Yndal/Dispenser-project/Designs/SparkFun/Hitec HS-35HD/hs-35hd pic.jpg

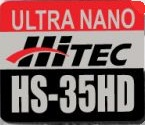
Designs/SparkFun/Hitec HS-35HD/hs-35hd pic.jpg
