Yndal/Dispenser-project/report/New structure/images/endstopLowered.png

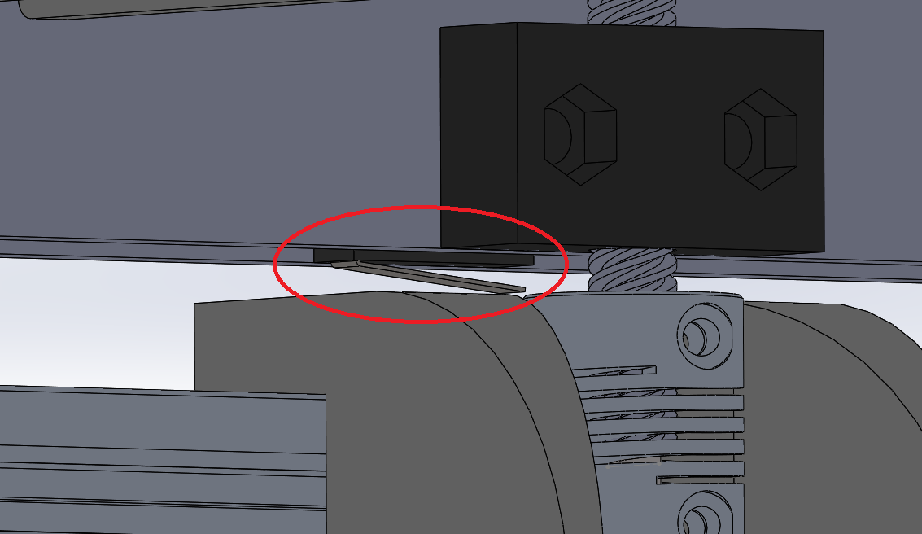
report/New structure/images/endstopLowered.png
