Yndal/Dispenser-project/Designs/Gripper/Xtreme V Wheel.SLDASM

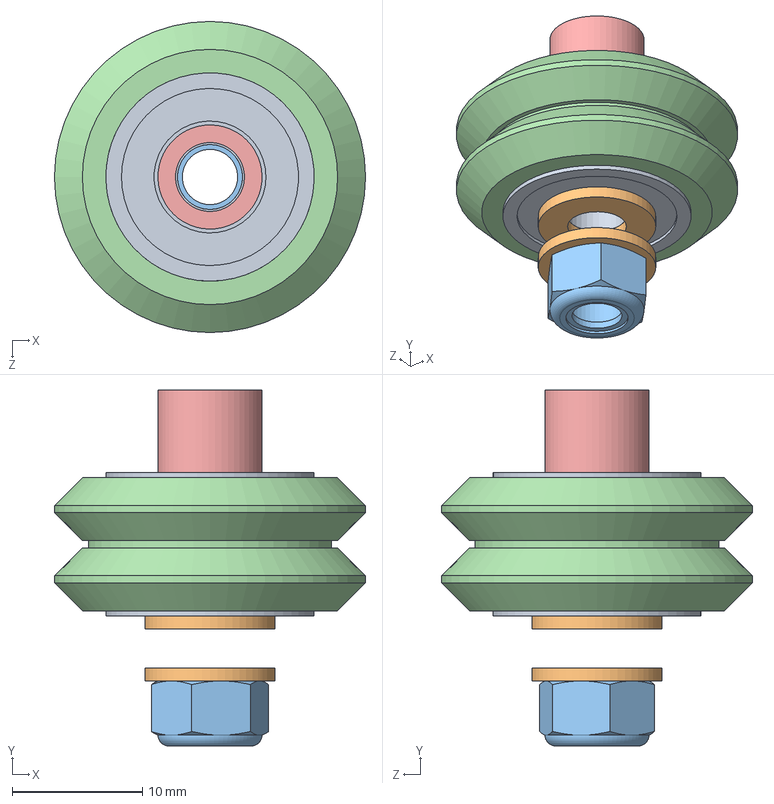
[picture p32: CAD file, 2016-06-13]
Designs/Gripper/Xtreme V Wheel.SLDASM
23.9 x 27.4 x 23.9 mm
Ball Bearing 5 x 16 x 5 x 2
Precision Shim 10 x 5 x 1 x 3
Nylon Insert Lock Nut M5
Delrin V Wheel
.25 Inch Aluminum Spacer
