Yndal/Dispenser-project/Designs/Horizontal axis/Horizontal_axis1.SLDASM

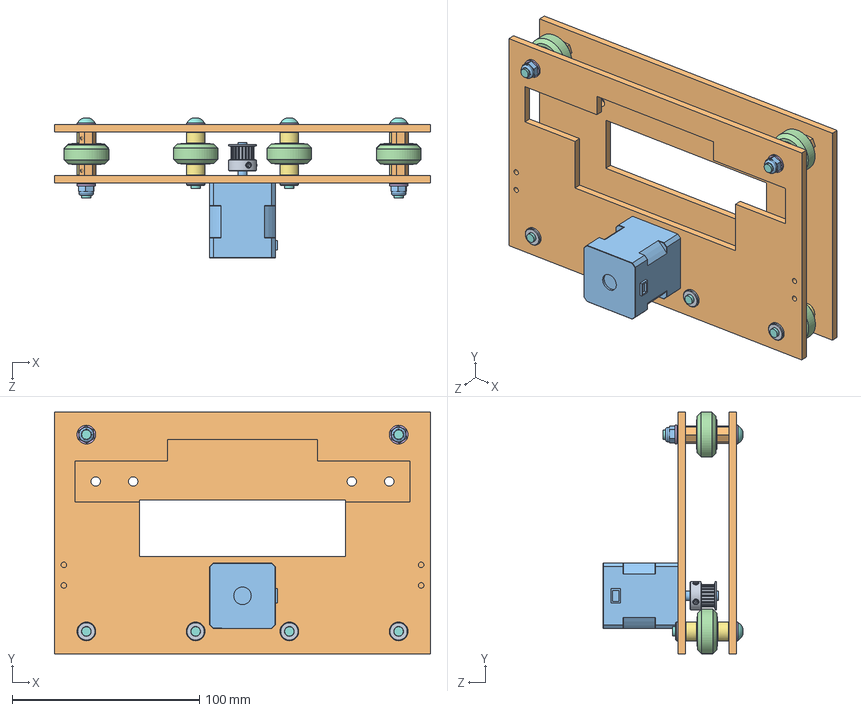
[picture p33: CAD file, 2016-06-13]
Designs/Horizontal axis/Horizontal_axis1.SLDASM
200.6 x 129.0 x 74.7 mm
GT2 2mm Aluminum Timing Pulley - 20 tooth
Horizontal_plate_front x 2
NEMA 14 Stepper Motor
Solid V Wheel x 6
Ball Bearing 5 x 16 x 5 x 12
Precision Shim 10 x 5 x 1 x 14
Aluminum Spacer 6mm x 8
screw x 6
insert_microbarb_0006M5-my x 4
Steel Eccentric Spacer x 4
nyloc x 2
