Yndal/Dispenser-project/Designs/StackPlatform/Stack_platform.SLDASM

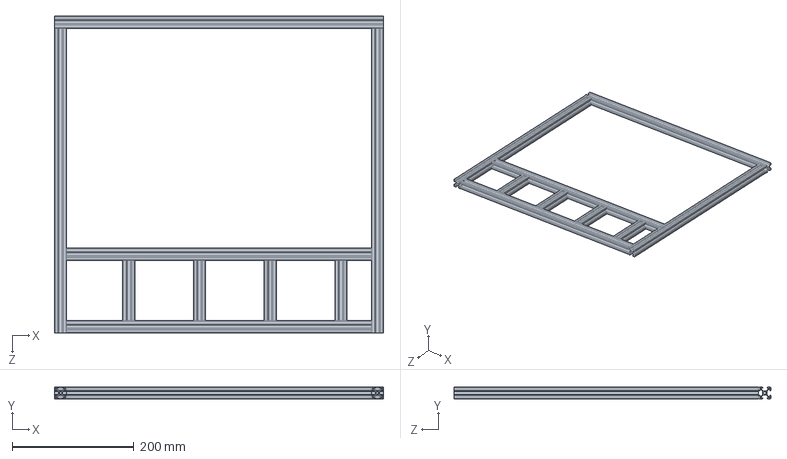
[picture p34: CAD file, 2016-06-13]
Designs/StackPlatform/Stack_platform.SLDASM
540.0 x 20.0 x 520.0 mm
V-Slot 20mm x 20mm x 1000mm x 9
