Yndal/Dispenser-project/Designs/SW2014 Parts Library 1.1 - orig/Assemblies/V Slot Belt and Pinion Actuator/Solid V Wheel assy.SLDASM

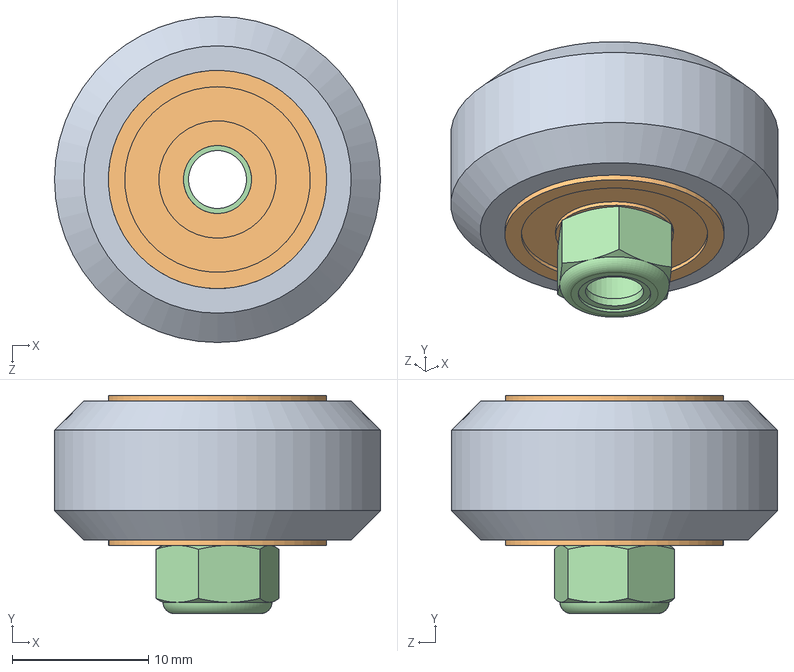
[picture p37: CAD file, 2016-04-22]
Designs/SW2014 Parts Library 1.1 - orig/Assemblies/V Slot Belt and Pinion Actuator/Solid V Wheel assy.SLDASM
23.9 x 16.0 x 23.9 mm
Solid V Wheel
Ball Bearing 5 x 16 x 5 x 2
Precision Shim 10 x 5 x 1
Nylon Insert Lock Nut M5
