Yndal/Dispenser-project/Designs/SW2014 Parts Library 1.1 - orig/Assemblies/Wheels/Xtreme Mini V Wheel.SLDASM

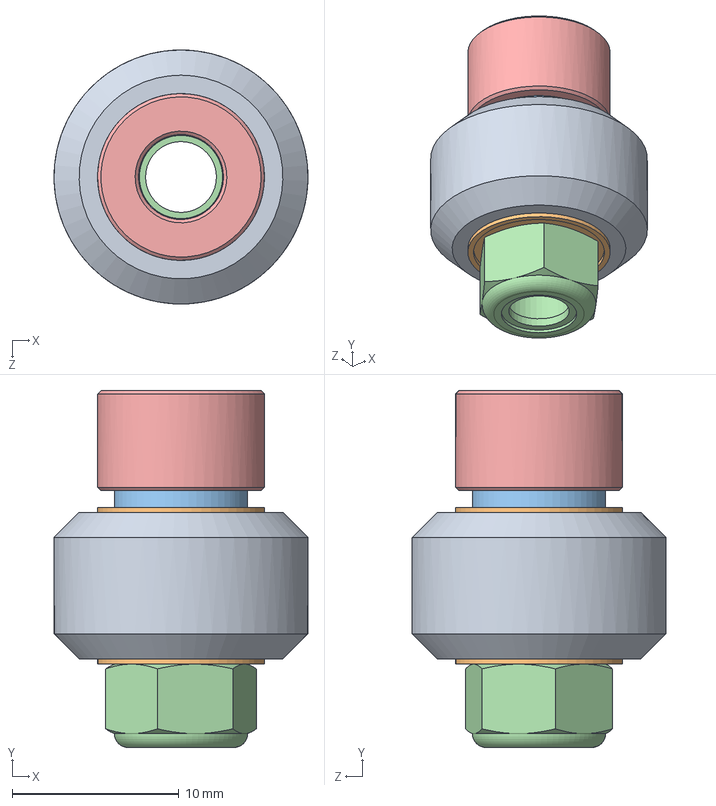
[picture p38: CAD file, 2016-04-22]
Designs/SW2014 Parts Library 1.1 - orig/Assemblies/Wheels/Xtreme Mini V Wheel.SLDASM
15.2 x 21.4 x 15.2 mm
Xtreme Mini V Wheel
Ball Bearing 5 x 10 x 4.2 x 2
Precision Shim 8 x 5 x 1 x 2
Nylon Insert Lock Nut M5
Aluminum Spacer 6mm
