Yndal/Dispenser-project/Designs/Gripper/Gripper.SLDASM

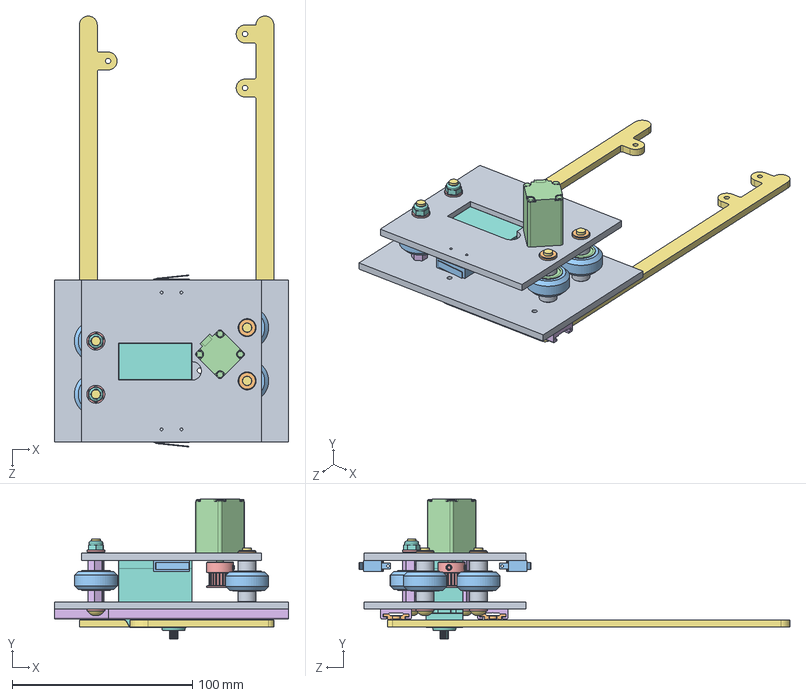
[picture p39: CAD file, 2016-06-13]
Designs/Gripper/Gripper.SLDASM
130.0 x 77.5 x 239.4 mm
MainPlate x 2
Sledge_NK_02_17_01_200_1 x 4
Solid V Wheel x 4
Ball Bearing 5 x 16 x 5 x 8
Precision Shim 10 x 5 x 1 x 10
Steel Eccentric Spacer x 4
screw x 4
nyloc x 2
Aluminum Spacer 6mm x 4
insert_microbarb_0006M5-my x 2
Micro Limit Switch x 2
NEMA 8 Stepper Motor (Pololu 1204)
GT2 2mm Aluminum Timing Pulley - 20 tooth
NS-01-17-100 x 2
Arm x 2
HX5010 SERVO
