Yndal/Dispenser-project/Designs/Horizontal axis/Horizontal_axis2.SLDASM

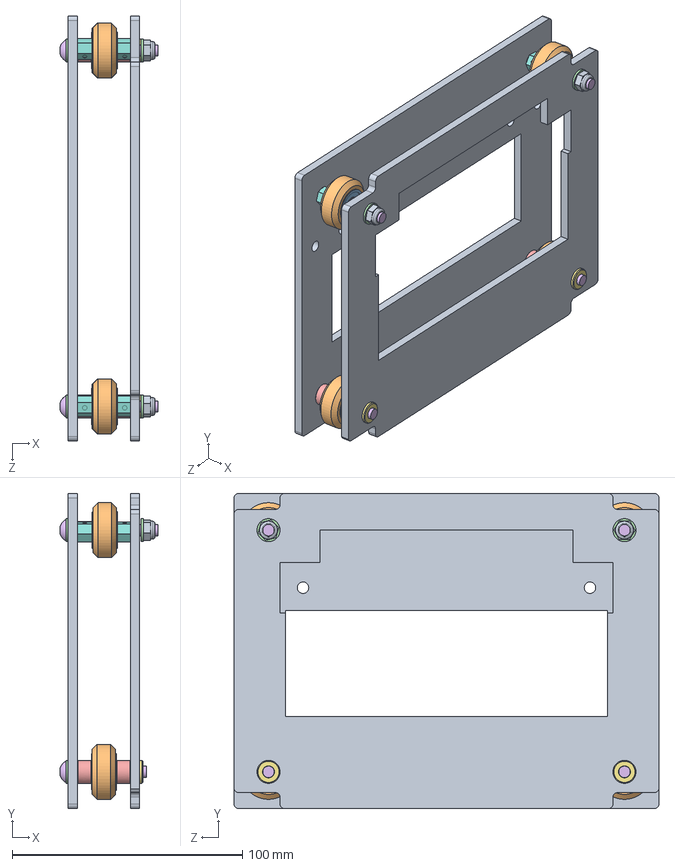
[picture p40: CAD file, 2016-06-13]
Designs/Horizontal axis/Horizontal_axis2.SLDASM
42.6 x 137.0 x 184.6 mm
Horizontal_plate_front x 2
Solid V Wheel x 4
Ball Bearing 5 x 16 x 5 x 8
Precision Shim 10 x 5 x 1 x 10
Aluminum Spacer 6mm x 4
screw x 4
insert_microbarb_0006M5-my x 2
Steel Eccentric Spacer x 4
nyloc x 2
