Yndal/Dispenser-project/Designs/SparkFun/Hitec HS-35HD/Hitec Ultra Nano HS-35HD.SLDASM

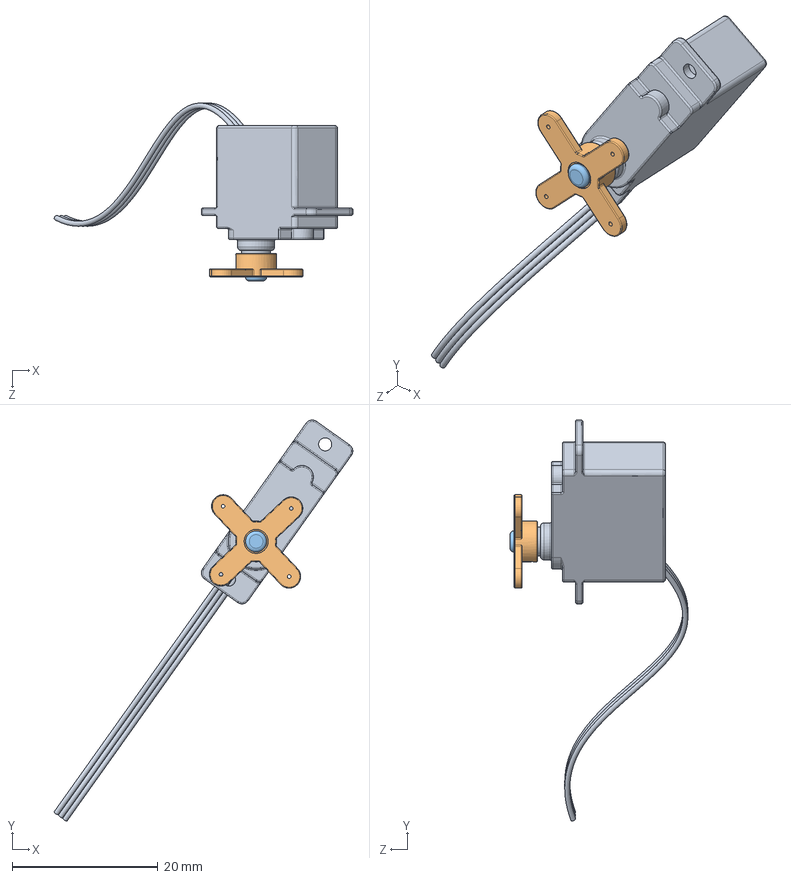
[picture p41: CAD file, 2016-04-22]
Designs/SparkFun/Hitec HS-35HD/Hitec Ultra Nano HS-35HD.SLDASM
40.9 x 54.9 x 24.4 mm
Hitec HS-35HD Ultra Nano Servo
servo horn
screw
