Yndal/Dispenser-project/Designs/SW2014 Parts Library 1.1 - orig/Assemblies/Wheels/Smooth Idler.SLDASM

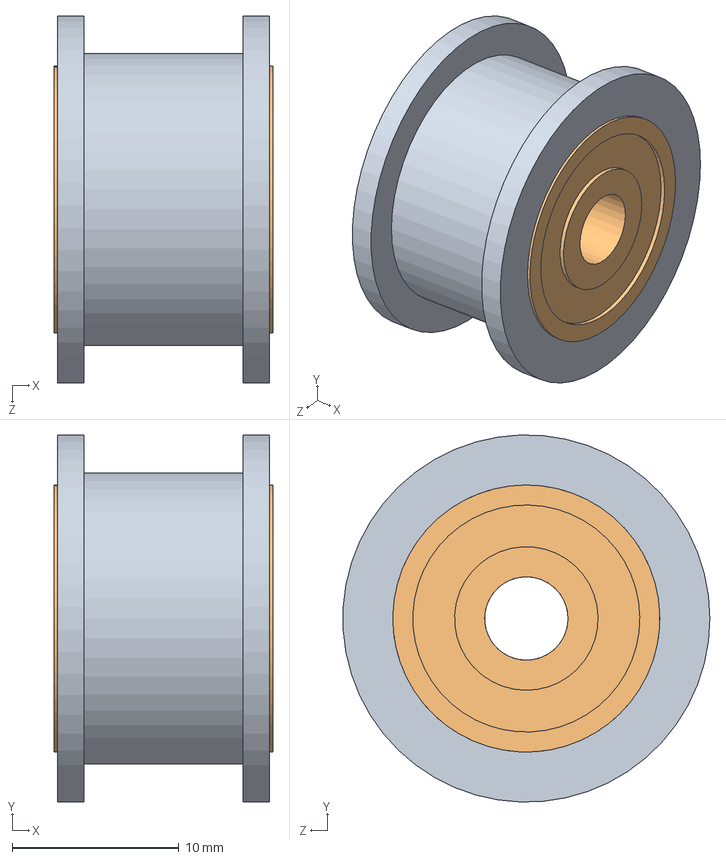
[picture p42: CAD file, 2016-04-22]
Designs/SW2014 Parts Library 1.1 - orig/Assemblies/Wheels/Smooth Idler.SLDASM
13.1 x 22.0 x 22.0 mm
Smooth Idler Pulley Wheel
Ball Bearing 5 x 16 x 5 x 2
Nylon Spacer 0.125in
