Yndal/Dispenser-project/Designs/Tests/WheelDist_20x40.SLDASM

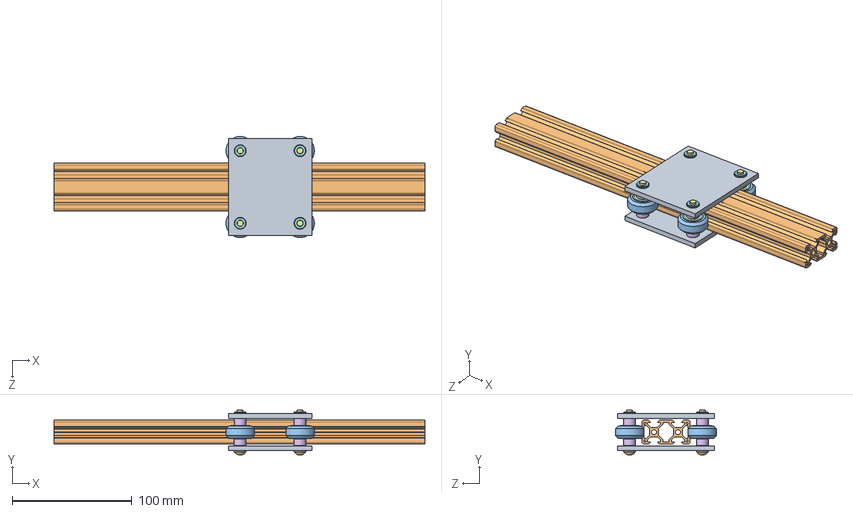
[picture p43: CAD file, 2016-04-22]
Designs/Tests/WheelDist_20x40.SLDASM
310.0 x 37.6 x 84.5 mm
Plate_20X40 x 2
V-Slot 20mm x 40mm x 465mm
Solid V Wheel x 4
Ball Bearing 5 x 16 x 5 x 8
Precision Shim 10 x 5 x 1 x 8
Aluminum Spacer 6mm x 8
screw x 4
insert_microbarb_0006M5-my x 4
