Yndal/Dispenser-project/Designs/Vertical axis/VertAxis.SLDASM

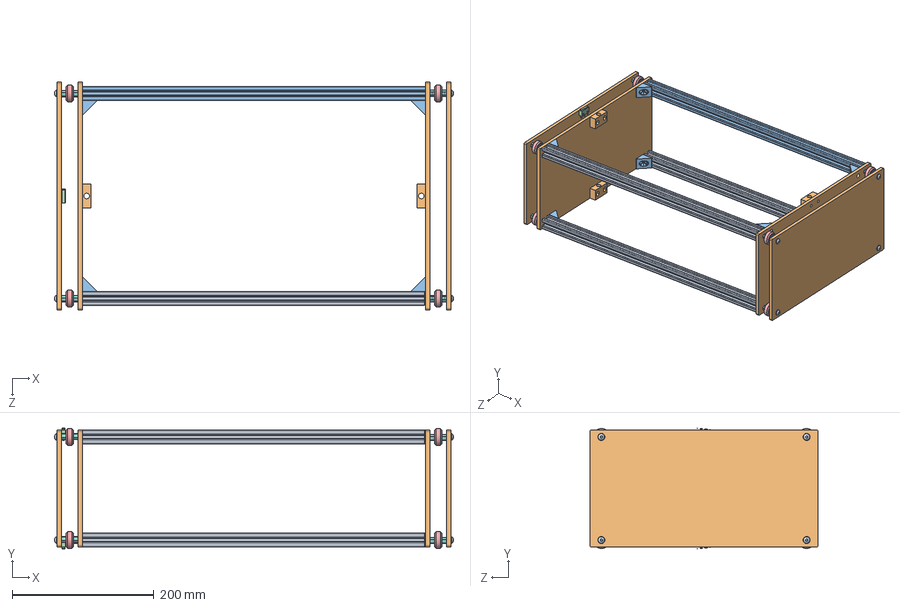
[picture p44: CAD file, 2016-06-13]
Designs/Vertical axis/VertAxis.SLDASM
563.6 x 170.4 x 321.8 mm
VertAxisAcrylic x 4
corner_connector_90deg x 8
Micro Limit Switch x 2
Solid V Wheel x 8
Ball Bearing 5 x 16 x 5 x 16
Precision Shim 10 x 5 x 1 x 16
Steel Eccentric Spacer x 16
screw x 8
8mm Acme Nut Block x 4
V-Slot 20mm x 20mm x 1000mm x 4
