Yndal/Dispenser-project/Designs/Gripper/MainPlate.SLDPRT

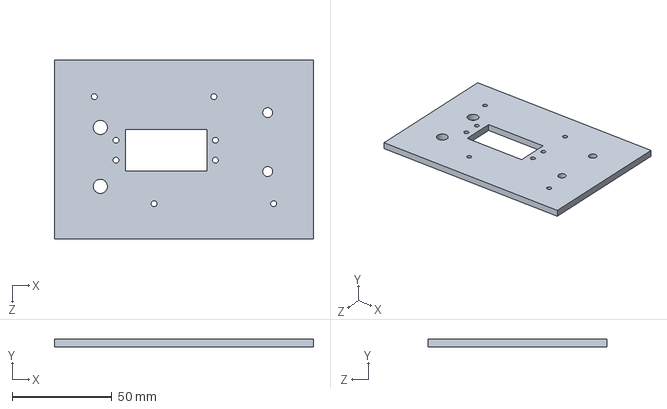
[picture p45: CAD file, 2016-06-13]
Designs/Gripper/MainPlate.SLDPRT
130.0 x 4.00 x 90.0 mm
