Yndal/Dispenser-project/Designs/OpenBuilds_r3/8 - Hardware/Lock Collar .25 inch.SLDASM

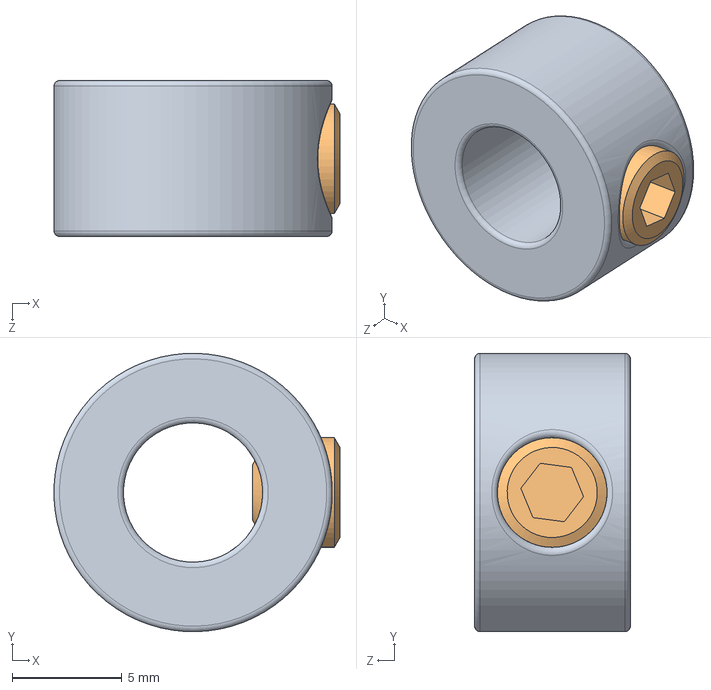
[picture p46: CAD file, 2016-04-22]
Designs/OpenBuilds_r3/8 - Hardware/Lock Collar .25 inch.SLDASM
13.0 x 12.7 x 7.11 mm
Lock Collar .25 inch
Socket Set Screw Cup Point_AM
