Yndal/Dispenser-project/Designs/Stack/Stack_wells.SLDASM

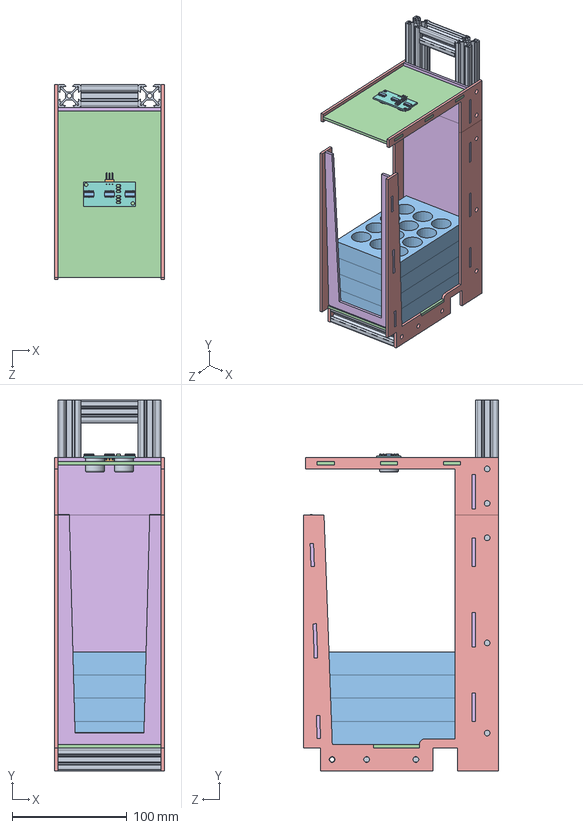
[picture p47: CAD file, 2016-06-13]
Designs/Stack/Stack_wells.SLDASM
96.0 x 323.0 x 170.0 mm
V-Slot 20mm x 20mm x 1000mm x 7
ElectronicsPlatform
Wells x 4
Top_wells x 2
Sides_wells x 2
FrontBack_wells x 2
EndPieceForElectronics
Parallax Ping PCB
Parallax Ping Transducer x 2
3 Pin Header 90 Degree
14 Pin SMT x 3
Cap1 SMT x 6
