Yndal/Dispenser-project/Designs/SW2014 Parts Library 1.1 - orig/Assemblies/V Slot Belt Driven Actuator/Nema 23 V Slot Belt Driven Actuator 500mm.SLDASM

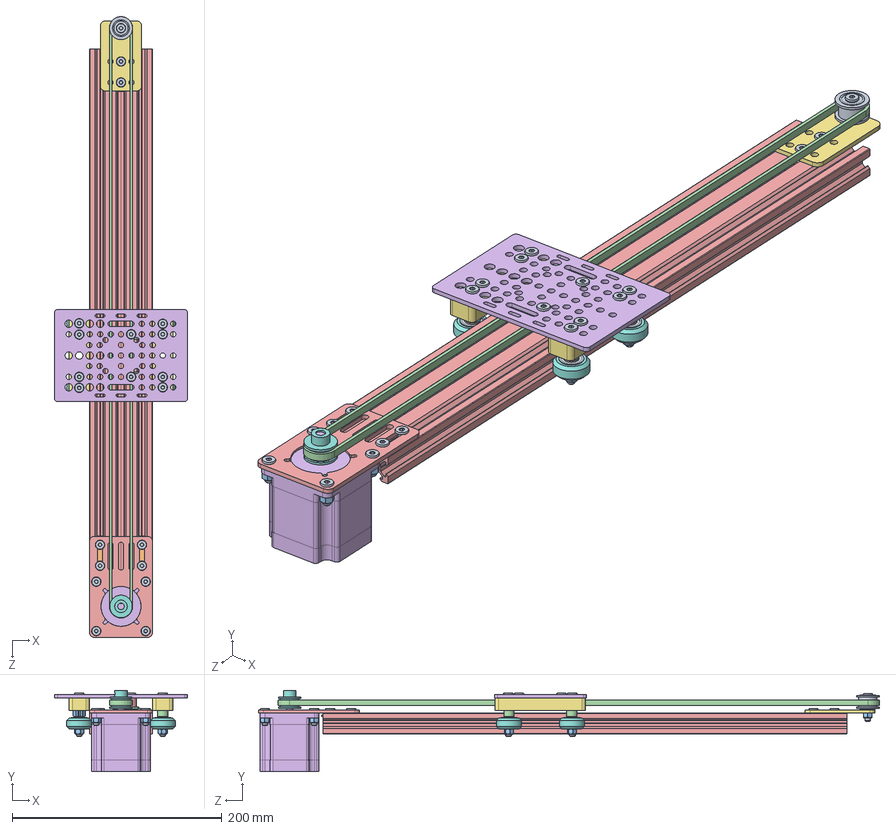
[picture p50: CAD file, 2016-04-22]
Designs/SW2014 Parts Library 1.1 - orig/Assemblies/V Slot Belt Driven Actuator/Nema 23 V Slot Belt Driven Actuator 500mm.SLDASM
127.0 x 77.6 x 592.7 mm
Low Profile Screw M5 x 21
Double Tee Nut x 3
Nylon Insert Lock Nut M5 x 9
Tee Nut x 2
V-Slot 20x60x500 Linear Rail
V-Slot Gantry Plate 20-80mm
Spacer Block x 2
Solid V Wheel x 4
Ball Bearing 5 x 16 x 5 x 10
Precision Shim 10 x 5 x 1 x 8
Eccentric Spacer 6mm x 2
Aluminum Spacer 6mm x 2
Motor Mount Plate Nema 23
Nema 23 Stepper Motor
Idler Pulley Plate
GT3 Timing Pulley 20 Tooth
Smooth Idler Pulley Wheel
Nylon Spacer 0.125in
Precision Shim 8 x 5 x 1
GT3 Belt 1160mm
Aluminum Spacer 9mm x 2
