Yndal/Dispenser-project/Designs/Horizontal axis/Horizontal_axis.SLDASM

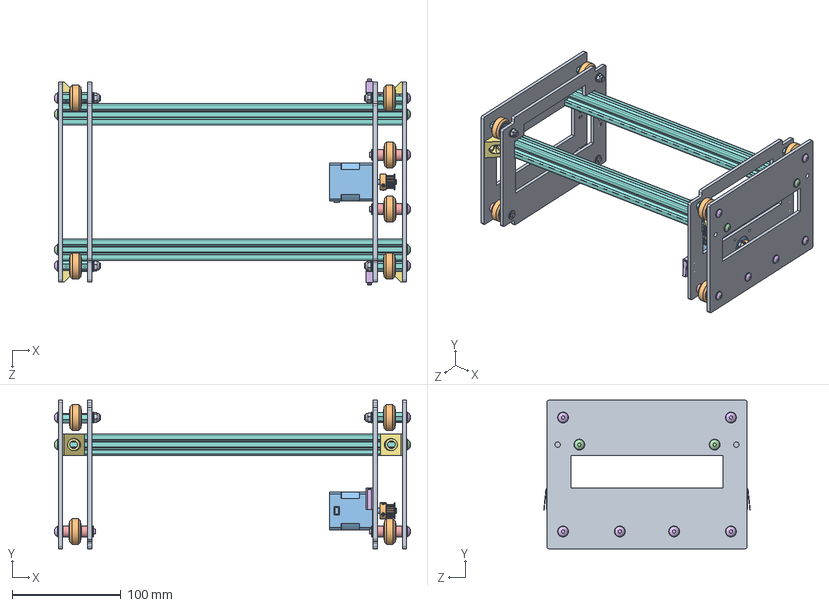
[picture p51: CAD file, 2016-06-13]
Designs/Horizontal axis/Horizontal_axis.SLDASM
328.0 x 137.0 x 190.2 mm
Horizontal_plate_front x 4
Solid V Wheel x 10
Ball Bearing 5 x 16 x 5 x 20
Precision Shim 10 x 5 x 1 x 24
Aluminum Spacer 6mm x 12
screw x 10
insert_microbarb_0006M5-my x 6
Steel Eccentric Spacer x 8
nyloc x 4
GT2 2mm Aluminum Timing Pulley - 20 tooth
NEMA 14 Stepper Motor
button_screw x 4
washer x 4
Micro Limit Switch x 2
corner_connector_90deg x 4
V-Slot 20mm x 20mm x 1000mm x 2
