Yndal/Dispenser-project/Designs/SW2014 Parts Library 1.1 - orig/Assemblies/Wheels/Xtreme V Wheel.SLDASM

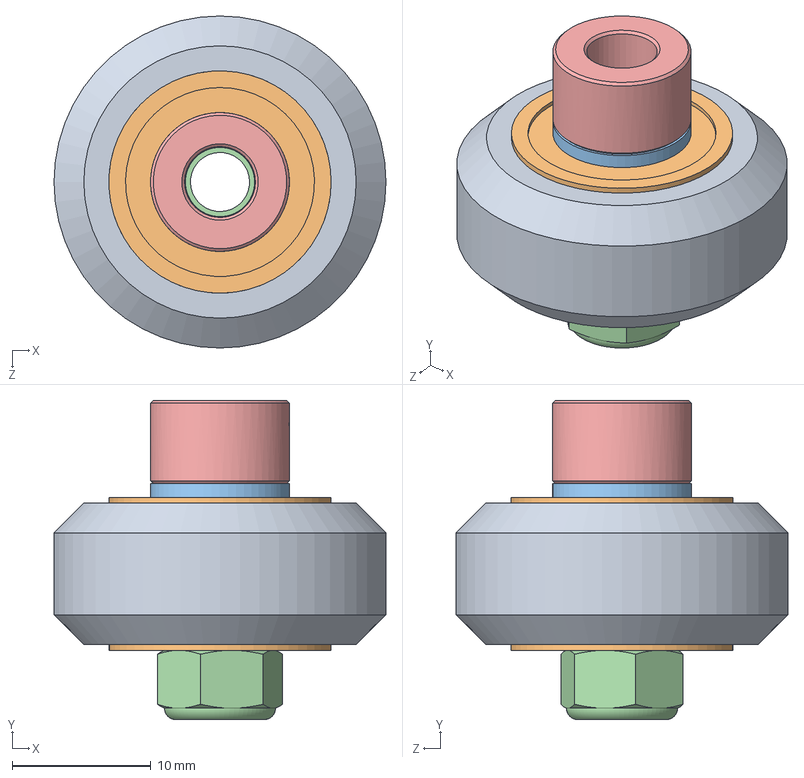
[picture p55: CAD file, 2016-04-22]
Designs/SW2014 Parts Library 1.1 - orig/Assemblies/Wheels/Xtreme V Wheel.SLDASM
23.9 x 23.0 x 23.9 mm
Xtreme Solid V Wheel
Ball Bearing 5 x 16 x 5 x 2
Precision Shim 10 x 5 x 1 x 2
Nylon Insert Lock Nut M5
Aluminum Spacer 6mm
