Yndal/Dispenser-project/Designs/OpenBuilds_r3/8 - Hardware/.25 inch x 5mm Flexible Coupling.SLDASM

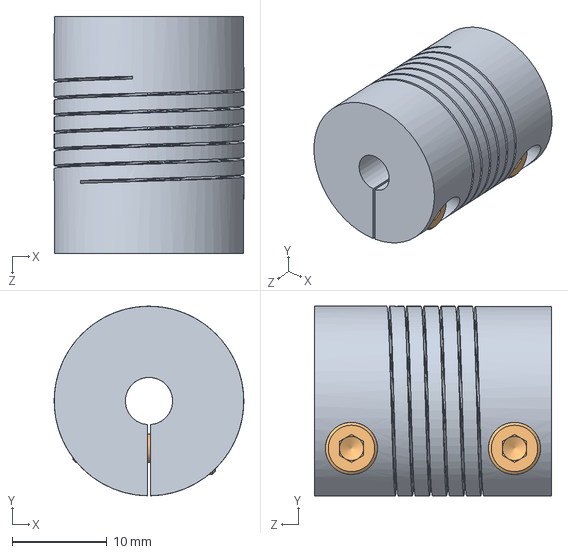
[picture p56: CAD file, 2016-04-22]
Designs/OpenBuilds_r3/8 - Hardware/.25 inch x 5mm Flexible Coupling.SLDASM
20.0 x 20.0 x 25.0 mm
.25 inch x 5mm Flexible Coupling
Socket Head Cap Screw_AM x 2
