Yndal/Dispenser-project/Designs/OpenBuilds_r3/9 - Plates/Universal Build Plate with Delrin V-Wheels for 40mm V-Slot.SLDASM

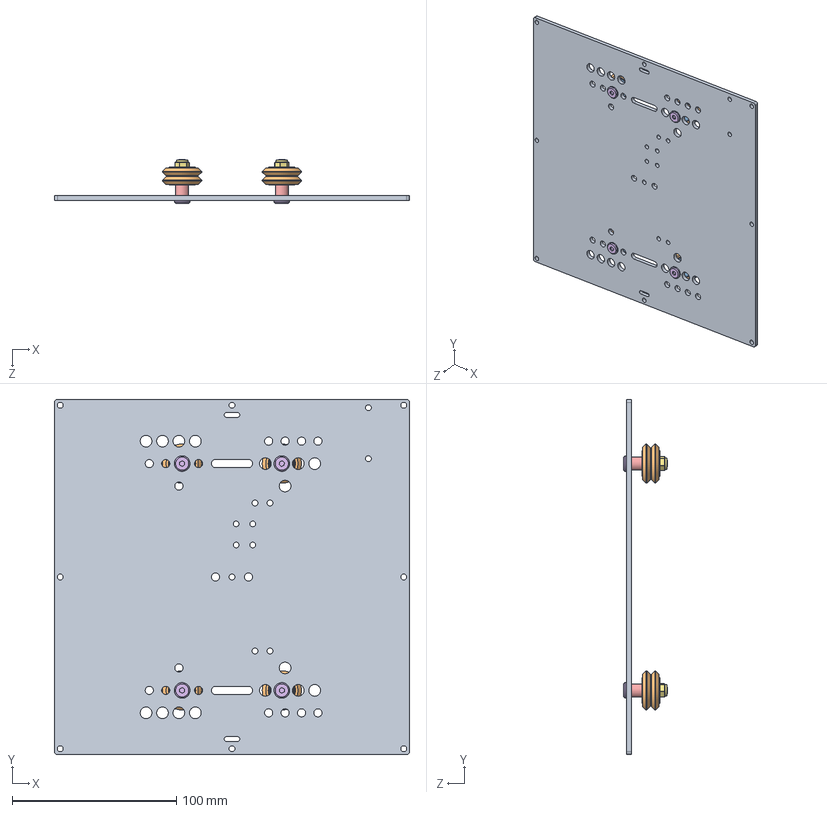
[picture p57: CAD file, 2016-04-22]
Designs/OpenBuilds_r3/9 - Plates/Universal Build Plate with Delrin V-Wheels for 40mm V-Slot.SLDASM
216.0 x 216.0 x 26.8 mm
V-Slot Universal Build Plate
Delrin Dual V-Wheel x 4
Precision Ball Bearing x 8
5mm Precision Washer x 4
.25 Inch Aluminum Spacer x 4
5mm Low Profile Socket Head Screw - Multiple Lengths x 4
Nylon Insert Hex Locknut 5mm x 4
