Yndal/Dispenser-project/Designs/OpenBuilds_r3/Assemblies/V-Slot Delrin Dual Wheel Bracket Assembly1.SLDASM

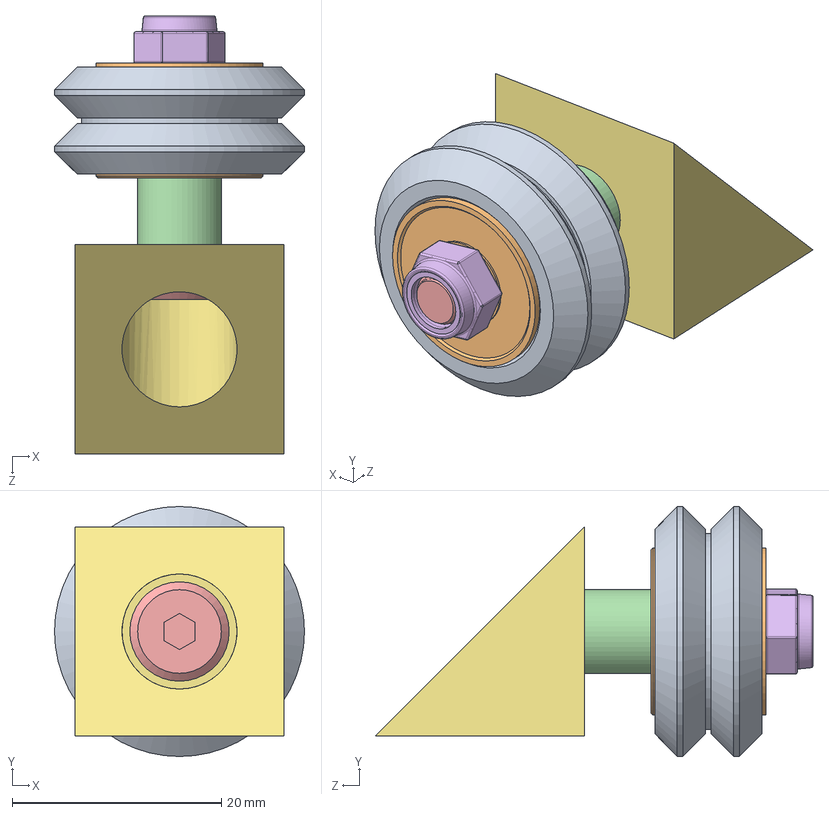
[picture p58: CAD file, 2016-04-22]
Designs/OpenBuilds_r3/Assemblies/V-Slot Delrin Dual Wheel Bracket Assembly1.SLDASM
23.9 x 23.9 x 41.8 mm
Delrin Dual V-Wheel
Precision Ball Bearing x 2
5mm Precision Washer
.25 Inch Aluminum Spacer
5mm Low Profile Socket Head Screw - Multiple Lengths
Nylon Insert Hex Locknut 5mm
90 Degree Angle Corner Connectr - V-Slot
