Yndal/Dispenser-project/Designs/OpenBuilds_r3/7 - Electronics/NEMA 17 Stepper Motor Assembly.STEP

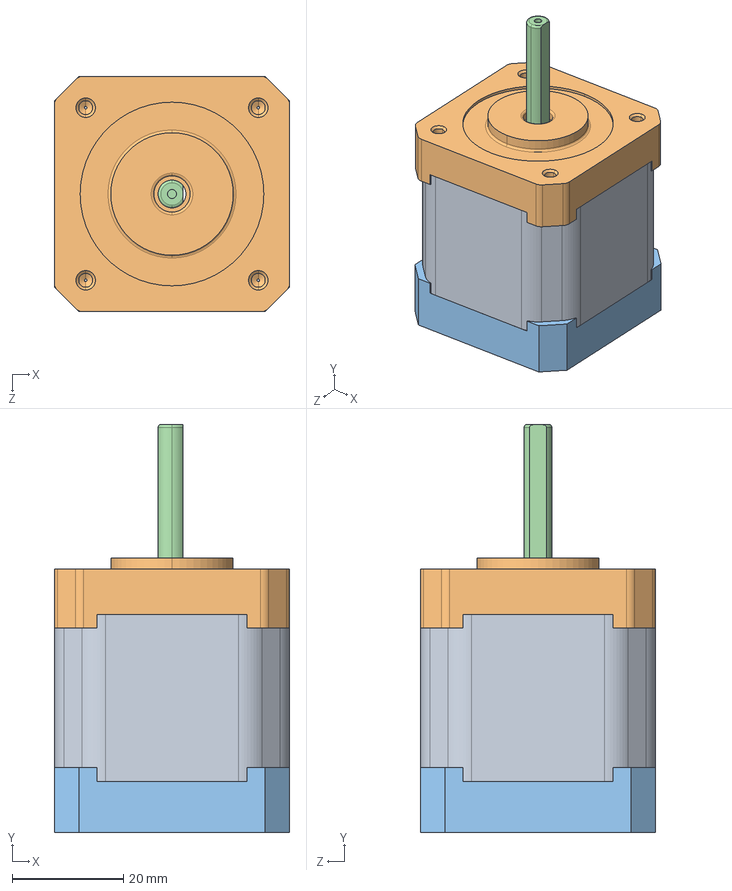
[picture p59: CAD file, 2016-04-22]
Designs/OpenBuilds_r3/7 - Electronics/NEMA 17 Stepper Motor Assembly.STEP
42.3 x 73.3 x 42.3 mm
NEMA 17 Stepper Motor Middle
NEMA 17 Stepper Motor Top
NEMA 17 Stepper Motor Bottom
NEMA 17 Stepper Motor Shaft
pan cross head_am_B18.6.7M - M2.5 x 0.45 x 13 Type I Cross Recessed PHMS --13N x 4
