Yndal/Dispenser-project/Designs/OpenBuilds_r3/8 - Hardware/Mounting Hub 5mm.SLDASM

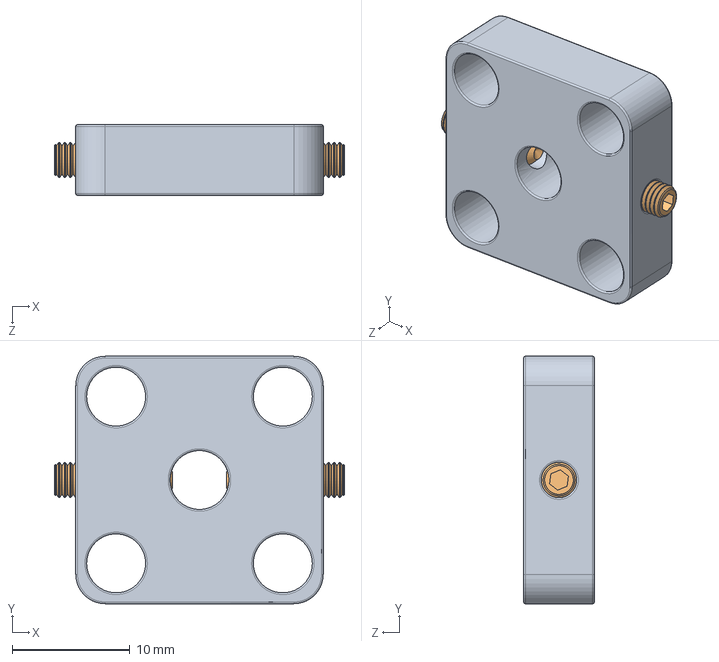
[picture p60: CAD file, 2016-04-22]
Designs/OpenBuilds_r3/8 - Hardware/Mounting Hub 5mm.SLDASM
24.6 x 21.0 x 6.00 mm
Mounting Hub 5mm
Socket Set Screw Cup Point_AM x 2
