Yndal/Dispenser-project/Designs/OpenBuilds_r3/Assemblies/V-Slot Delrin Dual Wheel Assembly.SLDASM

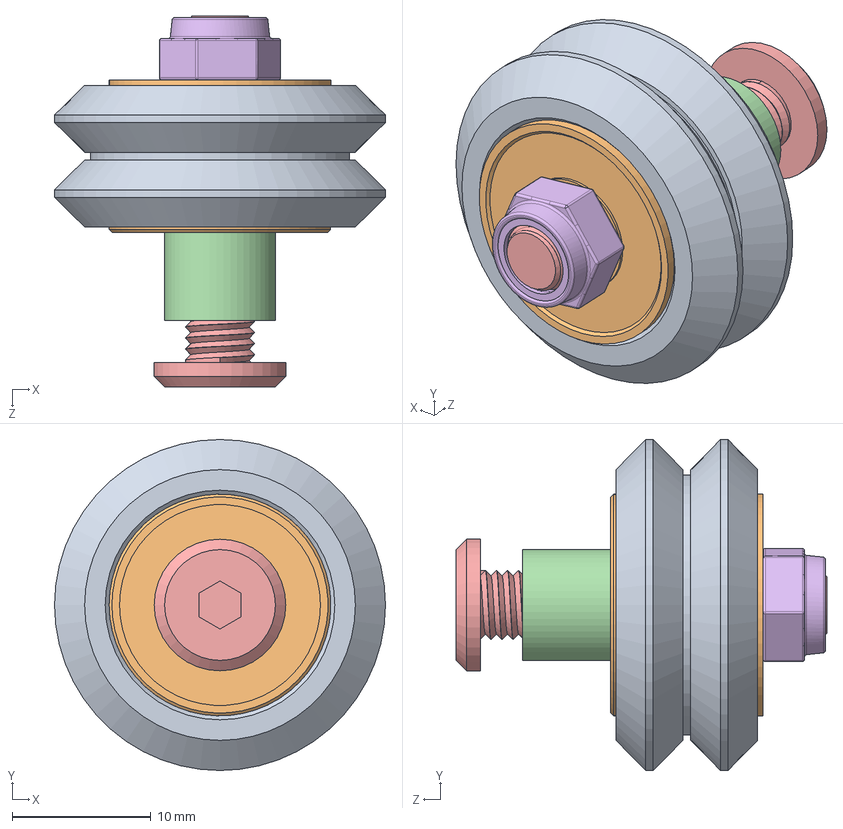
[picture p61: CAD file, 2016-04-22]
Designs/OpenBuilds_r3/Assemblies/V-Slot Delrin Dual Wheel Assembly.SLDASM
23.9 x 23.9 x 26.8 mm
Delrin Dual V-Wheel
Precision Ball Bearing x 2
5mm Precision Washer
.25 Inch Aluminum Spacer
5mm Low Profile Socket Head Screw - Multiple Lengths
Nylon Insert Hex Locknut 5mm
