Yndal/Dispenser-project/Designs/Stack/Stack.SLDASM

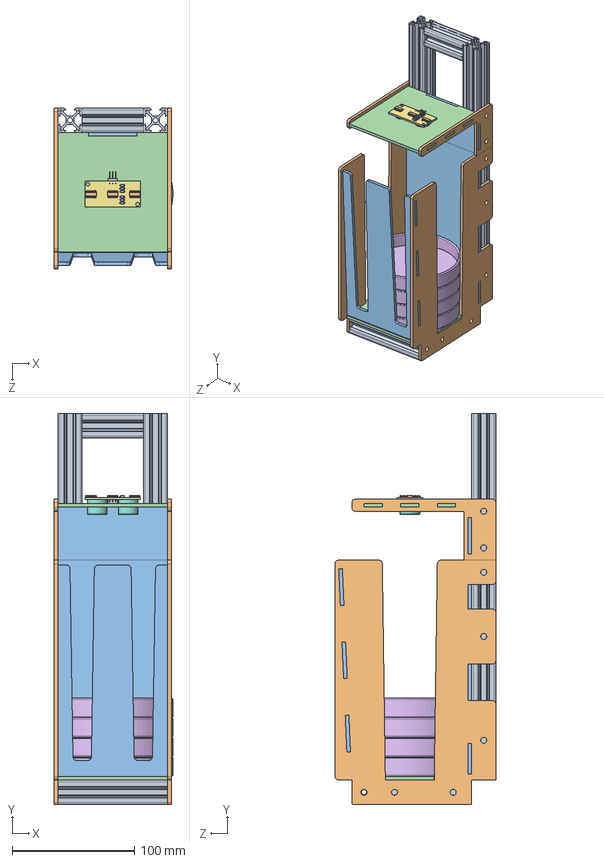
[picture p62: CAD file, 2016-06-13]
Designs/Stack/Stack.SLDASM
97.2 x 320.0 x 131.7 mm
V-Slot 20mm x 20mm x 1000mm x 7
Sides x 2
FrontBack x 2
Top x 2
ElectronicsPlatform
GlassDish x 4
Parallax Ping PCB
Parallax Ping Transducer x 2
3 Pin Header 90 Degree
14 Pin SMT x 3
Cap1 SMT x 6
