Yndal/Dispenser-project/Designs/User Library-Parallax Ping Sensor/Parallax Ping Sensor.sldasm

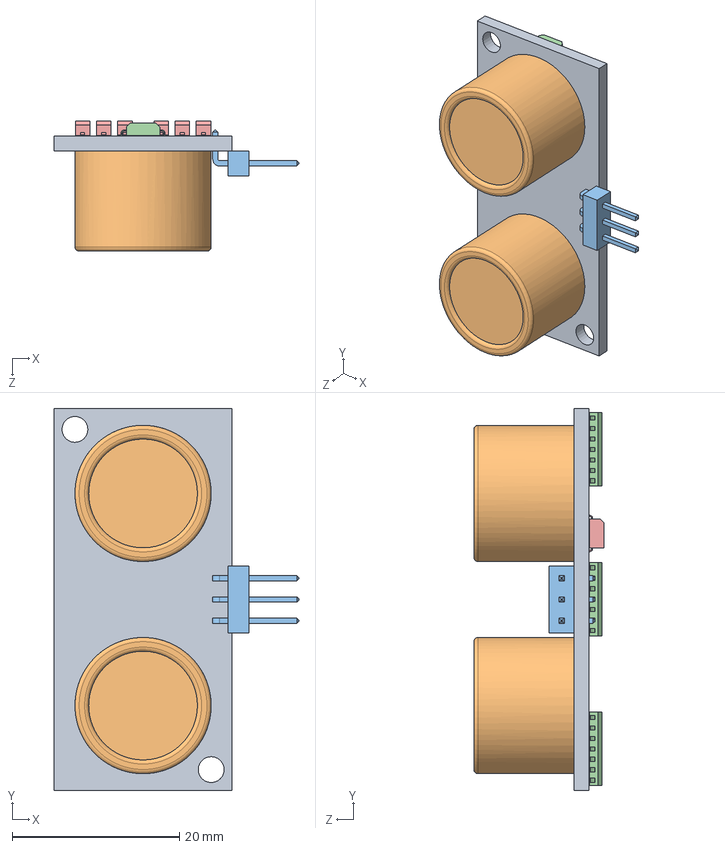
[picture p63: CAD file, 2016-06-13]
Designs/User Library-Parallax Ping Sensor/Parallax Ping Sensor.sldasm
29.3 x 45.7 x 15.6 mm
Parallax Ping PCB
Parallax Ping Transducer x 2
3 Pin Header 90 Degree
14 Pin SMT x 3
Cap1 SMT x 6
