Yndal/Dispenser-project/Designs/OpenBuilds_r3/8 - Hardware/5mm x 8mm Flexible Coupling.SLDASM

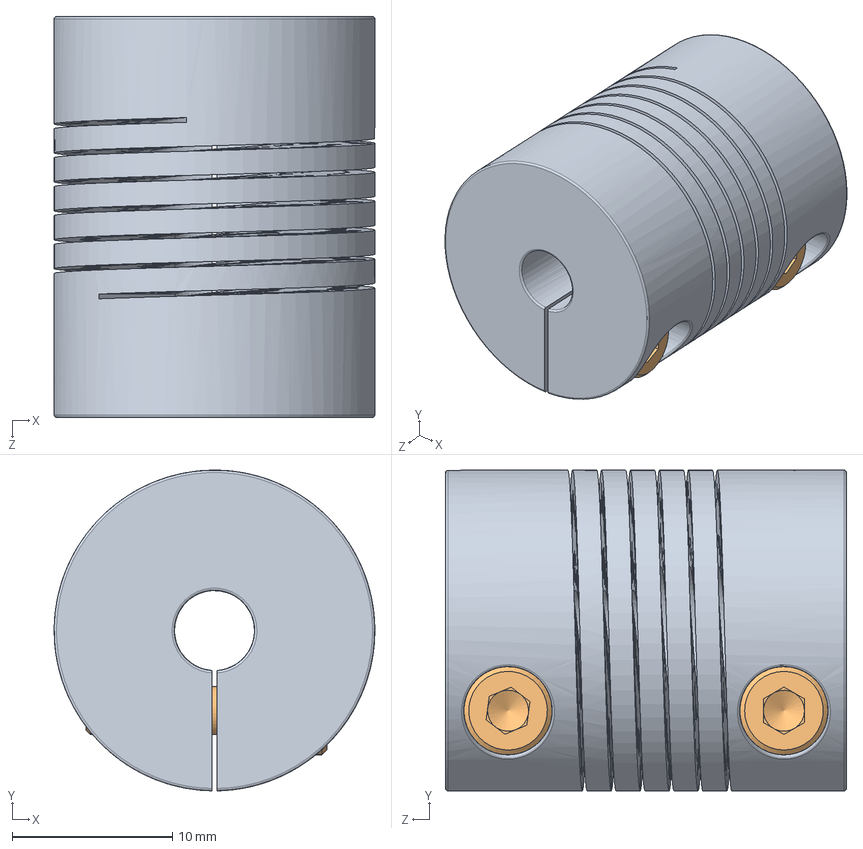
[picture p64: CAD file, 2016-04-22]
Designs/OpenBuilds_r3/8 - Hardware/5mm x 8mm Flexible Coupling.SLDASM
20.0 x 20.0 x 25.0 mm
5mm x 8mm Flexible Coupling
Socket Head Cap Screw_AM x 2
