Yndal/Dispenser-project/Designs/OpenBuilds_r3/Assemblies/Idler Wheel Assembly.SLDASM

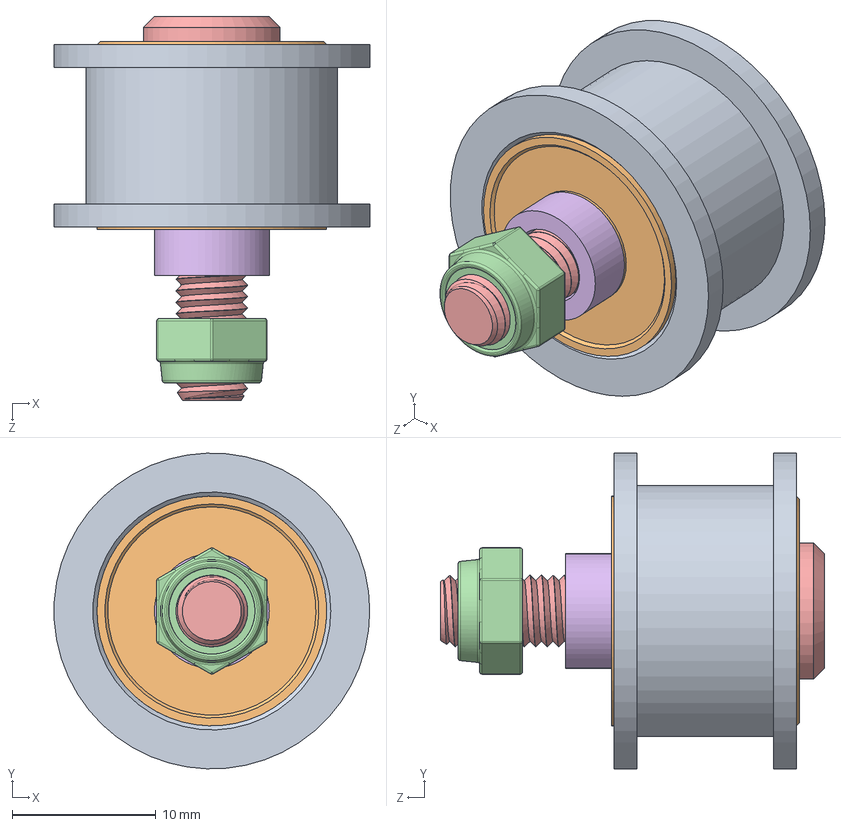
[picture p65: CAD file, 2016-04-22]
Designs/OpenBuilds_r3/Assemblies/Idler Wheel Assembly.SLDASM
22.0 x 22.0 x 26.8 mm
V-Slot Idler Pulley
Precision Ball Bearing x 2
5mm Precision Washer
Nylon Insert Hex Locknut 5mm
5mm x 25mm Low Profile Socket Head Screw
.125 Inch Aluminum Spacer
