Yndal/Dispenser-project/Designs/OpenBuilds_r3/9 - Plates/V-Slot Machine 1.SLDASM

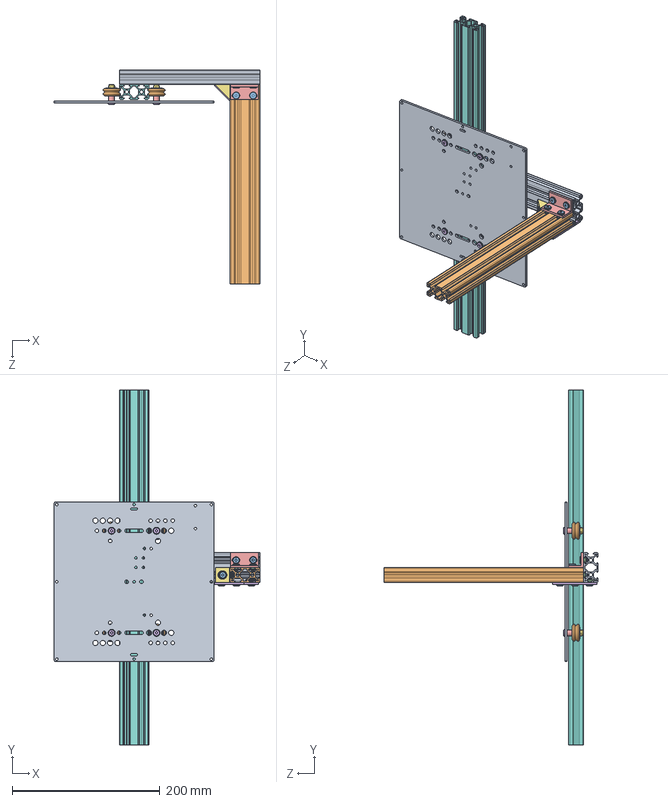
[picture p66: CAD file, 2016-04-22]
Designs/OpenBuilds_r3/9 - Plates/V-Slot Machine 1.SLDASM
278.0 x 480.0 x 290.0 mm
V-Slot Universal Build Plate
Delrin Dual V-Wheel x 4
Precision Ball Bearing x 8
5mm Precision Washer x 4
.25 Inch Aluminum Spacer x 4
5mm Low Profile Socket Head Screw - Multiple Lengths x 4
Nylon Insert Hex Locknut 5mm x 4
20mm x 40mm x 560mm Extrusion
20mm x 40mm x170mm Extrusion
20mm x 40mm x270mm Extrusion
5mm x 8mm Low Profile Socket Head Screw x 11
Tee nut x 11
Universal L Bracket - Double
5 Hole 90 Degree Joining Plate
corner_connector_90deg
