Yndal/Dispenser-project/Designs/OpenBuilds_r3/9 - Plates/20mm x 20m Extruder Arm.SLDASM

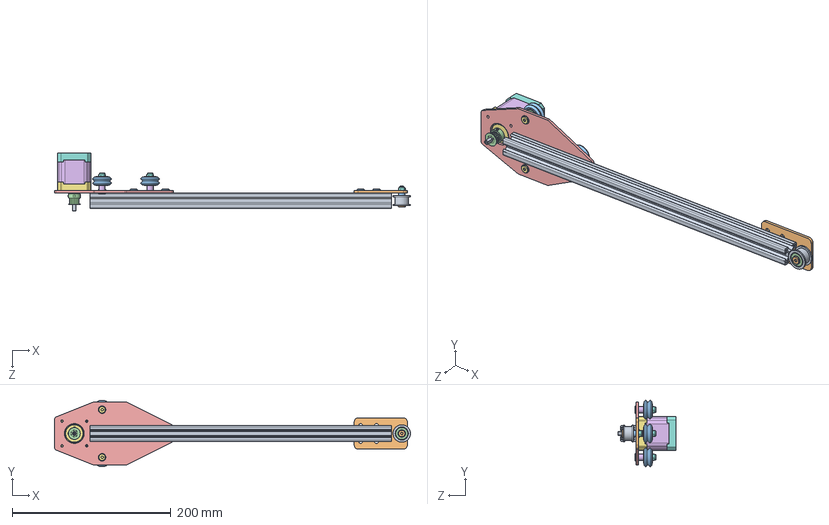
[picture p67: CAD file, 2016-04-22]
Designs/OpenBuilds_r3/9 - Plates/20mm x 20m Extruder Arm.SLDASM
449.0 x 83.9 x 73.3 mm
20mm x 20mm x 380mm
V-Slot Idler Pulley Plate
5mm x 8mm Low Profile Socket Head Screw x 5
Tee nut x 5
Custom Extruder Arm Plate
NEMA 17 Stepper Motor Middle
NEMA 17 Stepper Motor Top
NEMA 17 Stepper Motor Bottom
NEMA 17 Stepper Motor Shaft
pan cross head_am x 4
Delrin Dual V-Wheel x 3
Precision Ball Bearing x 8
5mm Precision Washer x 4
.25 Inch Aluminum Spacer x 3
5mm Low Profile Socket Head Screw - Multiple Lengths x 3
Nylon Insert Hex Locknut 5mm x 4
V-Slot Idler Pulley
5mm x 25mm Low Profile Socket Head Screw
.125 Inch Aluminum Spacer
GT2 2mm Aluminum Timing Pulley - 20 tooth
