Yndal/Dispenser-project/Designs/Dishes/Wells.SLDPRT

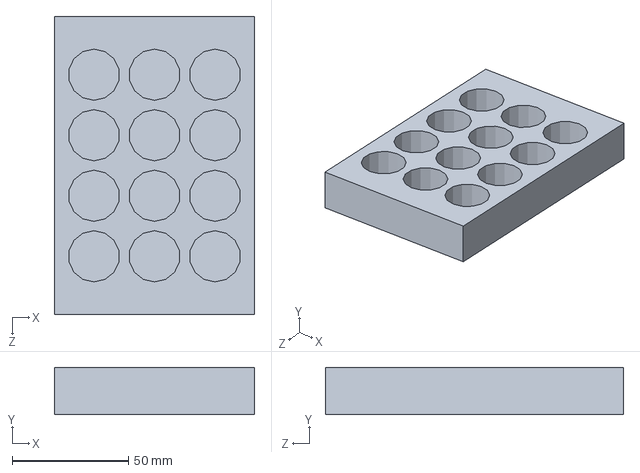
[picture p68: CAD file, 2016-04-22]
Designs/Dishes/Wells.SLDPRT
86.0 x 20.2 x 128.0 mm
