Yndal/Dispenser-project/Designs/Frame/V-Slot 20x20x500 Linear Rail -hori 1.SLDPRT

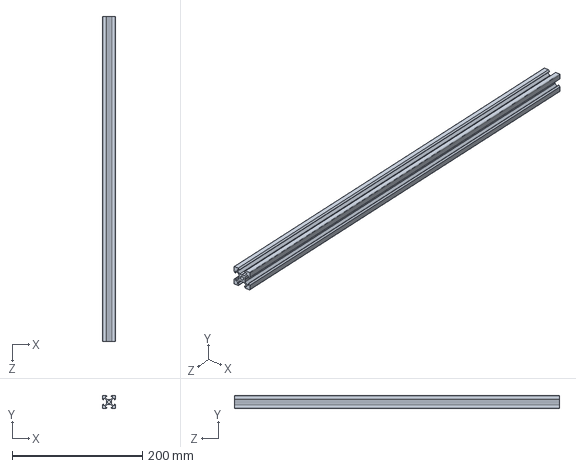
[picture p69: CAD file, 2016-06-13]
Designs/Frame/V-Slot 20x20x500 Linear Rail -hori 1.SLDPRT
20.0 x 20.0 x 500.0 mm
