Yndal/Dispenser-project/Designs/Gripper/Squeeze/Arm.SLDPRT

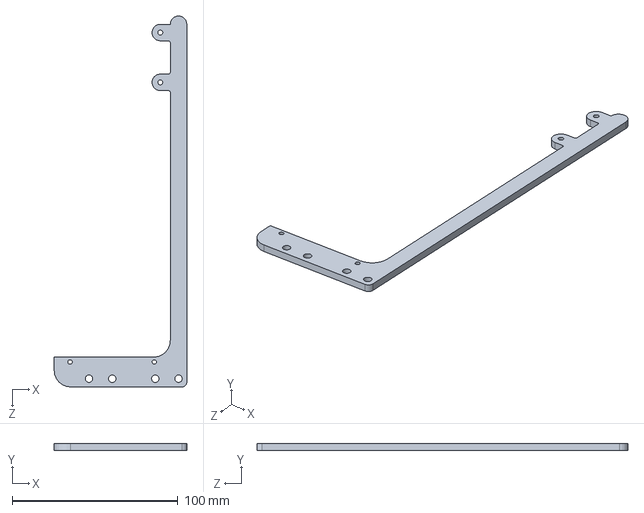
[picture p70: CAD file, 2016-06-13]
Designs/Gripper/Squeeze/Arm.SLDPRT
80.0 x 4.00 x 223.6 mm
