Yndal/Dispenser-project/Designs/Igus/Sledge_NK_02_17_01_200_1.SLDPRT

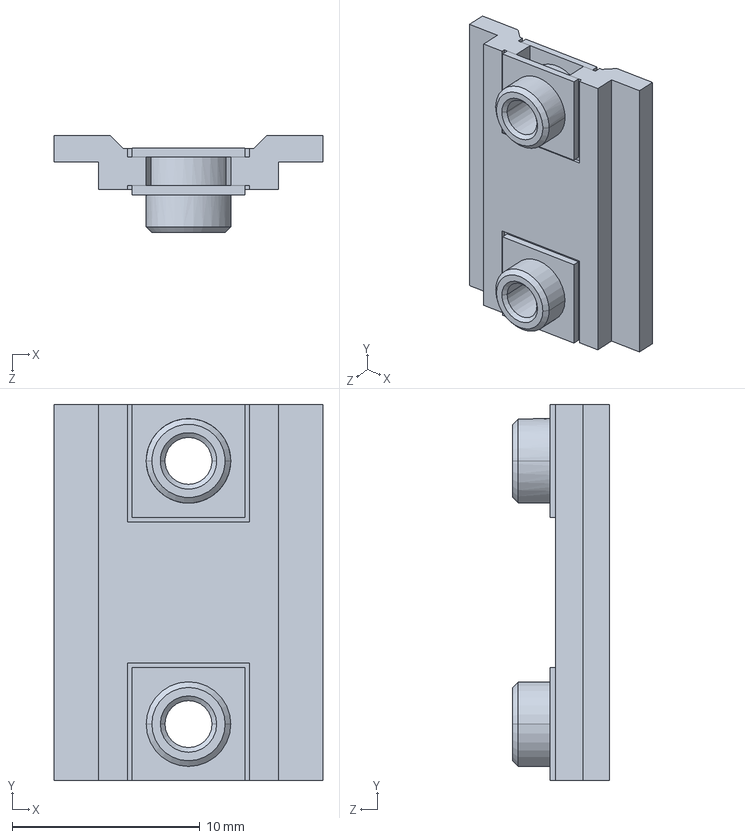
[picture p71: CAD file, 2016-04-22]
Designs/Igus/Sledge_NK_02_17_01_200_1.SLDPRT
14.3 x 20.0 x 5.15 mm
