Yndal/Dispenser-project/Designs/micro-metal-gearmotor-with-1086-bracket.step

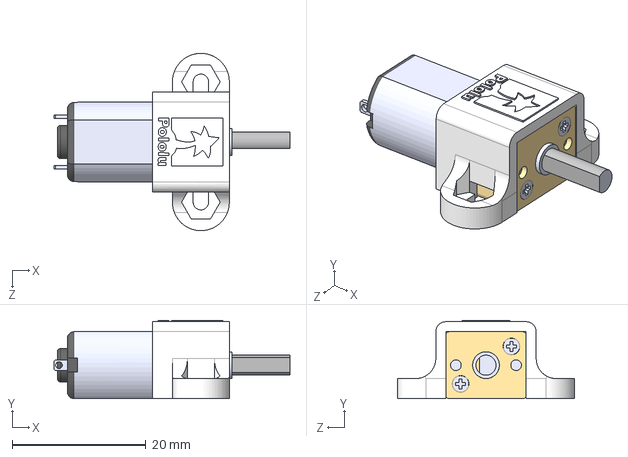
[picture p72: CAD file, 2016-04-22]
Designs/micro-metal-gearmotor-with-1086-bracket.step
35.3 x 11.7 x 26.5 mm
