Yndal/Dispenser-project/Designs/OpenBuilds_r3/1 - V-Slot/V-Slot 20mm x 20mm x 1000mm.SLDPRT

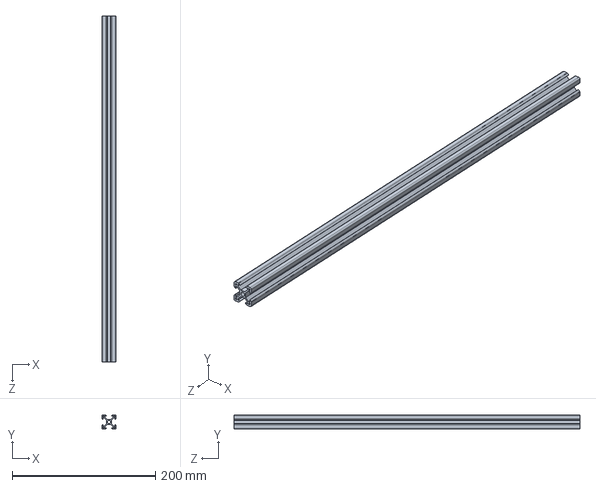
[picture p73: CAD file, 2016-06-13]
Designs/OpenBuilds_r3/1 - V-Slot/V-Slot 20mm x 20mm x 1000mm.SLDPRT
20.0 x 20.0 x 483.0 mm
