Yndal/Dispenser-project/Designs/OpenBuilds_r3/11 - Shims/Micro V Precision Shim.SLDPRT

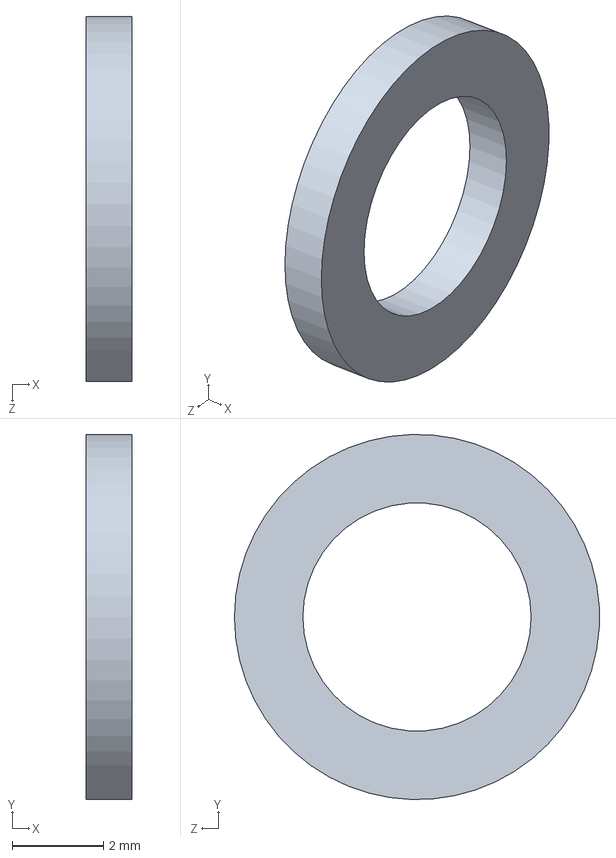
[picture p74: CAD file, 2016-04-22]
Designs/OpenBuilds_r3/11 - Shims/Micro V Precision Shim.SLDPRT
1.00 x 8.00 x 8.00 mm
