Yndal/Dispenser-project/Designs/OpenBuilds_r3/12 - Spacers/.125 Inch Aluminum Spacer.SLDPRT

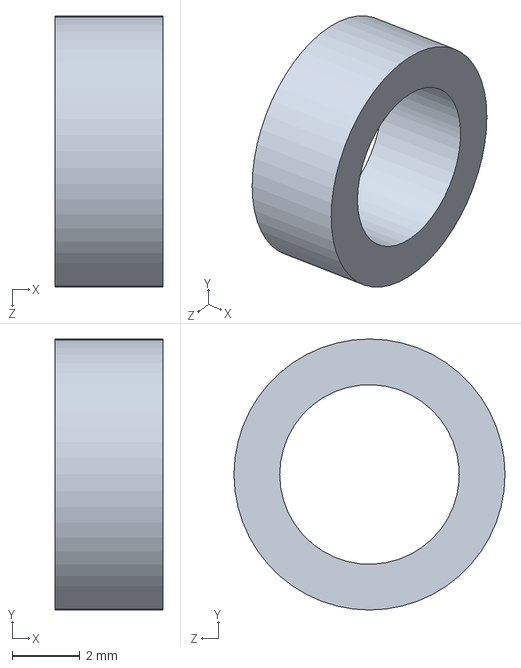
[picture p75: CAD file, 2016-04-22]
Designs/OpenBuilds_r3/12 - Spacers/.125 Inch Aluminum Spacer.SLDPRT
3.17 x 8.00 x 8.00 mm
