Yndal/Dispenser-project/Designs/OpenBuilds_r3/2 - OpenRail/Open Rail 1500mm.sldprt

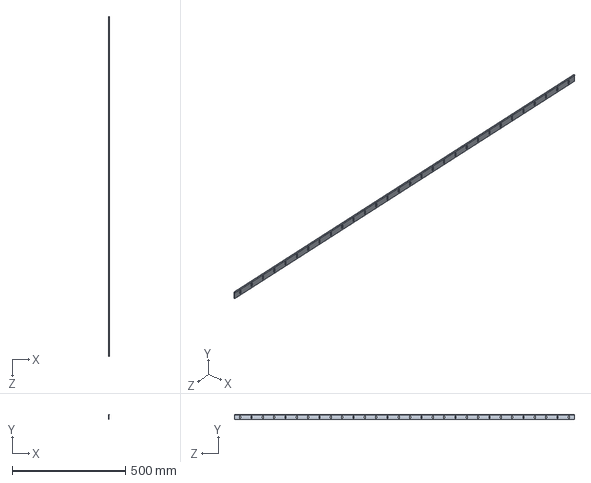
[picture p76: CAD file, 2016-04-22]
Designs/OpenBuilds_r3/2 - OpenRail/Open Rail 1500mm.sldprt
4.75 x 22.5 x 1500.0 mm
