Yndal/Dispenser-project/Designs/OpenBuilds_r3/3 - Wheels/Steel Dual V-Wheel.SLDPRT

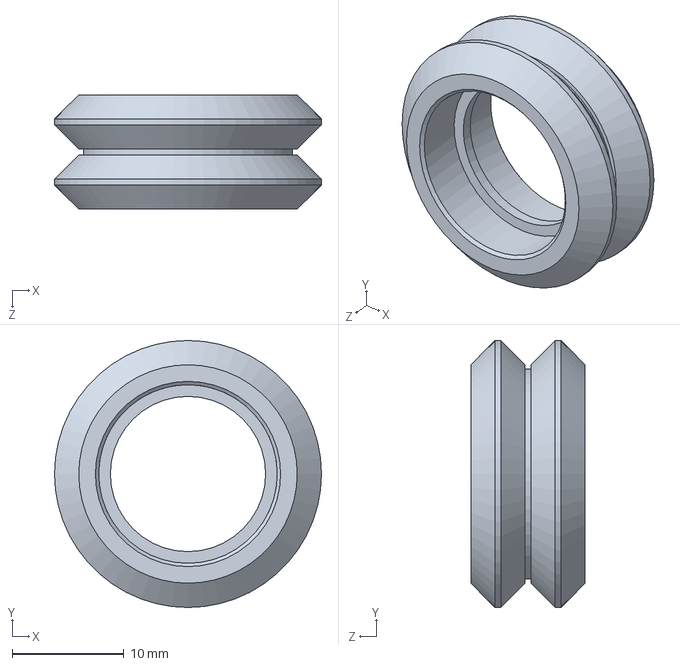
[picture p77: CAD file, 2016-04-22]
Designs/OpenBuilds_r3/3 - Wheels/Steel Dual V-Wheel.SLDPRT
23.9 x 23.9 x 10.2 mm
