Yndal/Dispenser-project/Designs/OpenBuilds_r3/4 - Bearings/Ball Bearing 688Z.SLDPRT

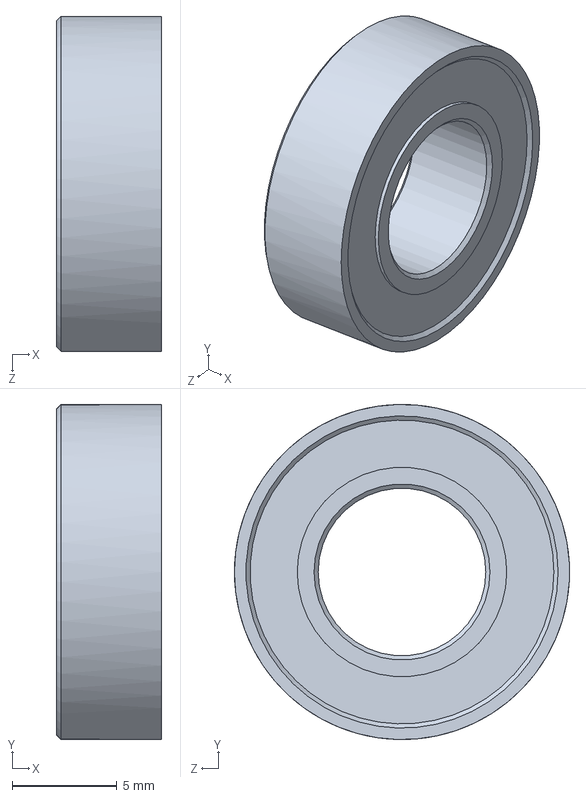
[picture p78: CAD file, 2016-04-22]
Designs/OpenBuilds_r3/4 - Bearings/Ball Bearing 688Z.SLDPRT
5.00 x 16.0 x 16.0 mm
