Yndal/Dispenser-project/Designs/OpenBuilds_r3/5 - Belts and Pulleys/GT2 2mm Aluminum Timing Pulley - 20 tooth.SLDPRT

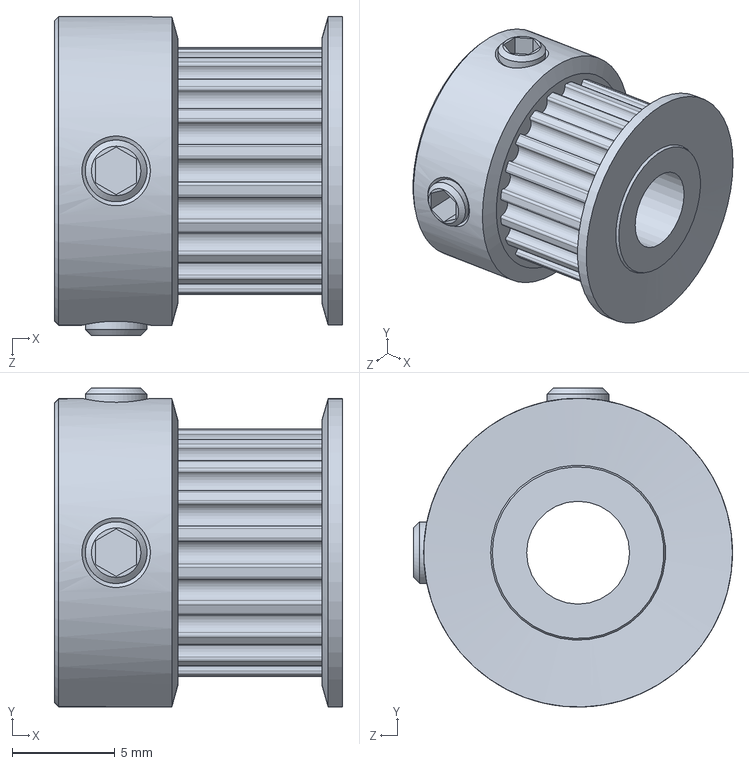
[picture p79: CAD file, 2016-04-22]
Designs/OpenBuilds_r3/5 - Belts and Pulleys/GT2 2mm Aluminum Timing Pulley - 20 tooth.SLDPRT
14.0 x 15.5 x 15.5 mm
