Yndal/Dispenser-project/Designs/OpenBuilds_r3/6 - Brackets/3 Way Cube Corner Connector - V-Slot.SLDPRT

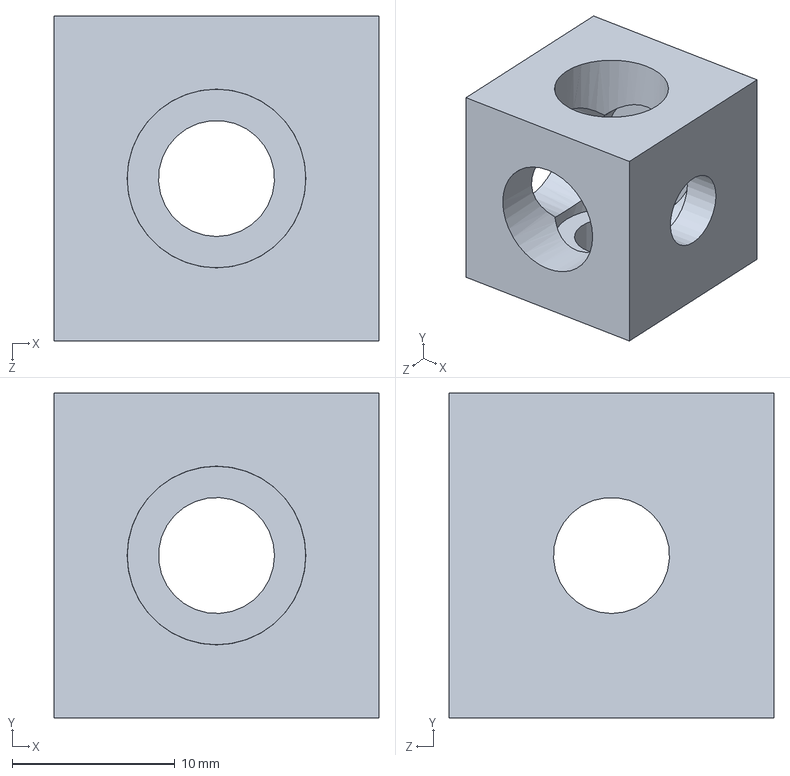
[picture p80: CAD file, 2016-04-22]
Designs/OpenBuilds_r3/6 - Brackets/3 Way Cube Corner Connector - V-Slot.SLDPRT
20.0 x 20.0 x 20.0 mm
