Yndal/Dispenser-project/Designs/OpenBuilds_r3/7 - Electronics/NEMA 17 Stepper Motor Top.SLDPRT

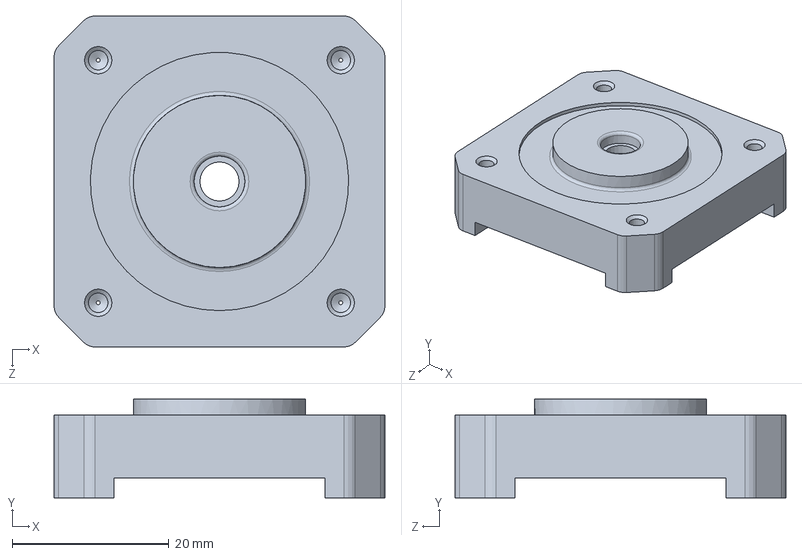
[picture p81: CAD file, 2016-06-13]
Designs/OpenBuilds_r3/7 - Electronics/NEMA 17 Stepper Motor Top.SLDPRT
42.3 x 12.6 x 42.3 mm
