Yndal/Dispenser-project/Designs/OpenBuilds_r3/9 - Plates/V-Slot Idler Pulley Plate.SLDPRT

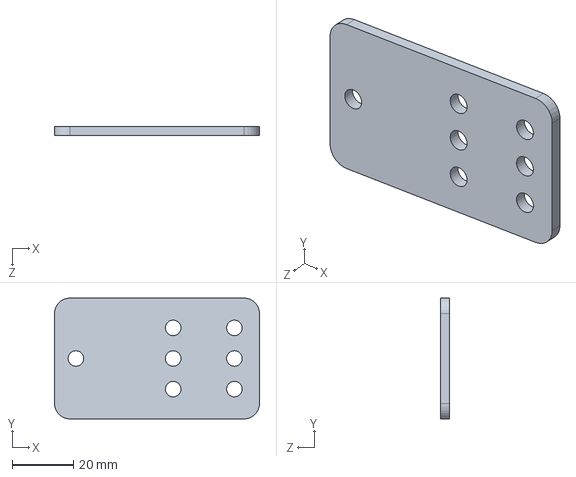
[picture p82: CAD file, 2016-04-22]
Designs/OpenBuilds_r3/9 - Plates/V-Slot Idler Pulley Plate.SLDPRT
67.0 x 39.5 x 3.00 mm
