Yndal/Dispenser-project/Designs/OpenBuilds_r3/HX5010 SERVO.stp

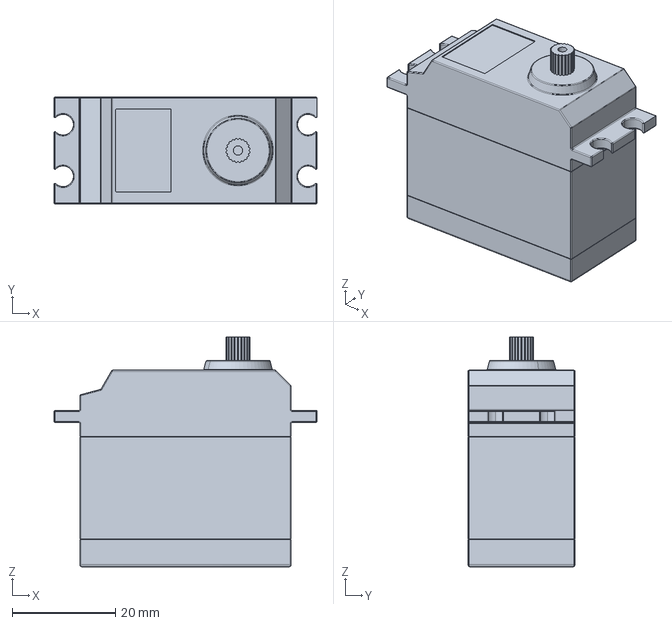
[picture p83: CAD file, 2016-04-22]
Designs/OpenBuilds_r3/HX5010 SERVO.stp
50.9 x 20.7 x 44.5 mm
