Yndal/Dispenser-project/Designs/SparkFun/Hitec HS-35HD/Hitec HS-35HD Ultra Nano Servo.SLDPRT

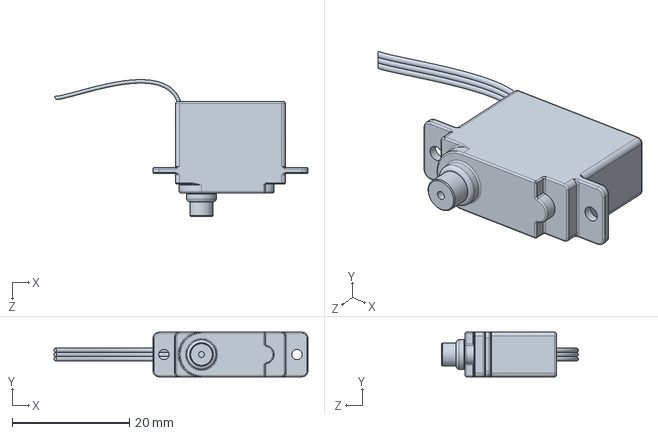
[picture p84: CAD file, 2016-04-22]
Designs/SparkFun/Hitec HS-35HD/Hitec HS-35HD Ultra Nano Servo.SLDPRT
43.4 x 7.62 x 23.4 mm
