Yndal/Dispenser-project/Designs/Stack/FrontBack_wells.SLDPRT

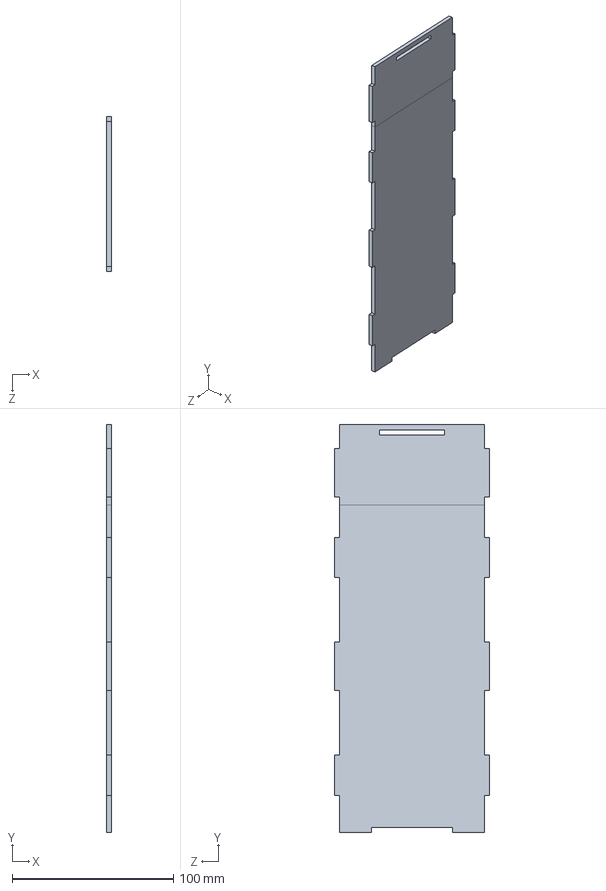
[picture p85: CAD file, 2016-06-13]
Designs/Stack/FrontBack_wells.SLDPRT
3.00 x 253.0 x 96.0 mm
