Yndal/Dispenser-project/Designs/SW2014 Parts Library 1.1 - orig/10 - Shims and Spacers/Aluminum Spacer 35mm.SLDPRT

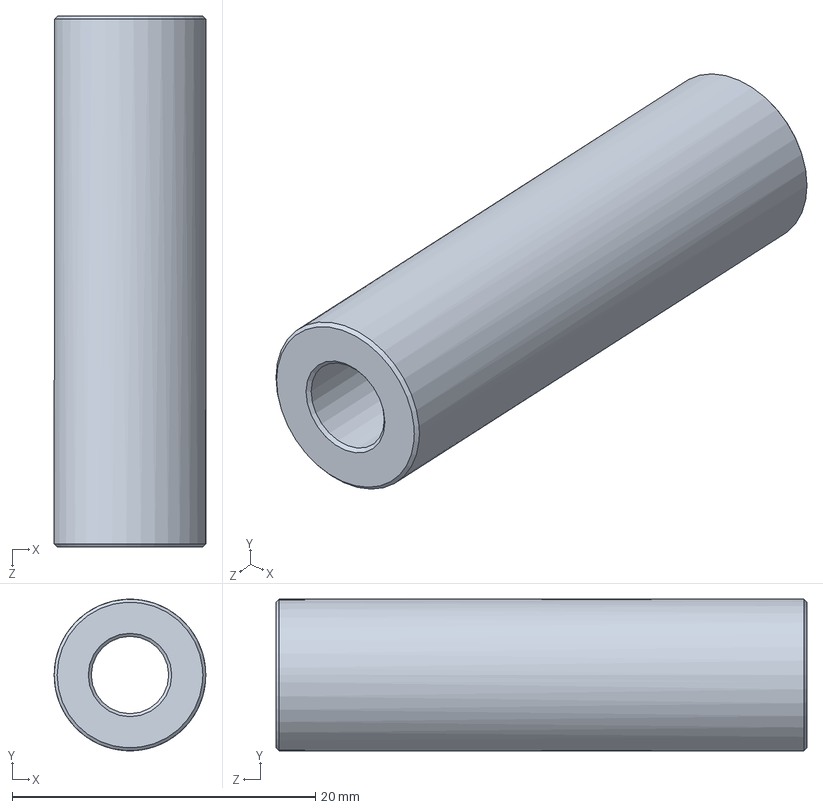
[picture p87: CAD file, 2016-04-22]
Designs/SW2014 Parts Library 1.1 - orig/10 - Shims and Spacers/Aluminum Spacer 35mm.SLDPRT
10.0 x 9.99 x 35.0 mm
