Yndal/Dispenser-project/Designs/SW2014 Parts Library 1.1 - orig/2 - Wheels/Xtreme Solid V Wheel.SLDPRT

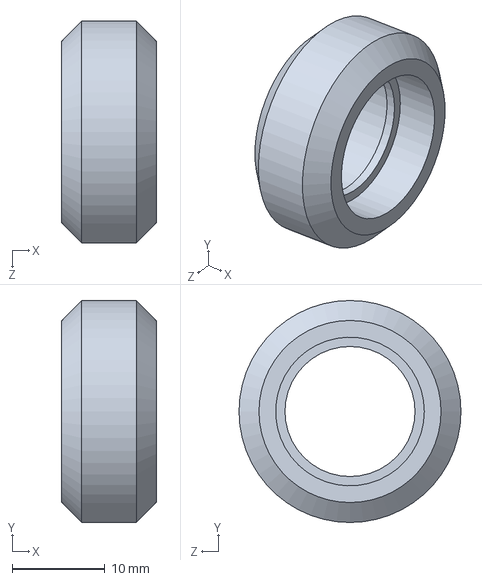
[picture p88: CAD file, 2016-04-22]
Designs/SW2014 Parts Library 1.1 - orig/2 - Wheels/Xtreme Solid V Wheel.SLDPRT
10.2 x 23.9 x 23.9 mm
