Yndal/Dispenser-project/Designs/SW2014 Parts Library 1.1 - orig/3 - Bearings/Ball Bearing 0.25 x 0.625 x 0.196.SLDPRT

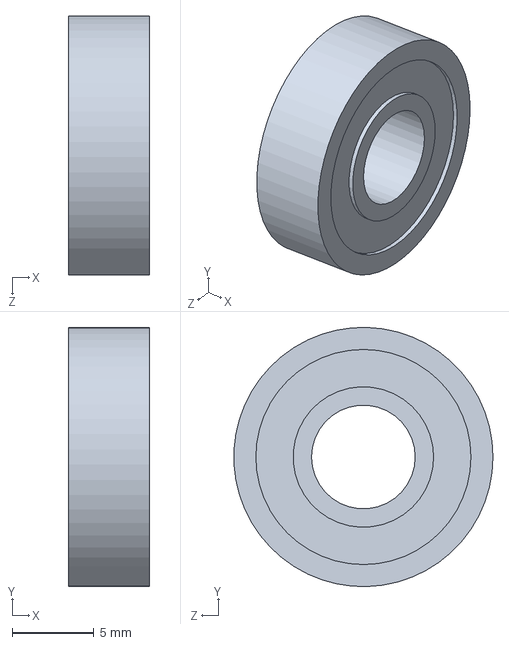
[picture p89: CAD file, 2016-04-22]
Designs/SW2014 Parts Library 1.1 - orig/3 - Bearings/Ball Bearing 0.25 x 0.625 x 0.196.SLDPRT
4.98 x 15.9 x 15.9 mm
