Yndal/Dispenser-project/Designs/SW2014 Parts Library 1.1 - orig/4 - Pulleys/GT2 Timing Pulley 30 Tooth.SLDPRT

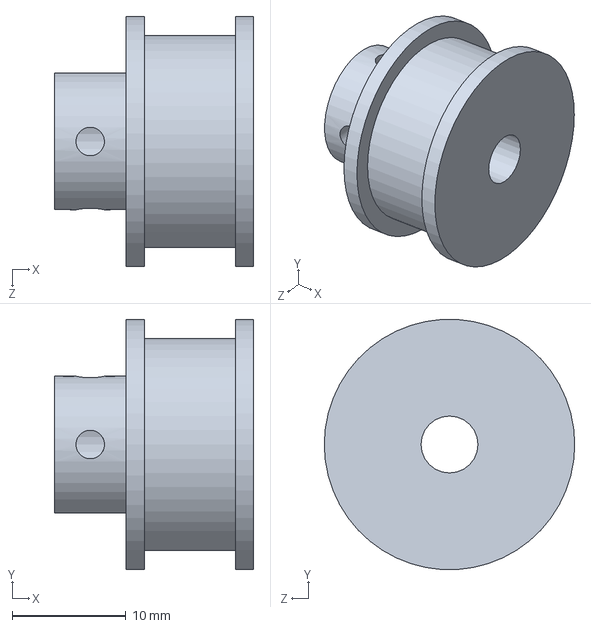
[picture p90: CAD file, 2016-04-22]
Designs/SW2014 Parts Library 1.1 - orig/4 - Pulleys/GT2 Timing Pulley 30 Tooth.SLDPRT
17.5 x 22.0 x 22.0 mm
