Yndal/Dispenser-project/Designs/SW2014 Parts Library 1.1 - orig/5 - Brackets/Cast Corner Bracket.SLDPRT

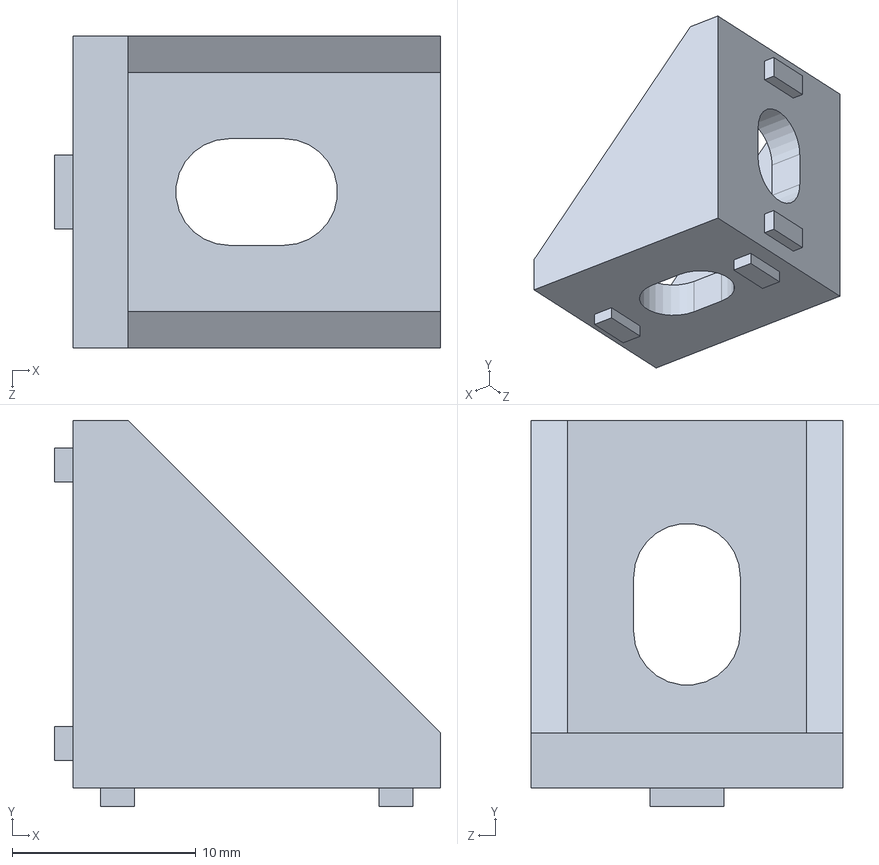
[picture p91: CAD file, 2016-04-22]
Designs/SW2014 Parts Library 1.1 - orig/5 - Brackets/Cast Corner Bracket.SLDPRT
21.0 x 21.0 x 17.0 mm
