Yndal/Dispenser-project/Designs/SW2014 Parts Library 1.1 - orig/6 - Electronics/Nema 17 Stepper Motor.SLDPRT

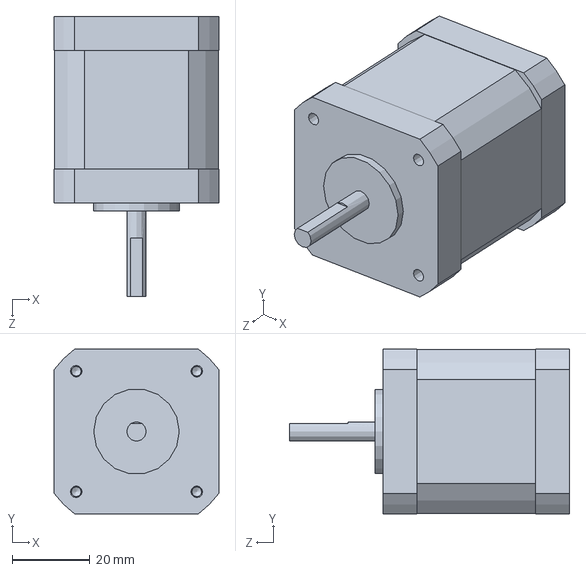
[picture p92: CAD file, 2016-04-22]
Designs/SW2014 Parts Library 1.1 - orig/6 - Electronics/Nema 17 Stepper Motor.SLDPRT
42.4 x 42.4 x 72.0 mm
