Yndal/Dispenser-project/Designs/SW2014 Parts Library 1.1 - orig/7 - Hardware/Lock Collar 5mm.SLDPRT

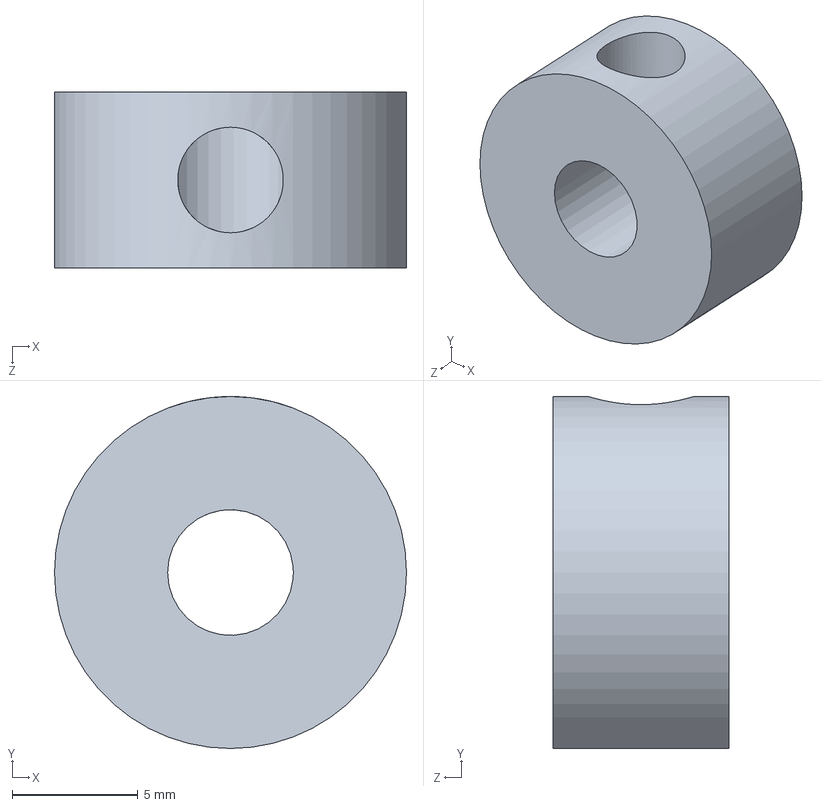
[picture p93: CAD file, 2016-04-22]
Designs/SW2014 Parts Library 1.1 - orig/7 - Hardware/Lock Collar 5mm.SLDPRT
14.0 x 14.0 x 7.00 mm
