Yndal/Dispenser-project/Designs/SW2014 Parts Library 1.1 - orig/8 - Plates/Open Rail Gantry Plate 20mm.SLDPRT

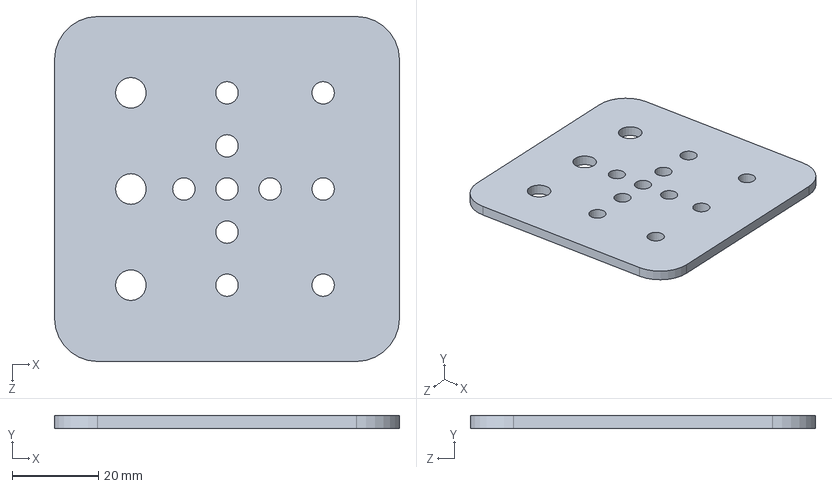
[picture p94: CAD file, 2016-04-22]
Designs/SW2014 Parts Library 1.1 - orig/8 - Plates/Open Rail Gantry Plate 20mm.SLDPRT
80.0 x 3.00 x 80.0 mm
