Yndal/Dispenser-project/Designs/SW2014 Parts Library 1.1 - orig/Assemblies/V Slot Belt Driven Actuator/GT3 Belt 1160mm.SLDPRT

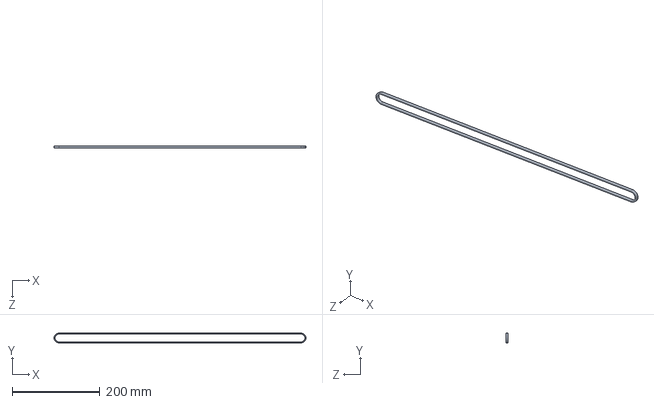
[picture p95: CAD file, 2016-04-22]
Designs/SW2014 Parts Library 1.1 - orig/Assemblies/V Slot Belt Driven Actuator/GT3 Belt 1160mm.SLDPRT
574.1 x 22.3 x 5.00 mm
