Yndal/Dispenser-project/Designs/Tests/Plate_20X40.SLDPRT

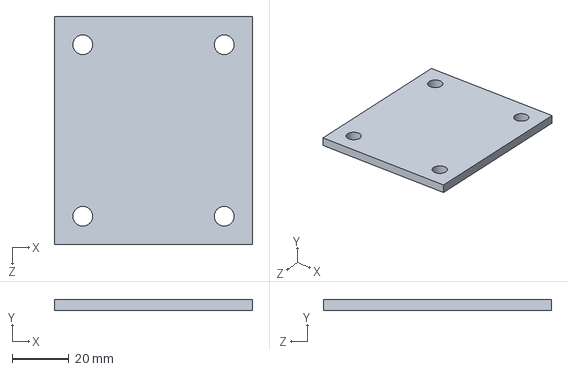
[picture p96: CAD file, 2016-04-22]
Designs/Tests/Plate_20X40.SLDPRT
70.0 x 4.00 x 80.6 mm
