Yndal/Dispenser-project/Designs/User Library-Parallax Ping Sensor/Parallax Ping Transducer.SLDPRT

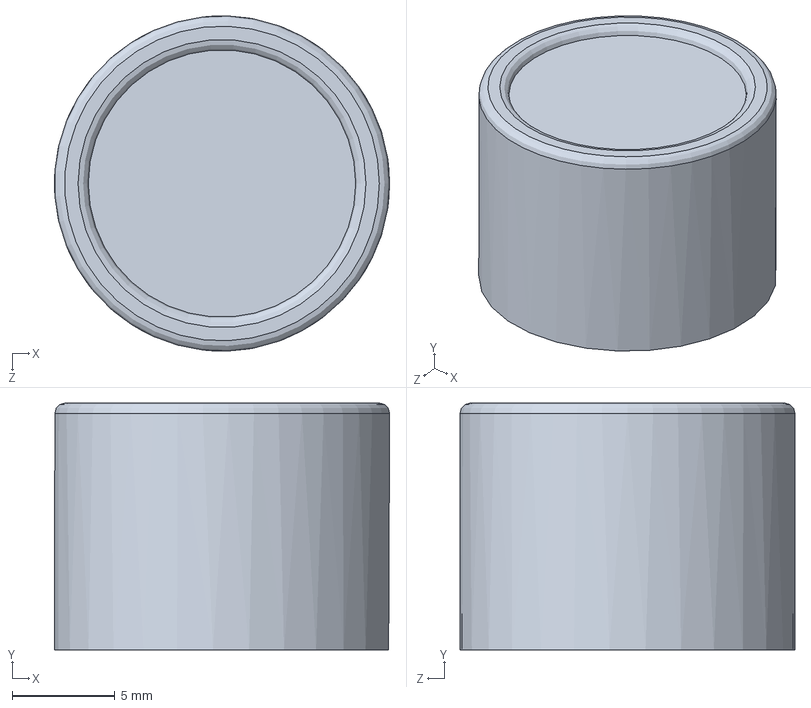
[picture p97: CAD file, 2016-06-13]
Designs/User Library-Parallax Ping Sensor/Parallax Ping Transducer.SLDPRT
16.3 x 12.0 x 16.3 mm
