Yndal/Dispenser-project/Designs/Vertical axis/MotorMount.SLDPRT

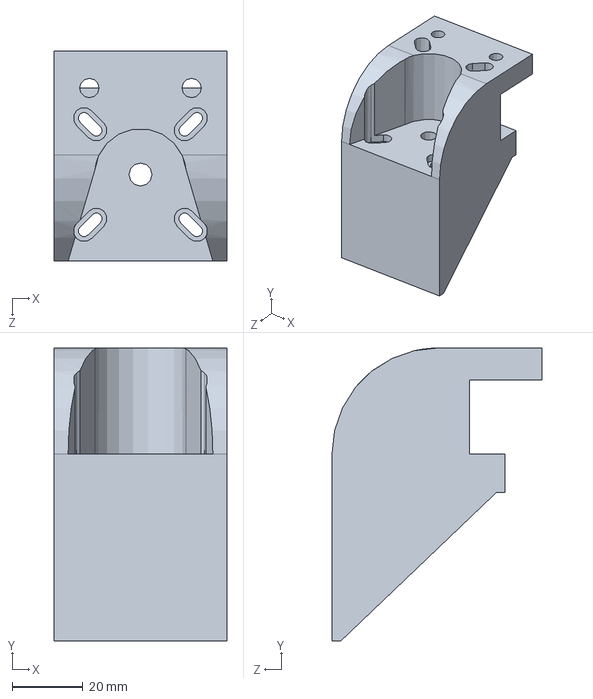
[picture p98: CAD file, 2016-06-13]
Designs/Vertical axis/MotorMount.SLDPRT
49.0 x 83.0 x 59.5 mm
