Yndal/Dispenser-project/Designs/Dishes/GlassDish.SLDPRT

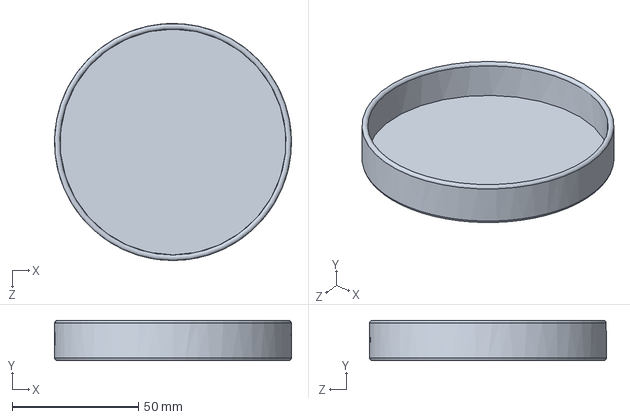
[picture p99: CAD file, 2016-04-22]
Designs/Dishes/GlassDish.SLDPRT
94.0 x 16.0 x 94.0 mm
