Yndal/Dispenser-project/Designs/Gripper/Squeeze/ArmRight.SLDPRT

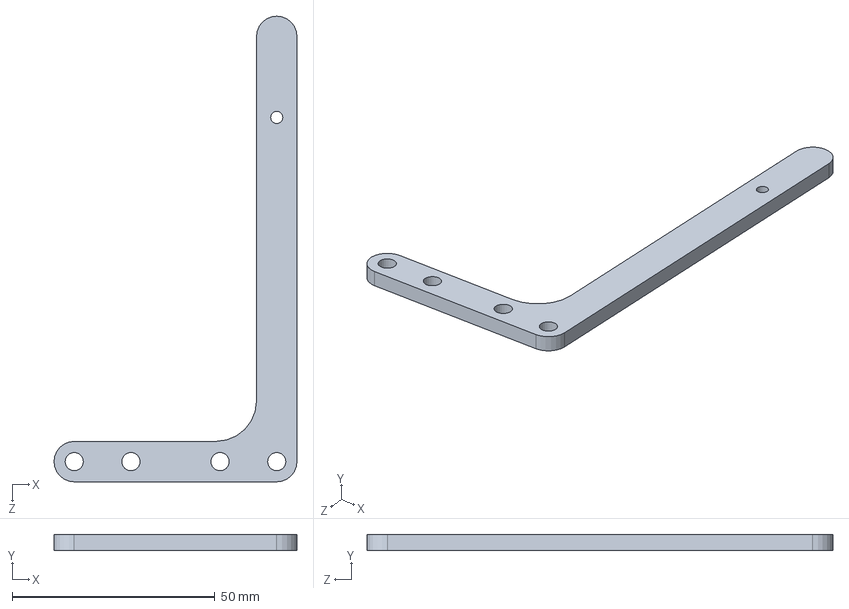
[picture p100: CAD file, 2016-04-22]
Designs/Gripper/Squeeze/ArmRight.SLDPRT
60.0 x 4.00 x 115.0 mm
