Yndal/Dispenser-project/Designs/Igus/NS-01-17-100.sldprt

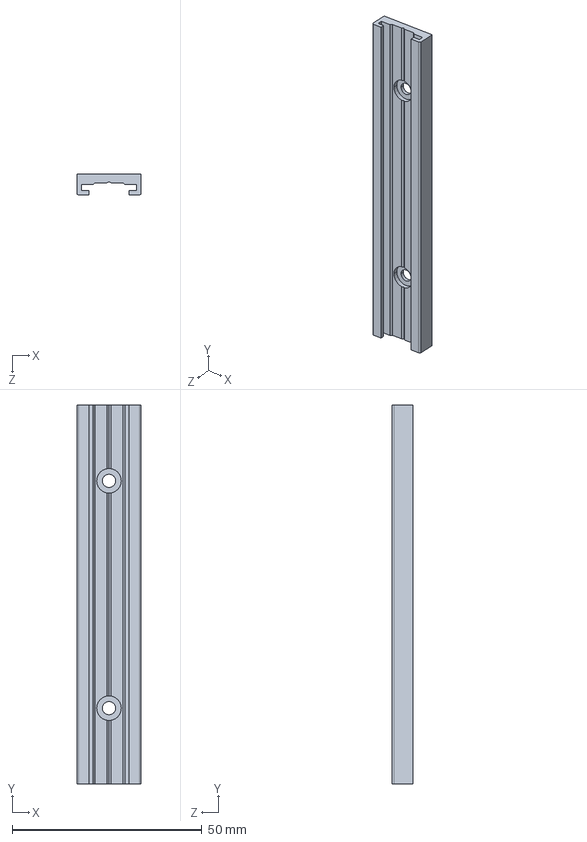
[picture p101: CAD file, 2016-04-22]
Designs/Igus/NS-01-17-100.sldprt
17.0 x 100.0 x 5.50 mm
