Yndal/Dispenser-project/Designs/OpenBuilds_r3/1 - V-Slot/V-Slot 20mm x 40mm x 1000mm.IGS

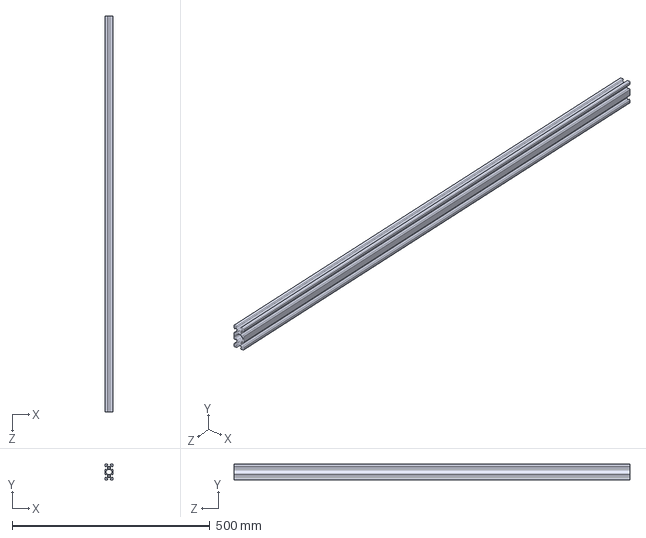
[picture p102: CAD file, 2016-04-22]
Designs/OpenBuilds_r3/1 - V-Slot/V-Slot 20mm x 40mm x 1000mm.IGS
20.0 x 40.0 x 1000.0 mm
