Yndal/Dispenser-project/Designs/OpenBuilds_r3/12 - Spacers/.125 Inch Nylon Spacer.SLDPRT

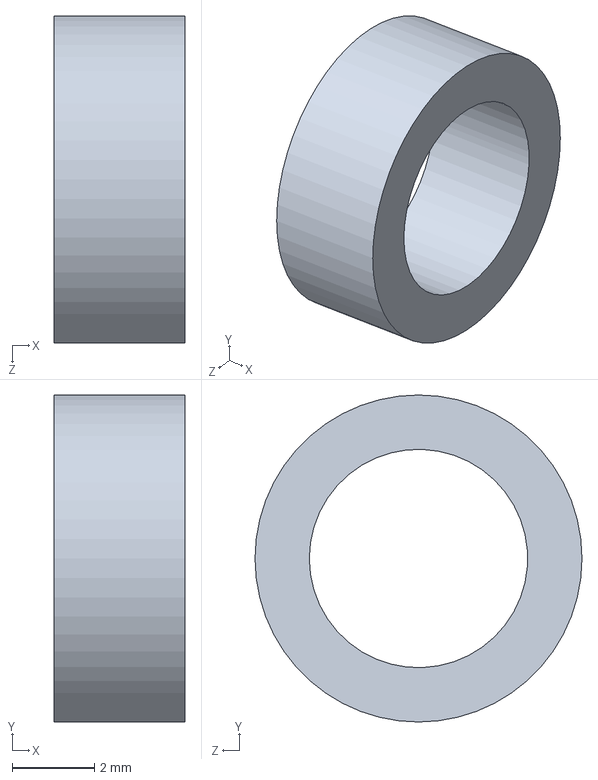
[picture p103: CAD file, 2016-04-22]
Designs/OpenBuilds_r3/12 - Spacers/.125 Inch Nylon Spacer.SLDPRT
3.17 x 7.94 x 7.94 mm
