Yndal/Dispenser-project/Designs/OpenBuilds_r3/2 - OpenRail/Open Rail 500mm.sldprt

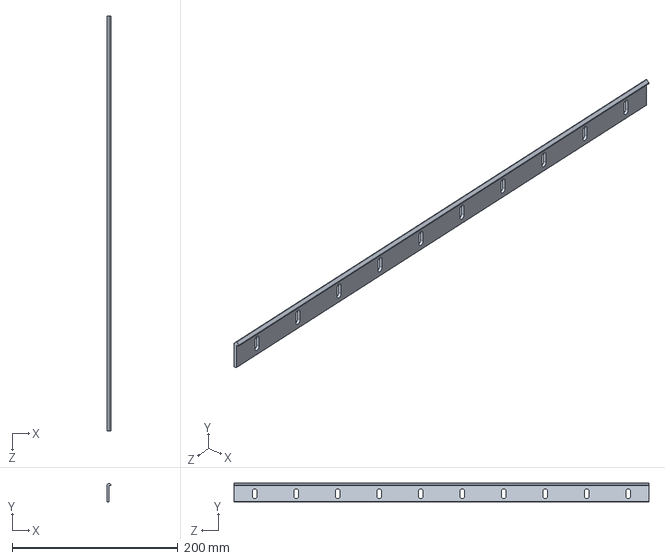
[picture p104: CAD file, 2016-04-22]
Designs/OpenBuilds_r3/2 - OpenRail/Open Rail 500mm.sldprt
4.75 x 22.5 x 500.0 mm
