Yndal/Dispenser-project/Designs/OpenBuilds_r3/3 - Wheels/Delrin Micro V-Wheel.SLDPRT

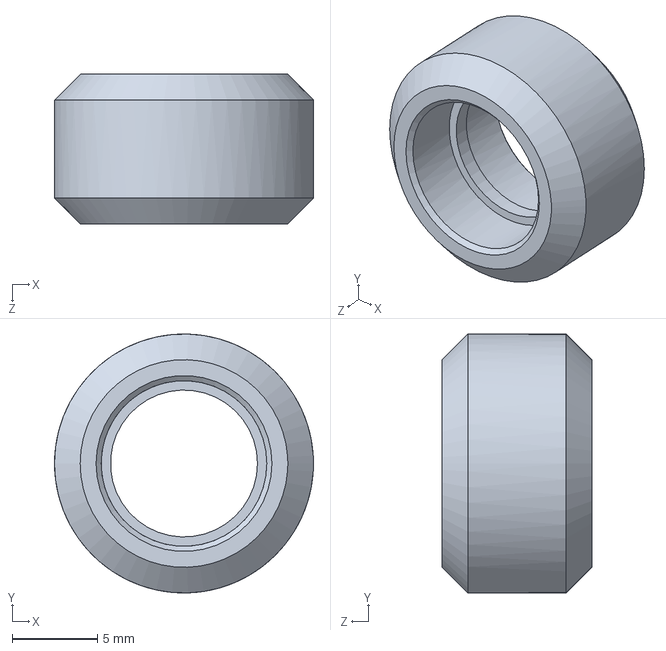
[picture p105: CAD file, 2016-04-22]
Designs/OpenBuilds_r3/3 - Wheels/Delrin Micro V-Wheel.SLDPRT
15.2 x 15.2 x 8.80 mm
