Yndal/Dispenser-project/Designs/OpenBuilds_r3/4 - Bearings/Precision Ball Bearing.SLDPRT

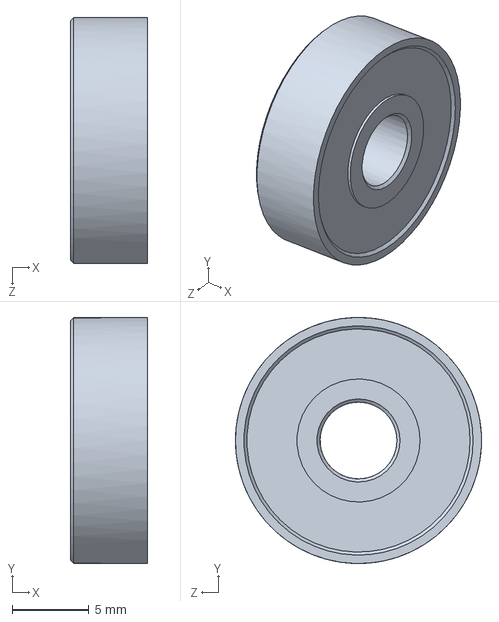
[picture p106: CAD file, 2016-04-22]
Designs/OpenBuilds_r3/4 - Bearings/Precision Ball Bearing.SLDPRT
5.00 x 16.0 x 16.0 mm
