Yndal/Dispenser-project/Designs/OpenBuilds_r3/5 - Belts and Pulleys/GT2 2mm Aluminum Timing Pulley - 30 Tooth.SLDPRT

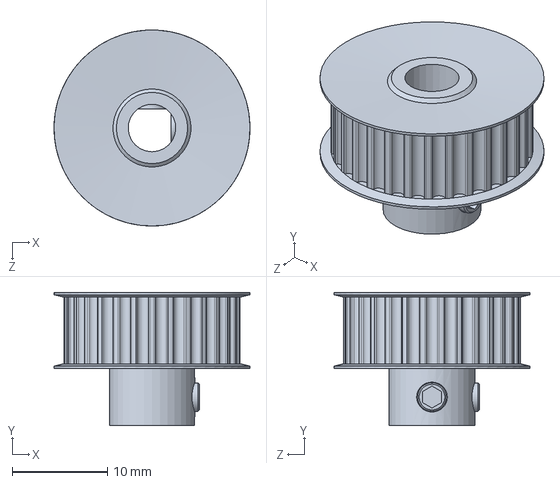
[picture p107: CAD file, 2016-04-22]
Designs/OpenBuilds_r3/5 - Belts and Pulleys/GT2 2mm Aluminum Timing Pulley - 30 Tooth.SLDPRT
20.6 x 14.0 x 20.6 mm
