Yndal/Dispenser-project/Designs/OpenBuilds_r3/6 - Brackets/Universal L Bracket - Double.SLDPRT

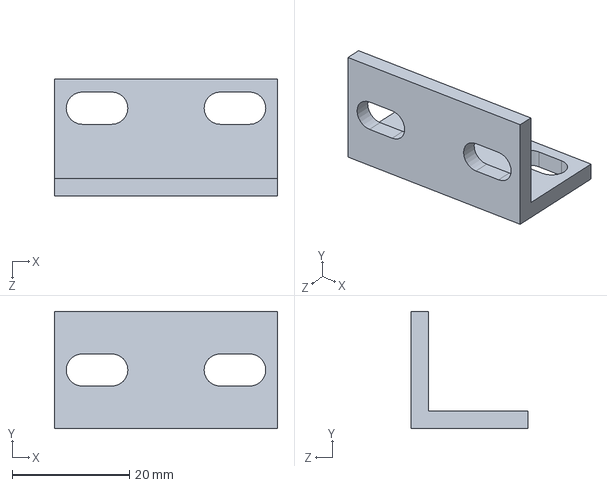
[picture p108: CAD file, 2016-04-22]
Designs/OpenBuilds_r3/6 - Brackets/Universal L Bracket - Double.SLDPRT
38.0 x 20.0 x 20.0 mm
