Yndal/Dispenser-project/Designs/OpenBuilds_r3/7 - Electronics/NEMA 17 Stepper Motor Bottom.SLDPRT

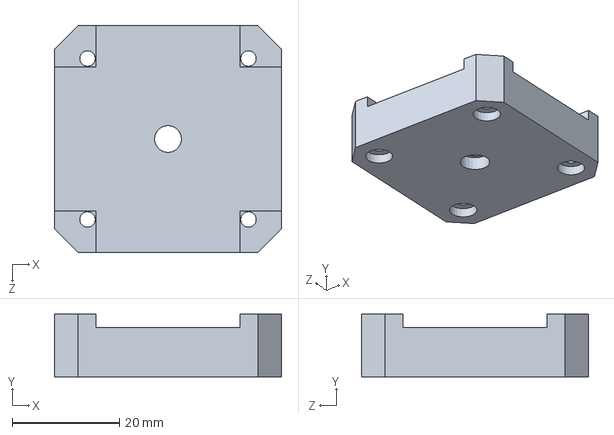
[picture p109: CAD file, 2016-06-13]
Designs/OpenBuilds_r3/7 - Electronics/NEMA 17 Stepper Motor Bottom.SLDPRT
42.3 x 11.7 x 42.3 mm
