Yndal/Dispenser-project/Designs/OpenBuilds_r3/9 - Plates/V-Slot Universal Build Plate.SLDPRT

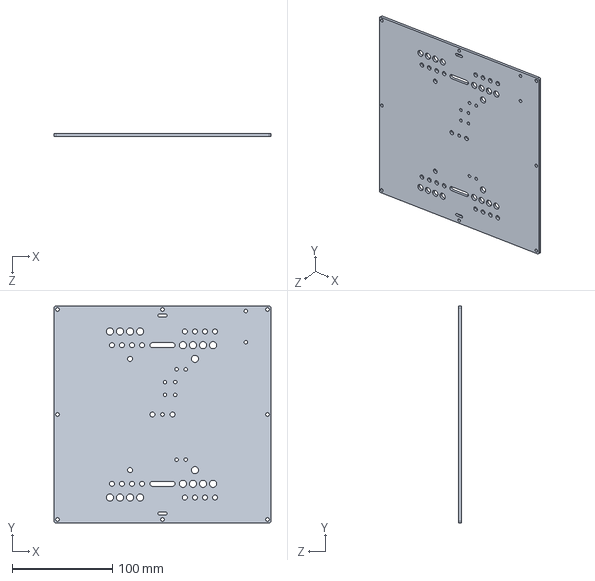
[picture p110: CAD file, 2016-04-22]
Designs/OpenBuilds_r3/9 - Plates/V-Slot Universal Build Plate.SLDPRT
216.0 x 216.0 x 3.00 mm
