Yndal/Dispenser-project/Designs/Stack/Top_wells.SLDPRT

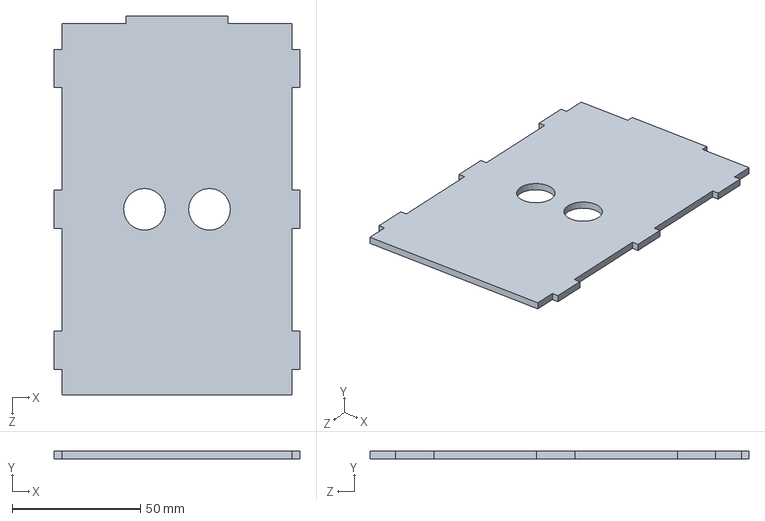
[picture p111: CAD file, 2016-06-13]
Designs/Stack/Top_wells.SLDPRT
96.0 x 3.00 x 148.0 mm
