Yndal/Dispenser-project/Designs/SW2014 Parts Library 1.1 - orig/10 - Shims and Spacers/Mini Eccentric Spacer 6mm.SLDPRT

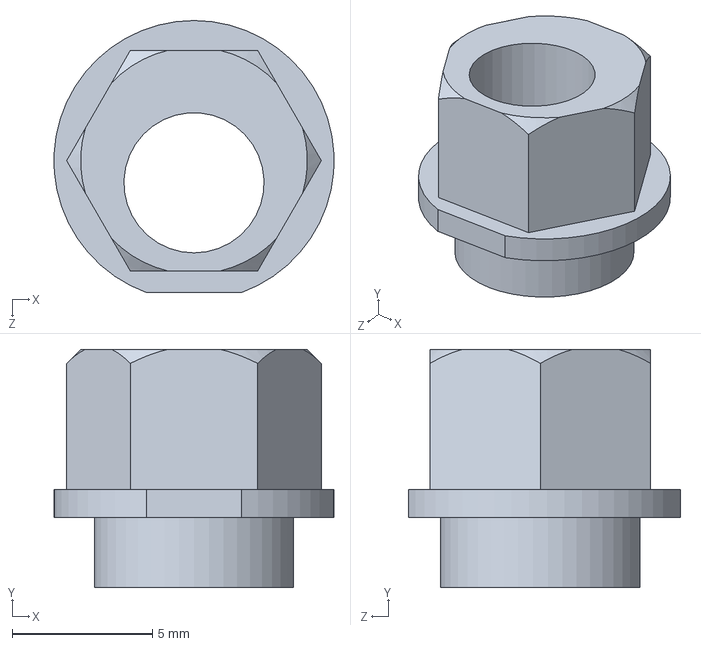
[picture p113: CAD file, 2016-04-22]
Designs/SW2014 Parts Library 1.1 - orig/10 - Shims and Spacers/Mini Eccentric Spacer 6mm.SLDPRT
9.99 x 8.50 x 9.70 mm
