Yndal/Dispenser-project/Designs/SW2014 Parts Library 1.1 - orig/4 - Pulleys/GT3 Timing Pulley 20 Tooth.SLDPRT

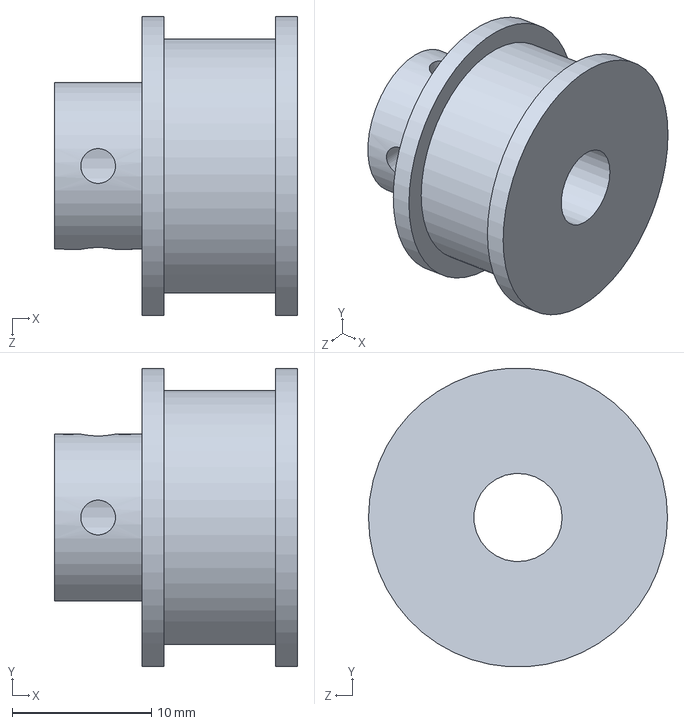
[picture p114: CAD file, 2016-04-22]
Designs/SW2014 Parts Library 1.1 - orig/4 - Pulleys/GT3 Timing Pulley 20 Tooth.SLDPRT
17.5 x 21.5 x 21.5 mm
