Yndal/Dispenser-project/Designs/SW2014 Parts Library 1.1 - orig/6 - Electronics/Nema 23 Stepper Motor.SLDPRT

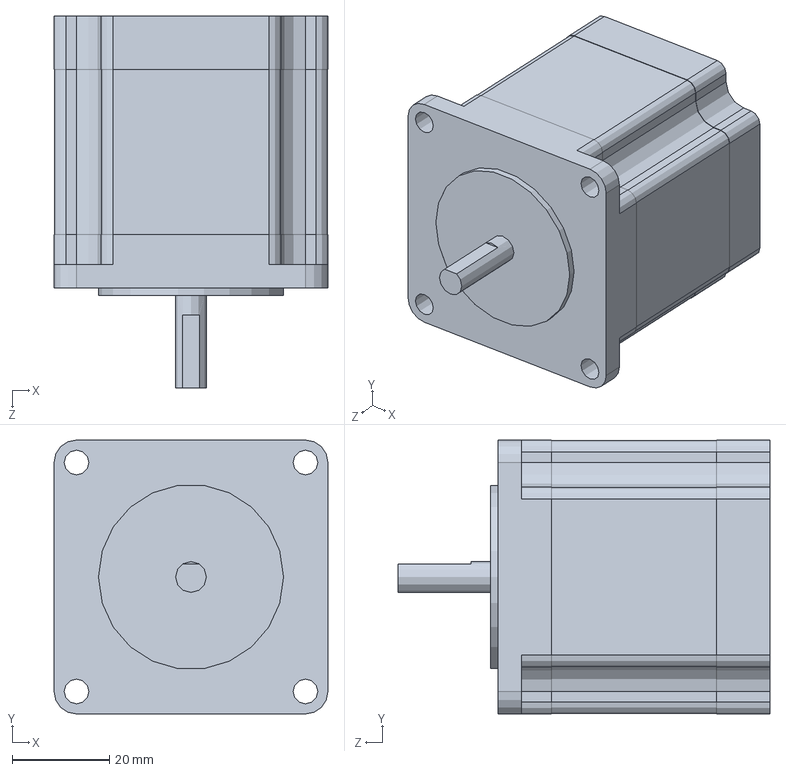
[picture p115: CAD file, 2016-04-22]
Designs/SW2014 Parts Library 1.1 - orig/6 - Electronics/Nema 23 Stepper Motor.SLDPRT
56.4 x 56.4 x 76.6 mm
