Yndal/Dispenser-project/Designs/SW2014 Parts Library 1.1 - orig/7 - Hardware/Flexible Coupling 5mm x 8mm.SLDPRT

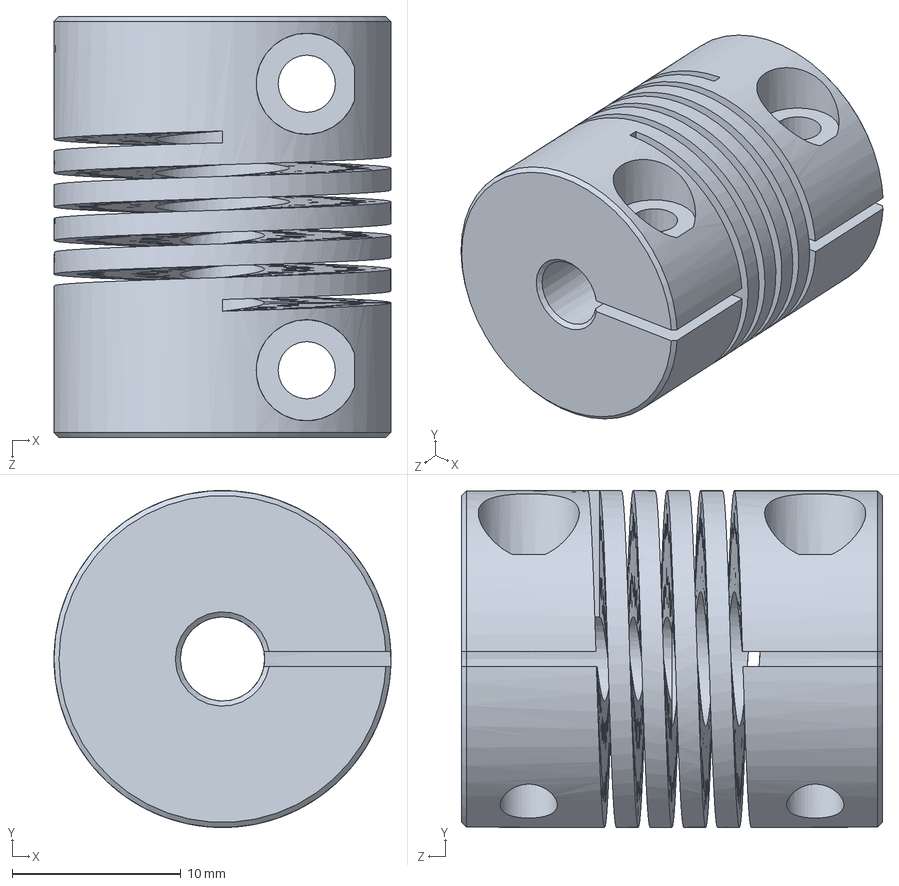
[picture p116: CAD file, 2016-04-22]
Designs/SW2014 Parts Library 1.1 - orig/7 - Hardware/Flexible Coupling 5mm x 8mm.SLDPRT
20.0 x 20.0 x 25.0 mm
