Yndal/Dispenser-project/Designs/SW2014 Parts Library 1.1 - orig/8 - Plates/V-Slot Gantry Plate 20mm.SLDPRT

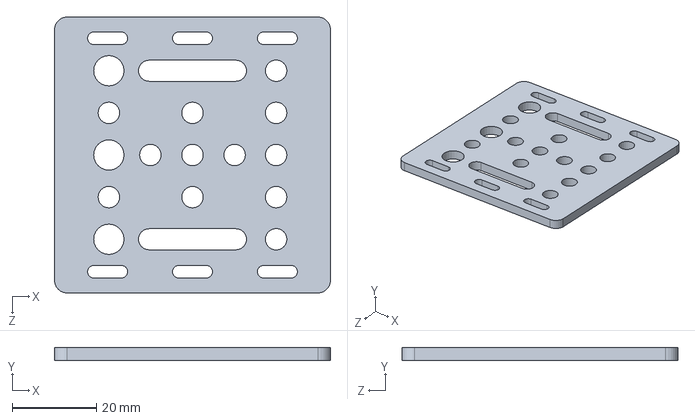
[picture p117: CAD file, 2016-04-22]
Designs/SW2014 Parts Library 1.1 - orig/8 - Plates/V-Slot Gantry Plate 20mm.SLDPRT
65.5 x 3.00 x 65.5 mm
