Yndal/Dispenser-project/Designs/SW2014 Parts Library 1.1 - orig/Assemblies/Mini V Linear Actuator/GT2 Belt 1140mm.SLDPRT

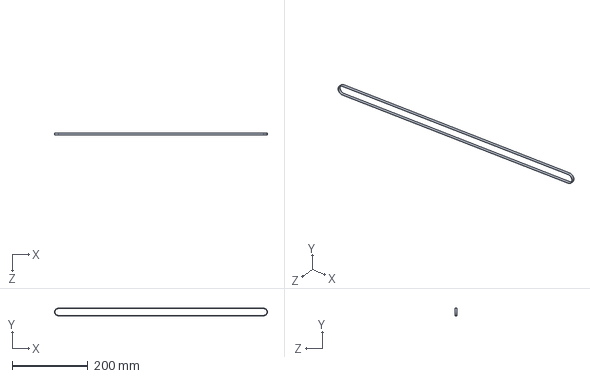
[picture p118: CAD file, 2016-04-22]
Designs/SW2014 Parts Library 1.1 - orig/Assemblies/Mini V Linear Actuator/GT2 Belt 1140mm.SLDPRT
561.3 x 20.3 x 5.00 mm
