Yndal/Dispenser-project/Designs/SW2014 Parts Library 1.1 - orig/Assemblies/V Slot Belt and Pinion Actuator/V-Slot 20x40x80 Linear Rail.SLDPRT

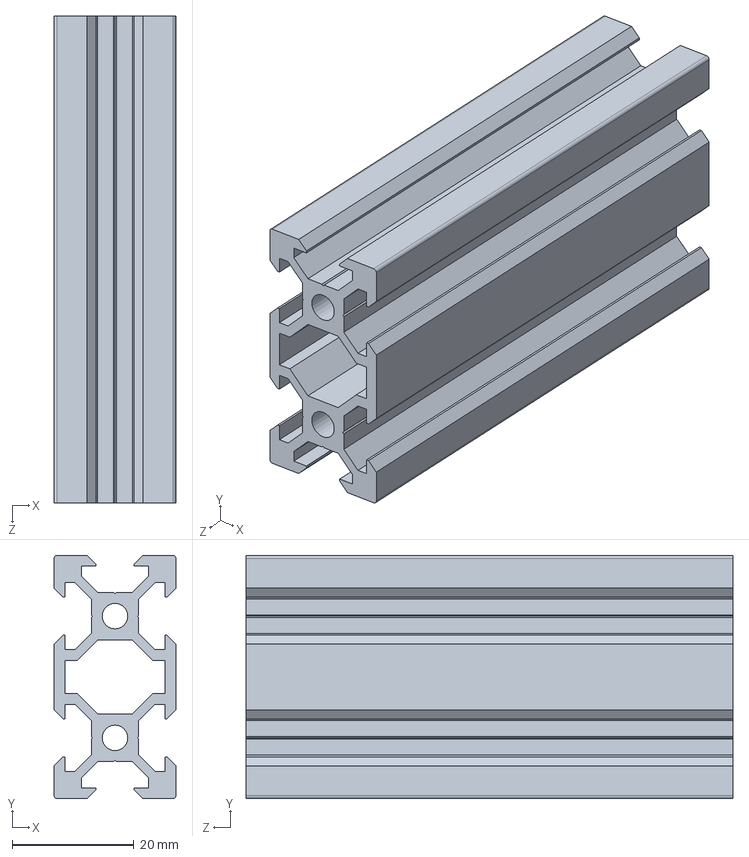
[picture p119: CAD file, 2016-04-22]
Designs/SW2014 Parts Library 1.1 - orig/Assemblies/V Slot Belt and Pinion Actuator/V-Slot 20x40x80 Linear Rail.SLDPRT
20.0 x 40.0 x 80.0 mm
