Yndal/Dispenser-project/Designs/SW2014 Parts Library 1.1 - orig/Assemblies/V Slot Belt Driven Actuator/GT2 Belt 1120mm.SLDPRT

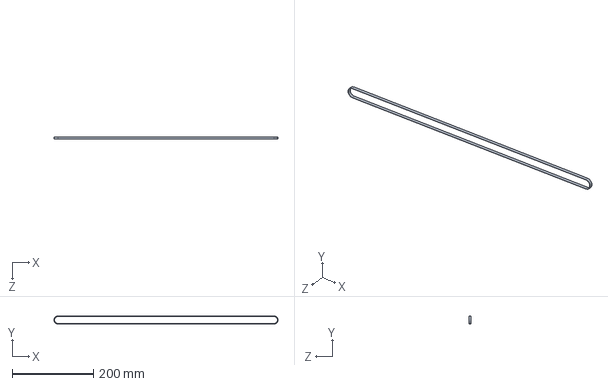
[picture p120: CAD file, 2016-04-22]
Designs/SW2014 Parts Library 1.1 - orig/Assemblies/V Slot Belt Driven Actuator/GT2 Belt 1120mm.SLDPRT
552.3 x 20.3 x 5.00 mm
