Yndal/Dispenser-project/Designs/User Library-Parallax Ping Sensor/Parallax Ping PCB.SLDPRT

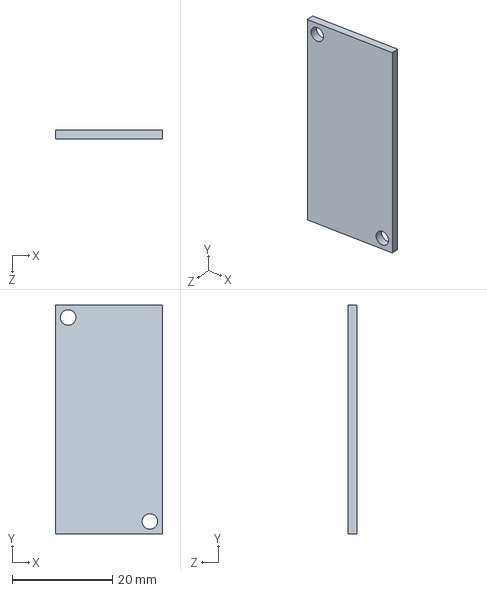
[picture p121: CAD file, 2016-06-13]
Designs/User Library-Parallax Ping Sensor/Parallax Ping PCB.SLDPRT
21.3 x 45.7 x 1.75 mm
