Yndal/Dispenser-project/Designs/Frame/V-Slot 20x20x500 Linear Rail - vert.SLDPRT

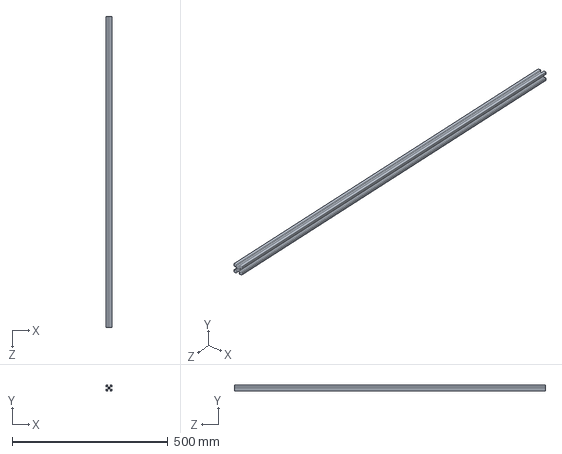
[picture p122: CAD file, 2016-04-22]
Designs/Frame/V-Slot 20x20x500 Linear Rail - vert.SLDPRT
20.0 x 20.0 x 1000.0 mm
