Yndal/Dispenser-project/Designs/Gripper/Squeeze/Fingers.SLDPRT

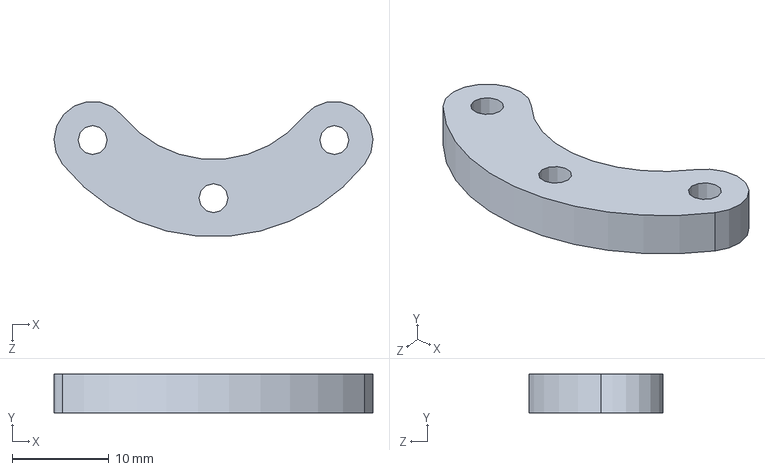
[picture p123: CAD file, 2016-04-22]
Designs/Gripper/Squeeze/Fingers.SLDPRT
33.0 x 4.00 x 13.9 mm
