Yndal/Dispenser-project/Designs/Horizontal axis/Horizontal_plate_front.SLDPRT

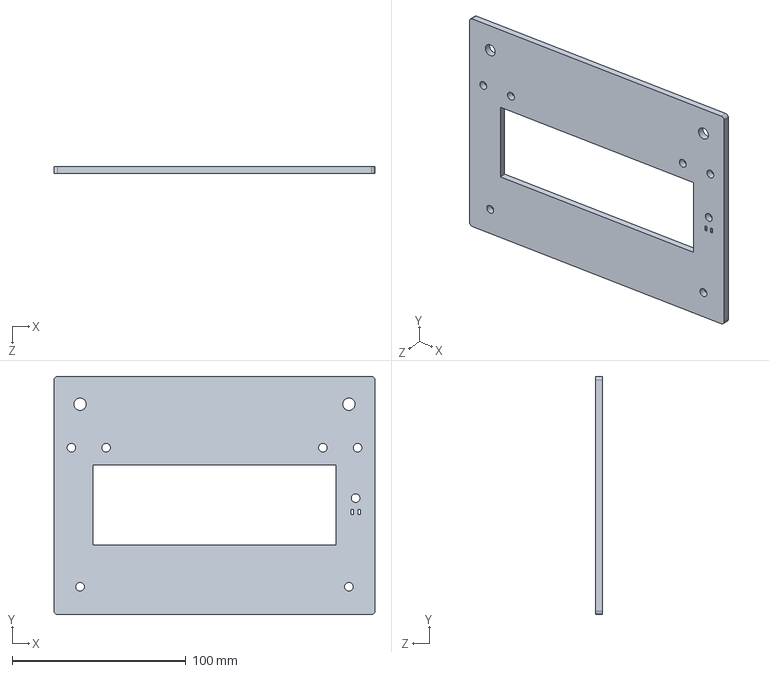
[picture p124: CAD file, 2016-06-13]
Designs/Horizontal axis/Horizontal_plate_front.SLDPRT
184.6 x 137.0 x 4.00 mm
