Yndal/Dispenser-project/Designs/OpenBuilds_r3/12 - Spacers/.25 Inch Aluminum Spacer.SLDPRT

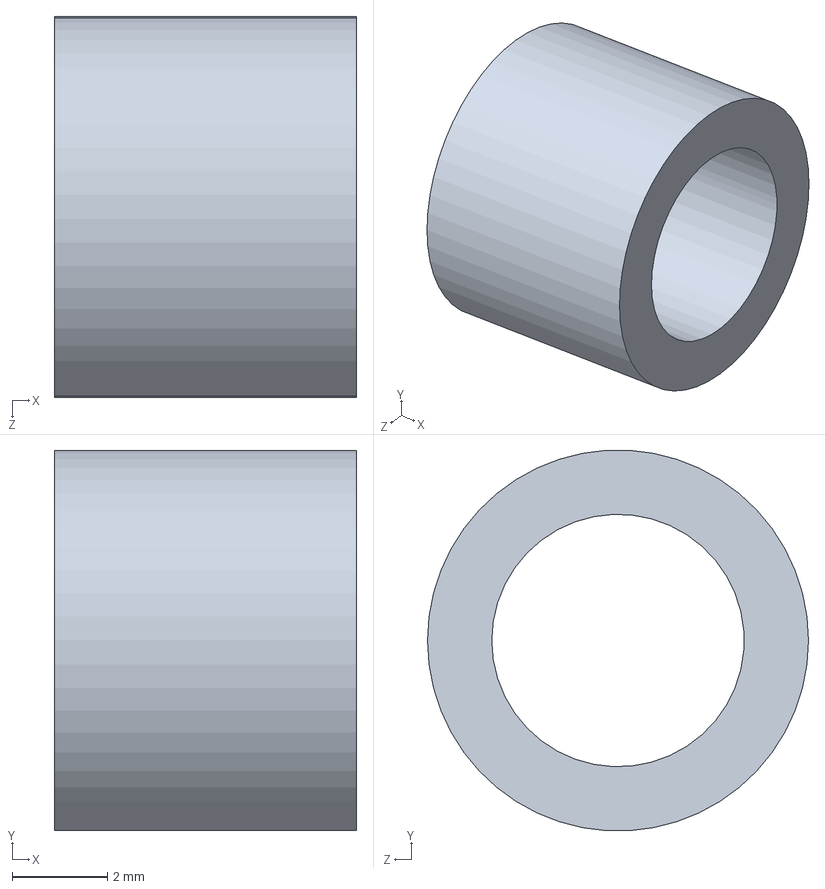
[picture p126: CAD file, 2016-04-22]
Designs/OpenBuilds_r3/12 - Spacers/.25 Inch Aluminum Spacer.SLDPRT
6.35 x 7.98 x 8.00 mm
