Yndal/Dispenser-project/Designs/OpenBuilds_r3/2 - OpenRail/Open Rail 1000mm.STEP

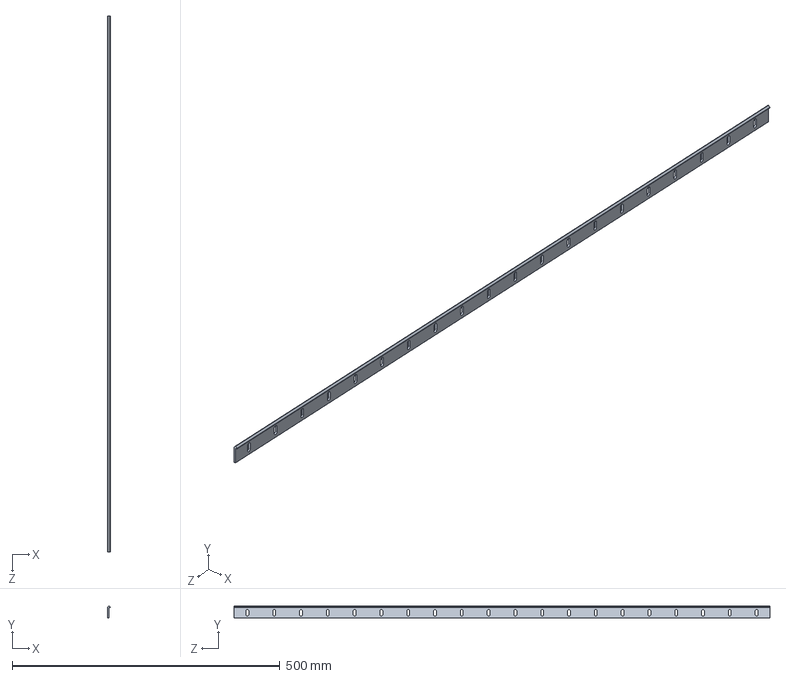
[picture p127: CAD file, 2016-04-22]
Designs/OpenBuilds_r3/2 - OpenRail/Open Rail 1000mm.STEP
4.75 x 22.5 x 1000.0 mm
