Yndal/Dispenser-project/Designs/OpenBuilds_r3/4 - Bearings/R4-ZZ Ball Bearing.SLDPRT

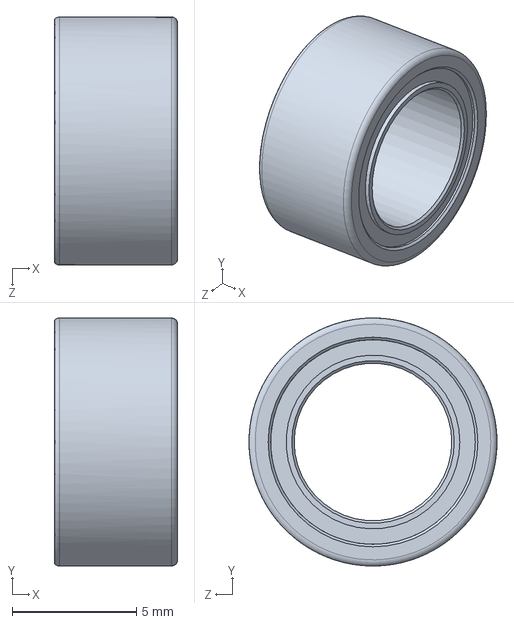
[picture p128: CAD file, 2016-04-22]
Designs/OpenBuilds_r3/4 - Bearings/R4-ZZ Ball Bearing.SLDPRT
4.98 x 10.00 x 10.0 mm
