Yndal/Dispenser-project/Designs/OpenBuilds_r3/5 - Belts and Pulleys/Smoth Idler Pulley.SLDPRT

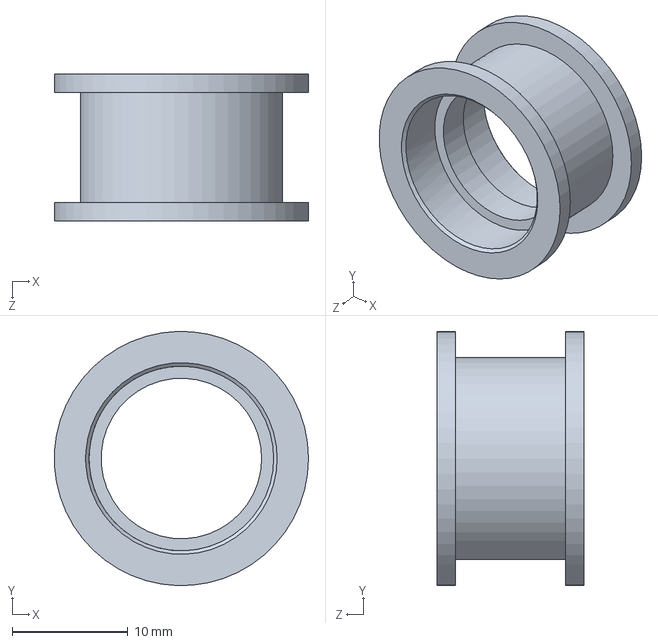
[picture p129: CAD file, 2016-04-22]
Designs/OpenBuilds_r3/5 - Belts and Pulleys/Smoth Idler Pulley.SLDPRT
22.0 x 22.0 x 12.7 mm
