Yndal/Dispenser-project/Designs/OpenBuilds_r3/6 - Brackets/Inside Hidden Corner Bracket.SLDPRT

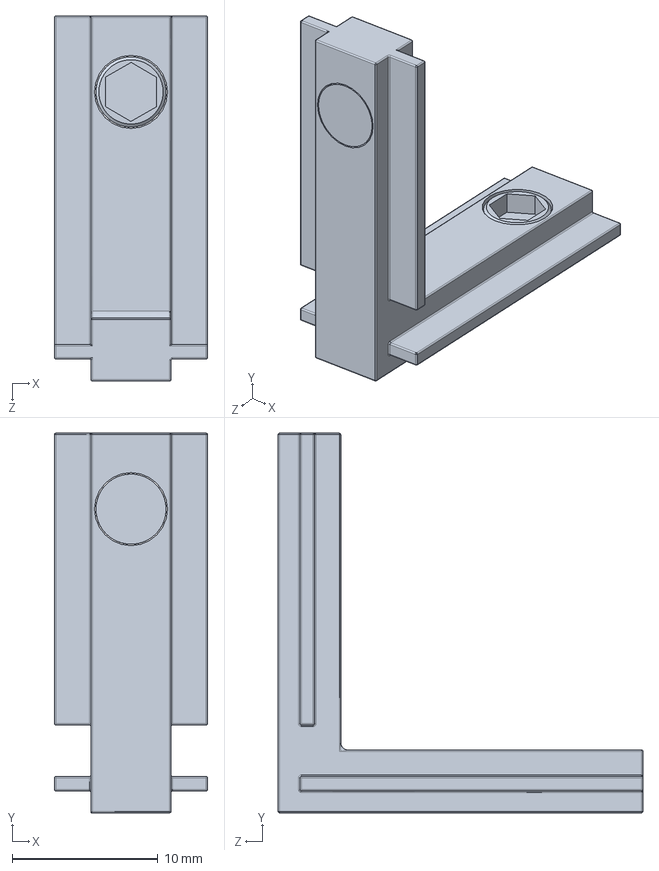
[picture p130: CAD file, 2016-04-22]
Designs/OpenBuilds_r3/6 - Brackets/Inside Hidden Corner Bracket.SLDPRT
10.5 x 26.0 x 25.0 mm
