Yndal/Dispenser-project/Designs/OpenBuilds_r3/7 - Electronics/NEMA 17 Stepper Motor Middle.SLDPRT

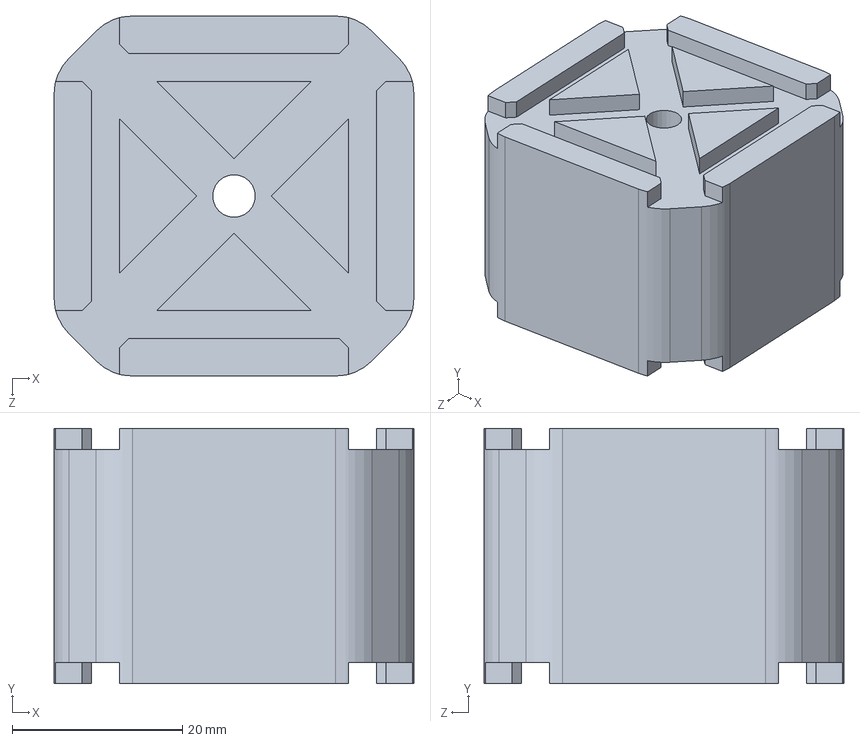
[picture p131: CAD file, 2016-06-13]
Designs/OpenBuilds_r3/7 - Electronics/NEMA 17 Stepper Motor Middle.SLDPRT
42.3 x 30.0 x 42.3 mm
