Yndal/Dispenser-project/Designs/OpenBuilds_r3/9 - Plates/V-Slot Universal Plate.SLDPRT

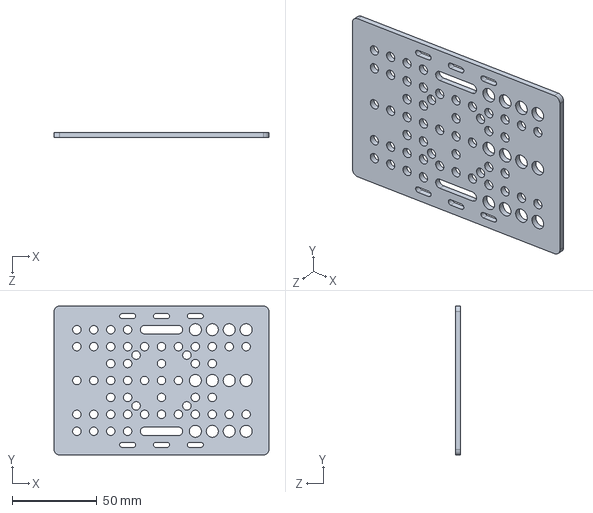
[picture p132: CAD file, 2016-04-22]
Designs/OpenBuilds_r3/9 - Plates/V-Slot Universal Plate.SLDPRT
127.0 x 88.0 x 3.00 mm
