Yndal/Dispenser-project/Designs/SW2014 Parts Library 1.1 - orig/3 - Bearings/Ball Bearing 5 x 10 x 4.2.SLDPRT

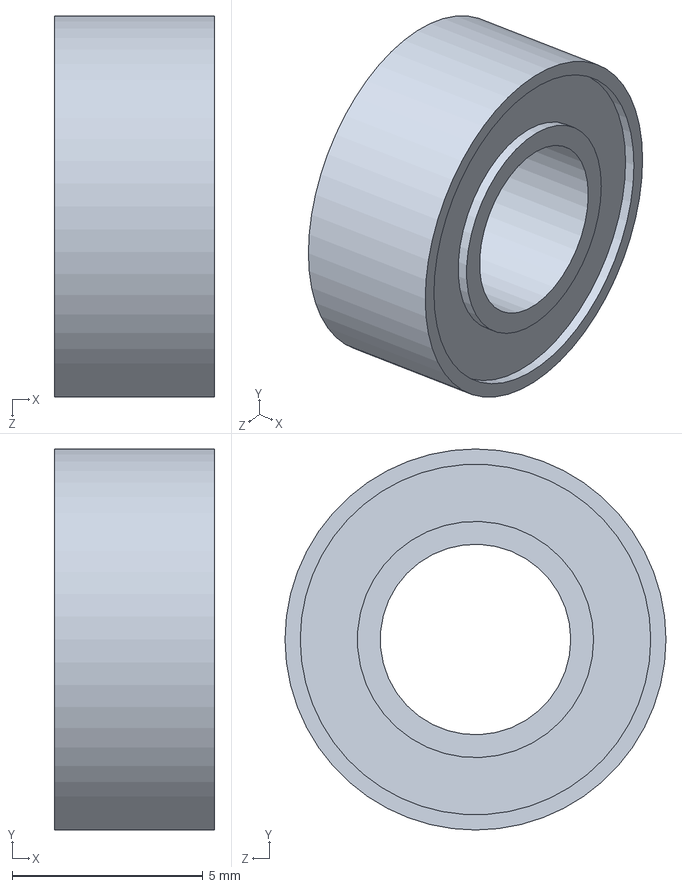
[picture p133: CAD file, 2016-04-22]
Designs/SW2014 Parts Library 1.1 - orig/3 - Bearings/Ball Bearing 5 x 10 x 4.2.SLDPRT
4.20 x 10.0 x 10.0 mm
