Yndal/Dispenser-project/Designs/SW2014 Parts Library 1.1 - orig/4 - Pulleys/GT2 Timing Pulley 14 Tooth.SLDPRT

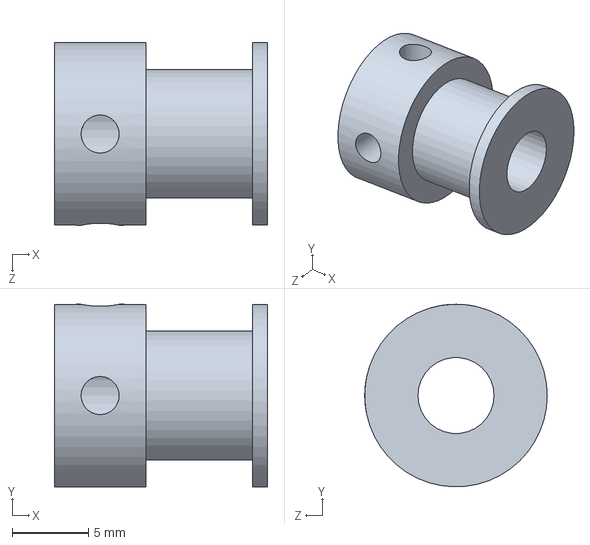
[picture p134: CAD file, 2016-04-22]
Designs/SW2014 Parts Library 1.1 - orig/4 - Pulleys/GT2 Timing Pulley 14 Tooth.SLDPRT
14.0 x 12.0 x 12.0 mm
