Yndal/Dispenser-project/Designs/SW2014 Parts Library 1.1 - orig/5 - Brackets/Router Spindle Mount.SLDPRT

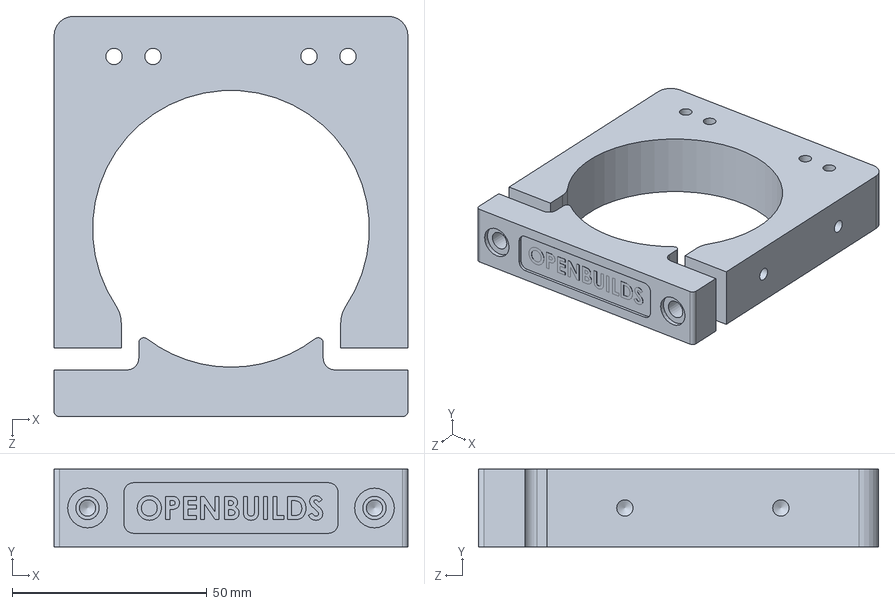
[picture p135: CAD file, 2016-04-22]
Designs/SW2014 Parts Library 1.1 - orig/5 - Brackets/Router Spindle Mount.SLDPRT
90.8 x 20.0 x 102.7 mm
