Yndal/Dispenser-project/Designs/SW2014 Parts Library 1.1 - orig/6 - Electronics/Micro Limit Switch.SLDPRT

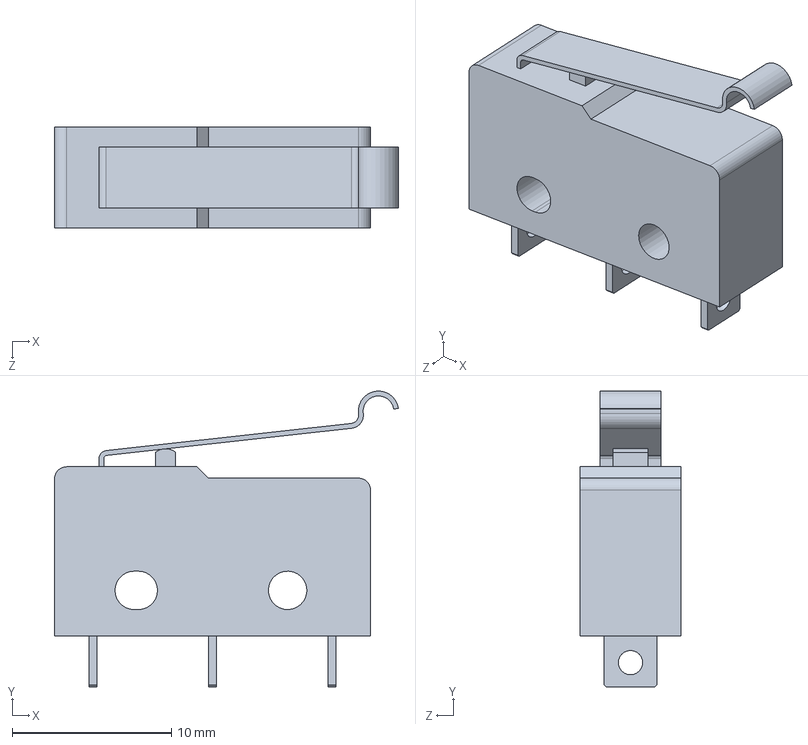
[picture p136: CAD file, 2016-04-22]
Designs/SW2014 Parts Library 1.1 - orig/6 - Electronics/Micro Limit Switch.SLDPRT
21.6 x 18.6 x 6.35 mm
