Yndal/Dispenser-project/Designs/User Library-Parallax Ping Sensor/Cap1 SMT.SLDPRT

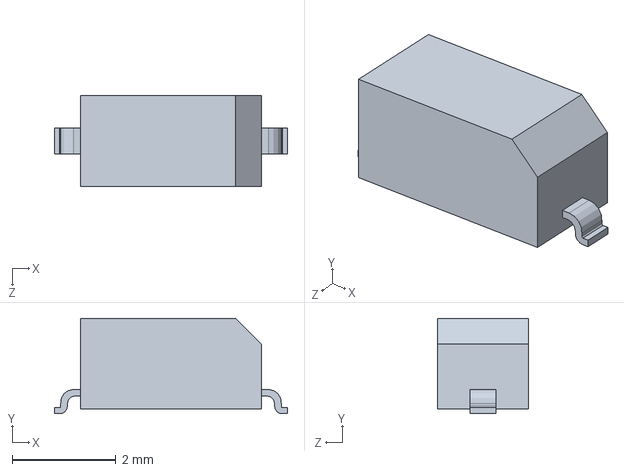
[picture p137: CAD file, 2016-06-13]
Designs/User Library-Parallax Ping Sensor/Cap1 SMT.SLDPRT
4.50 x 1.84 x 1.75 mm
