Yndal/Dispenser-project/Designs/Vertical axis/VertAxisAcrylic.SLDPRT

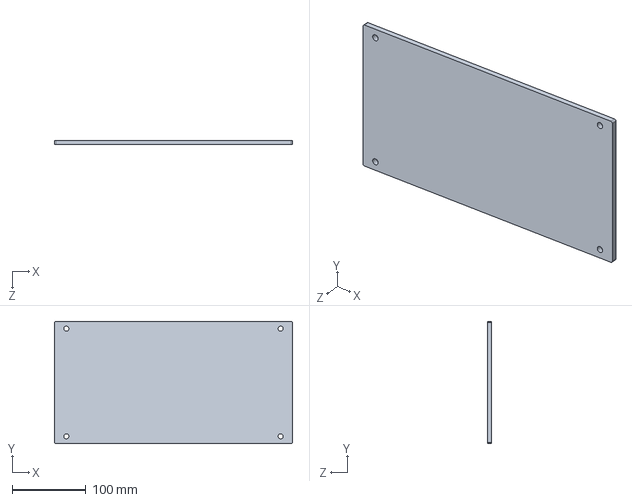
[picture p138: CAD file, 2016-06-13]
Designs/Vertical axis/VertAxisAcrylic.SLDPRT
321.8 x 165.6 x 6.00 mm
