Yndal/Dispenser-project/Designs/Frame/V-Slot 20x20x500 Linear Rail - hori 2.SLDPRT

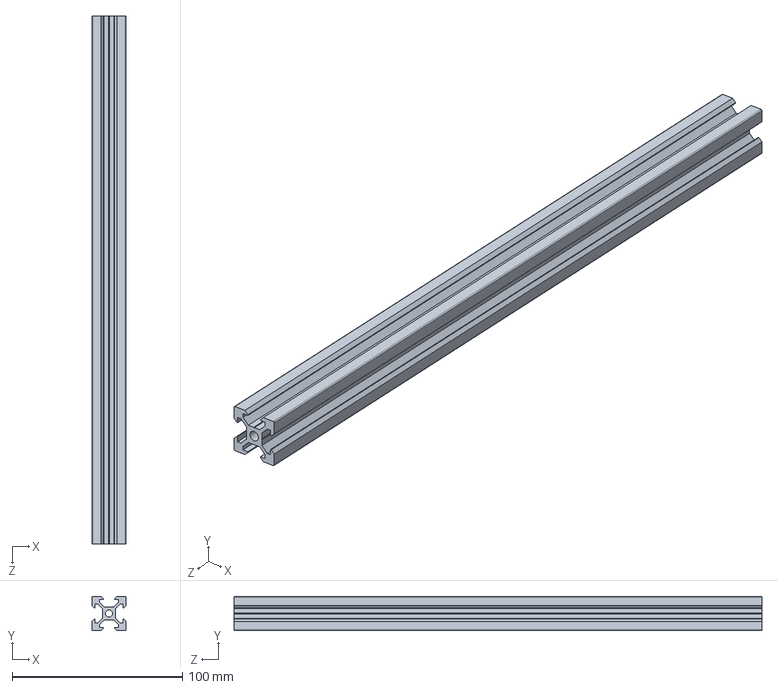
[picture p139: CAD file, 2016-04-22]
Designs/Frame/V-Slot 20x20x500 Linear Rail - hori 2.SLDPRT
20.0 x 20.0 x 310.4 mm
