Yndal/Dispenser-project/Designs/Gripper/FrontPlate.SLDPRT

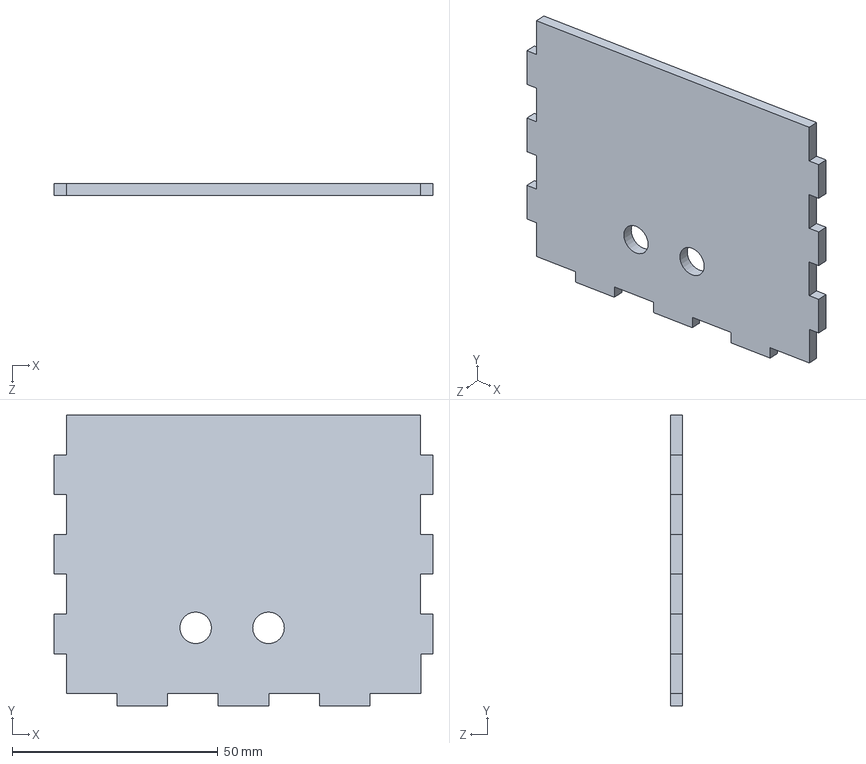
[picture p140: CAD file, 2016-04-22]
Designs/Gripper/FrontPlate.SLDPRT
92.2 x 70.7 x 3.00 mm
