Yndal/Dispenser-project/Designs/Gripper/Squeeze/ArmLeft.SLDPRT

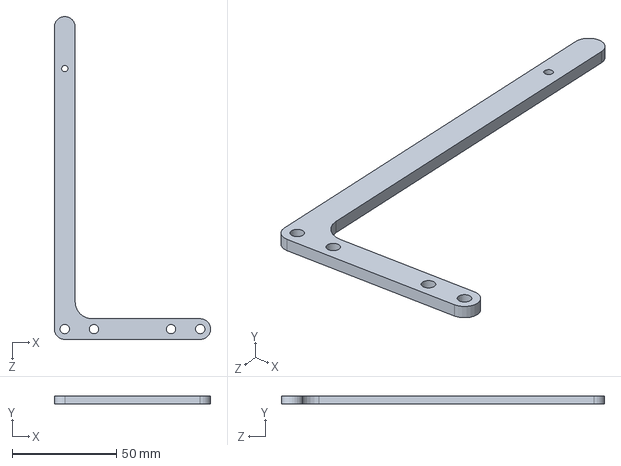
[picture p141: CAD file, 2016-04-22]
Designs/Gripper/Squeeze/ArmLeft.SLDPRT
75.0 x 4.00 x 155.0 mm
