Yndal/Dispenser-project/Designs/OpenBuilds_r3/1 - V-Slot/V-Slot 20mm x 40mm x 465mm.SLDPRT

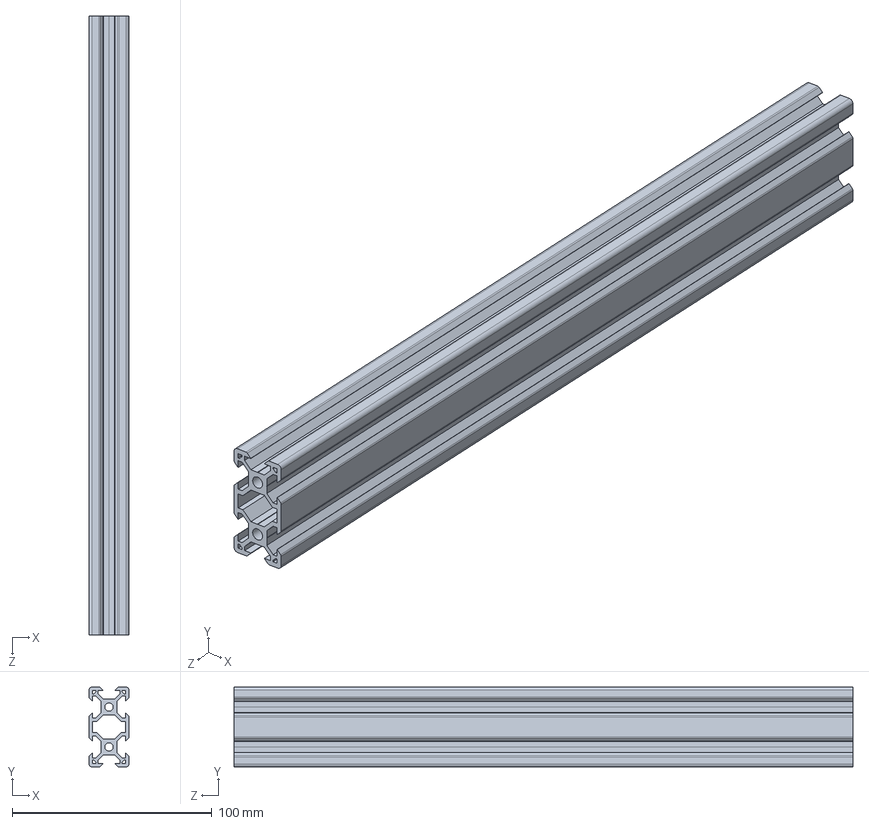
[picture p142: CAD file, 2016-04-22]
Designs/OpenBuilds_r3/1 - V-Slot/V-Slot 20mm x 40mm x 465mm.SLDPRT
20.0 x 40.0 x 310.0 mm
