Yndal/Dispenser-project/Designs/OpenBuilds_r3/12 - Spacers/.25 Inch Nylon Spacer.SLDPRT

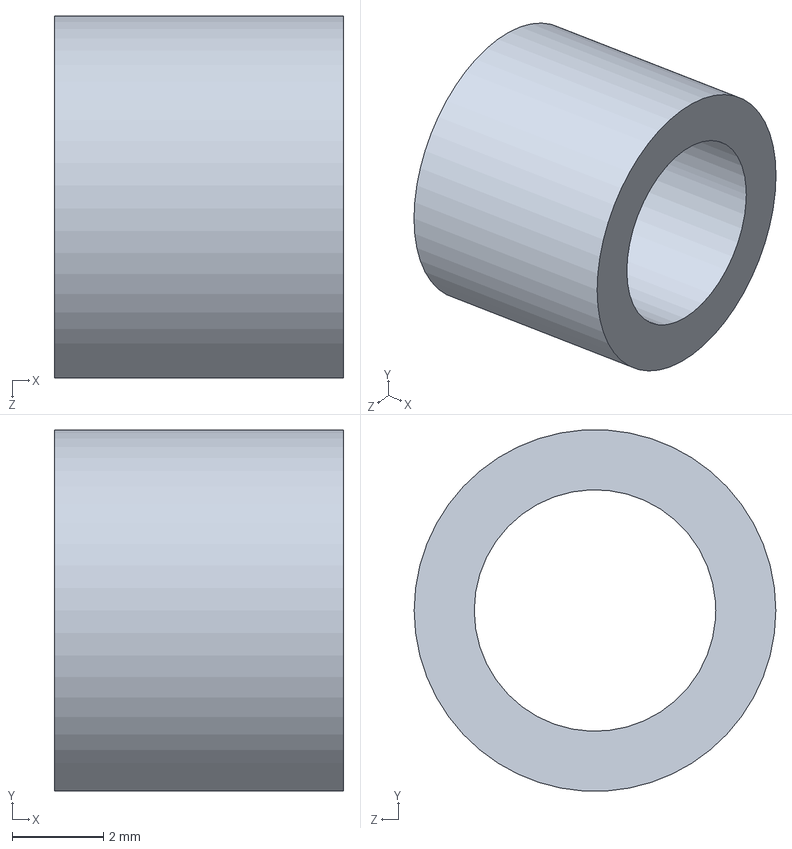
[picture p143: CAD file, 2016-04-22]
Designs/OpenBuilds_r3/12 - Spacers/.25 Inch Nylon Spacer.SLDPRT
6.35 x 7.92 x 7.94 mm
