Yndal/Dispenser-project/Designs/OpenBuilds_r3/3 - Wheels/Delrin Solid V-Wheel.SLDPRT

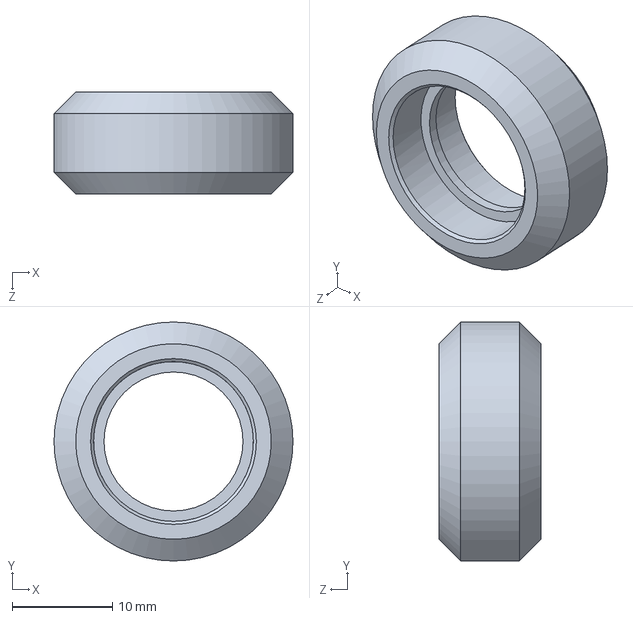
[picture p144: CAD file, 2016-04-22]
Designs/OpenBuilds_r3/3 - Wheels/Delrin Solid V-Wheel.SLDPRT
23.9 x 23.9 x 10.2 mm
