Yndal/Dispenser-project/Designs/OpenBuilds_r3/6 - Brackets/Universal L Bracket - Triple.SLDPRT

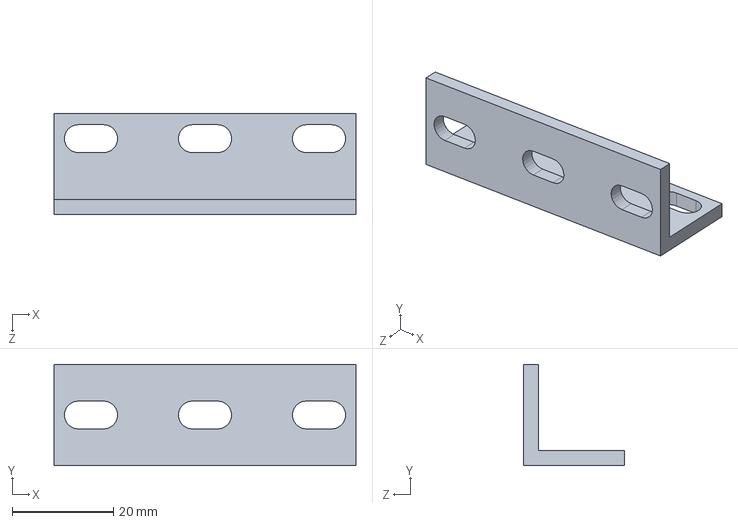
[picture p145: CAD file, 2016-04-22]
Designs/OpenBuilds_r3/6 - Brackets/Universal L Bracket - Triple.SLDPRT
59.6 x 20.0 x 20.0 mm
