Yndal/Dispenser-project/Designs/OpenBuilds_r3/7 - Electronics/NEMA 17 Stepper Motor Shaft.SLDPRT

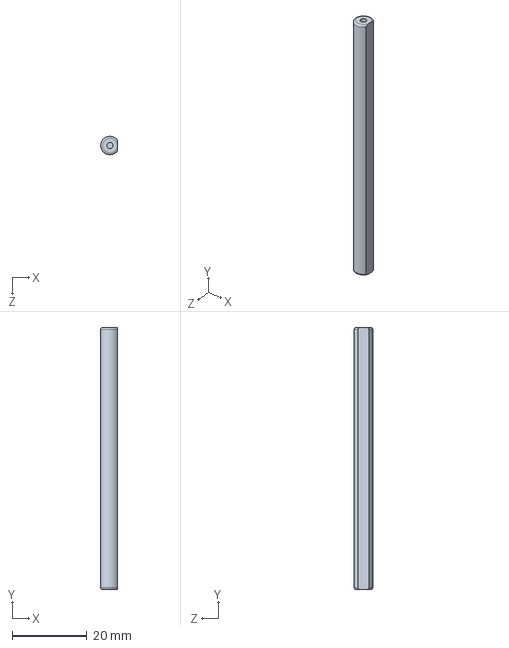
[picture p146: CAD file, 2016-06-13]
Designs/OpenBuilds_r3/7 - Electronics/NEMA 17 Stepper Motor Shaft.SLDPRT
4.50 x 70.3 x 5.00 mm
