Yndal/Dispenser-project/Designs/OpenBuilds_r3/8 - Hardware/Lock Collar 8 mm.SLDPRT

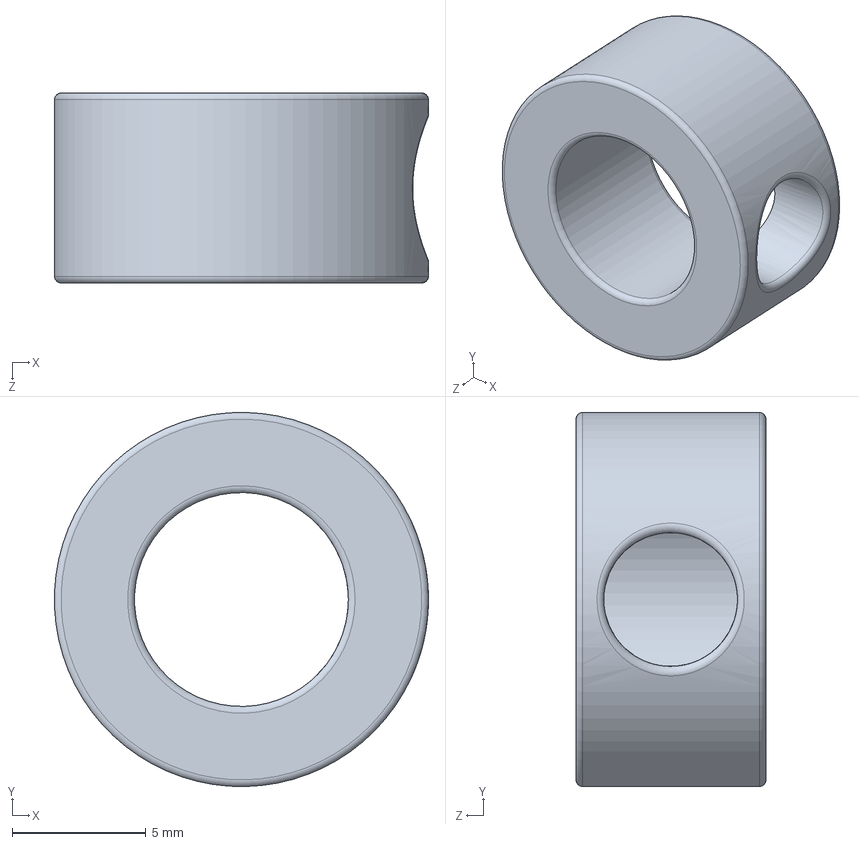
[picture p147: CAD file, 2016-04-22]
Designs/OpenBuilds_r3/8 - Hardware/Lock Collar 8 mm.SLDPRT
14.0 x 14.0 x 7.11 mm
