Yndal/Dispenser-project/Designs/OpenBuilds_r3/9 - Plates/OpenRail Universal Gantry Plate - 20mm.SLDPRT

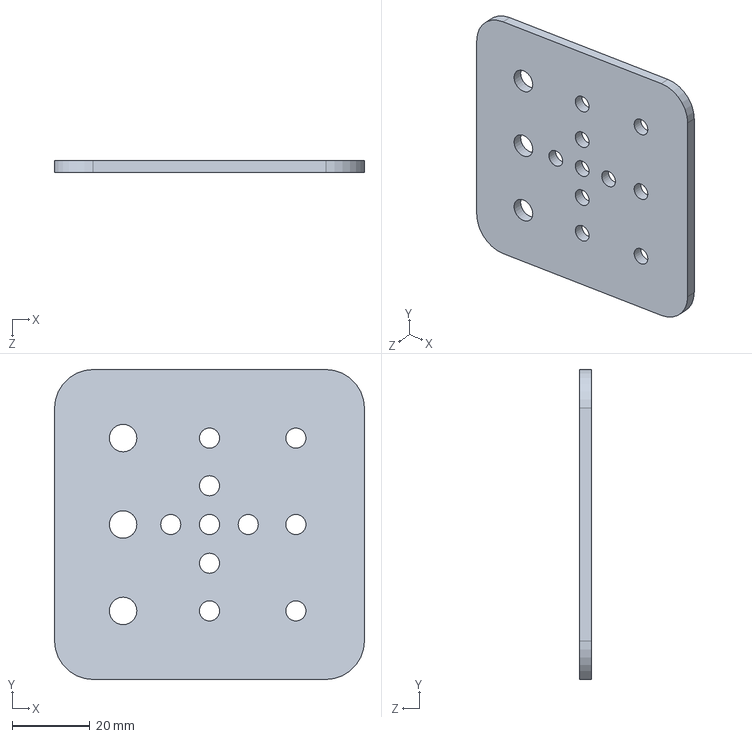
[picture p148: CAD file, 2016-04-22]
Designs/OpenBuilds_r3/9 - Plates/OpenRail Universal Gantry Plate - 20mm.SLDPRT
80.0 x 80.0 x 3.20 mm
