Yndal/Dispenser-project/Designs/SparkFun/Hitec HS-35HD/servo horn.SLDPRT

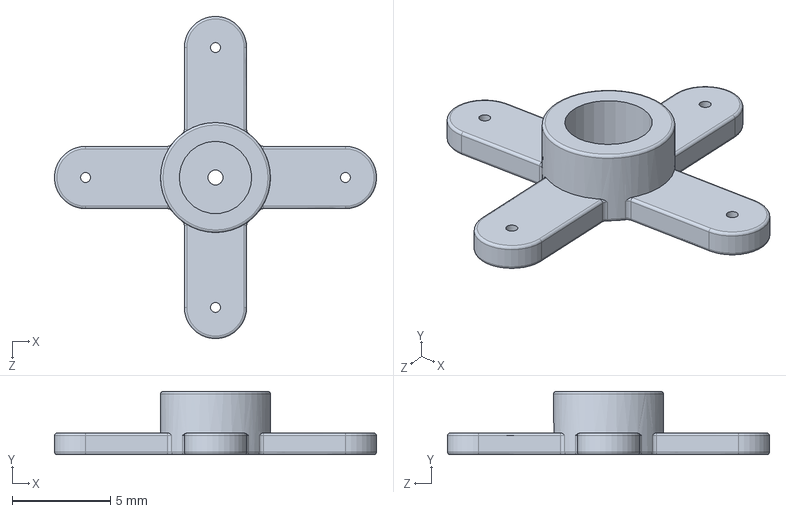
[picture p149: CAD file, 2016-04-22]
Designs/SparkFun/Hitec HS-35HD/servo horn.SLDPRT
16.4 x 3.21 x 16.4 mm
