Yndal/Dispenser-project/Designs/Stack/Sides_wells.SLDPRT

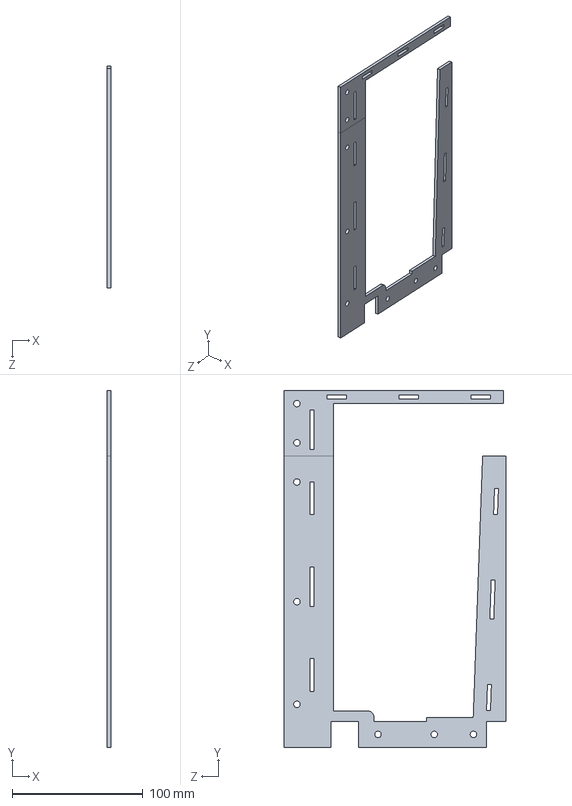
[picture p150: CAD file, 2016-06-13]
Designs/Stack/Sides_wells.SLDPRT
3.00 x 273.0 x 170.0 mm
