Yndal/Dispenser-project/Designs/SW2014 Parts Library 1.1 - orig/1 - Linear Rail/V-Slot 20x60x1500 Linear Rail.SLDPRT

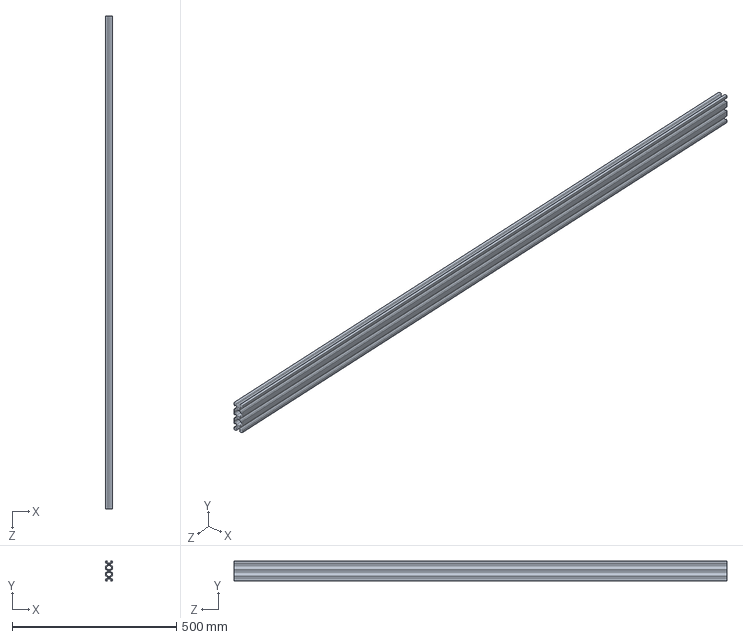
[picture p151: CAD file, 2016-04-22]
Designs/SW2014 Parts Library 1.1 - orig/1 - Linear Rail/V-Slot 20x60x1500 Linear Rail.SLDPRT
20.0 x 60.0 x 1500.0 mm
