Yndal/Dispenser-project/Designs/SW2014 Parts Library 1.1 - orig/10 - Shims and Spacers/Aluminum Spacer .25in.SLDPRT

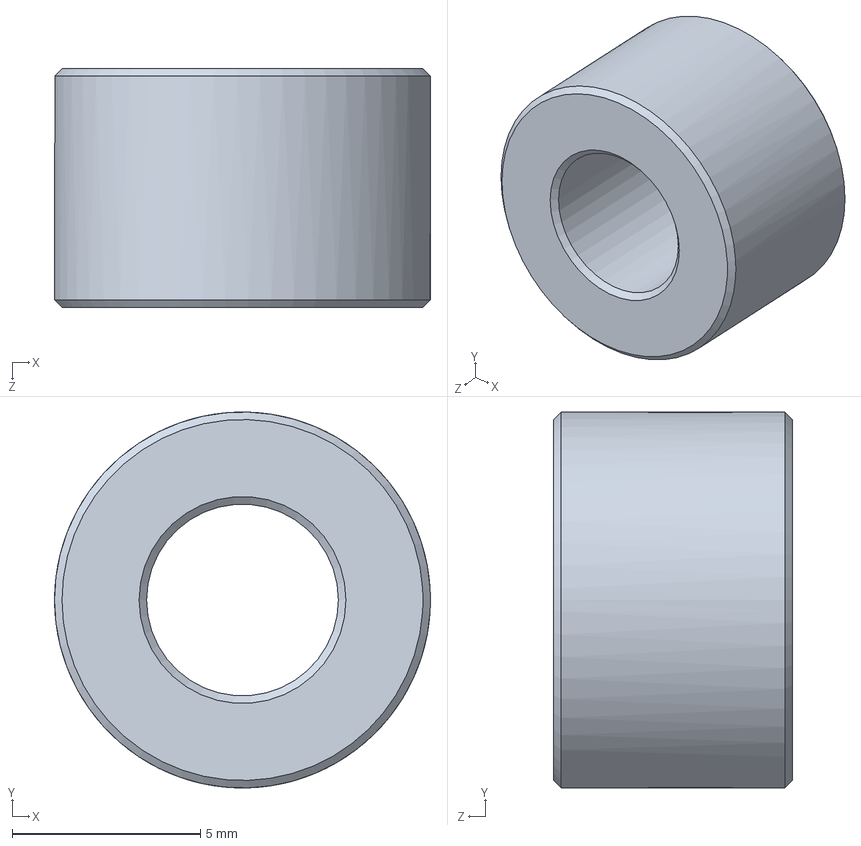
[picture p152: CAD file, 2016-04-22]
Designs/SW2014 Parts Library 1.1 - orig/10 - Shims and Spacers/Aluminum Spacer .25in.SLDPRT
10.0 x 10.00 x 6.35 mm
