Yndal/Dispenser-project/Designs/SW2014 Parts Library 1.1 - orig/3 - Bearings/Ball Bearing 5 x 16 x 5.SLDPRT

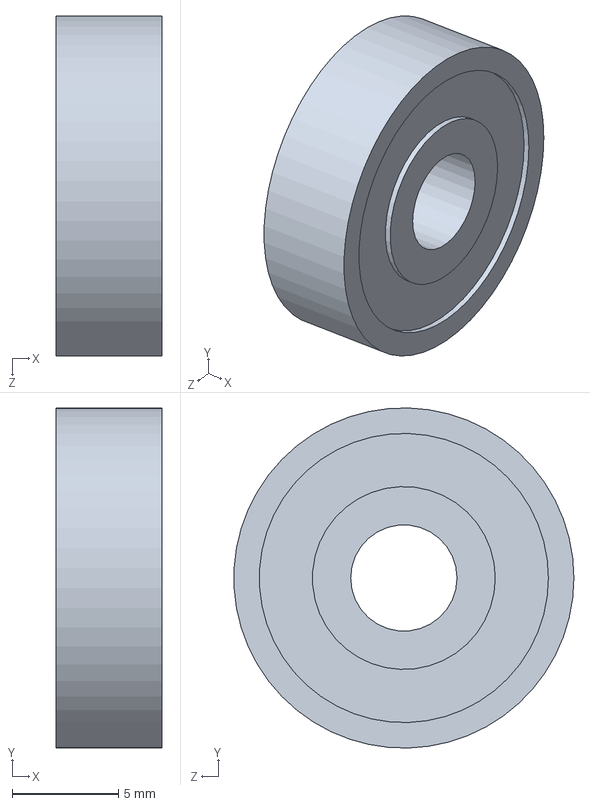
[picture p153: CAD file, 2016-04-22]
Designs/SW2014 Parts Library 1.1 - orig/3 - Bearings/Ball Bearing 5 x 16 x 5.SLDPRT
5.00 x 16.0 x 16.0 mm
