Yndal/Dispenser-project/Designs/SW2014 Parts Library 1.1 - orig/4 - Pulleys/GT2 Timing Pulley 20 Tooth.SLDPRT

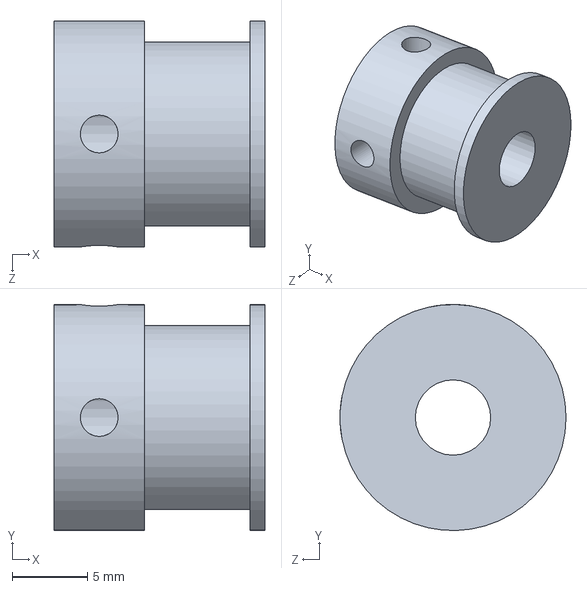
[picture p154: CAD file, 2016-04-22]
Designs/SW2014 Parts Library 1.1 - orig/4 - Pulleys/GT2 Timing Pulley 20 Tooth.SLDPRT
14.0 x 15.0 x 15.0 mm
