Yndal/Dispenser-project/Designs/SW2014 Parts Library 1.1 - orig/8 - Plates/Threaded Rod Plate Nema 17.SLDPRT

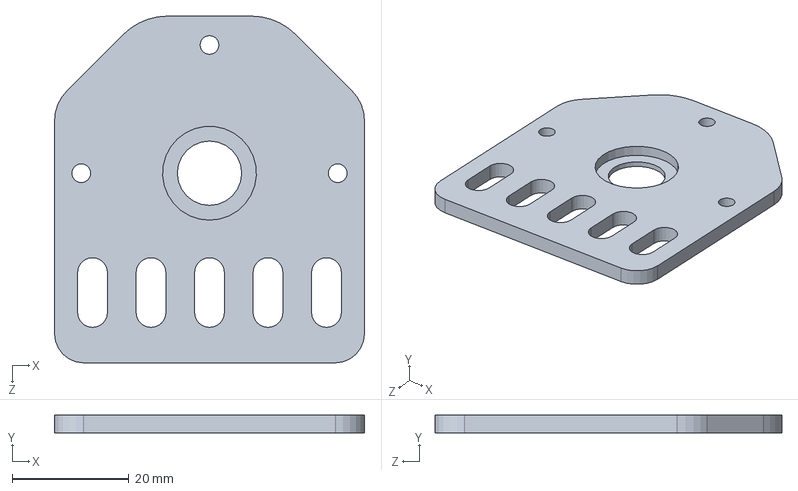
[picture p155: CAD file, 2016-04-22]
Designs/SW2014 Parts Library 1.1 - orig/8 - Plates/Threaded Rod Plate Nema 17.SLDPRT
53.0 x 3.00 x 59.3 mm
