Yndal/Dispenser-project/Designs/User Library-Parallax Ping Sensor/3 Pin Header 90 Degree.SLDPRT

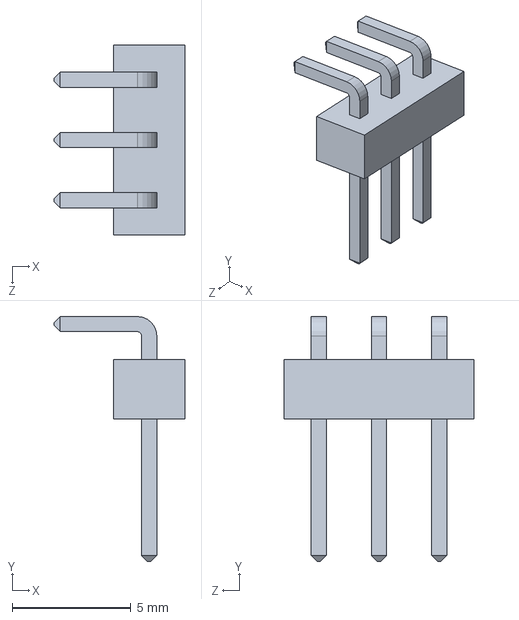
[picture p156: CAD file, 2016-06-13]
Designs/User Library-Parallax Ping Sensor/3 Pin Header 90 Degree.SLDPRT
5.50 x 10.3 x 8.00 mm
