Yndal/Dispenser-project/Designs/Vertical axis/V-Slot 20x80x500 Linear Rail.SLDPRT

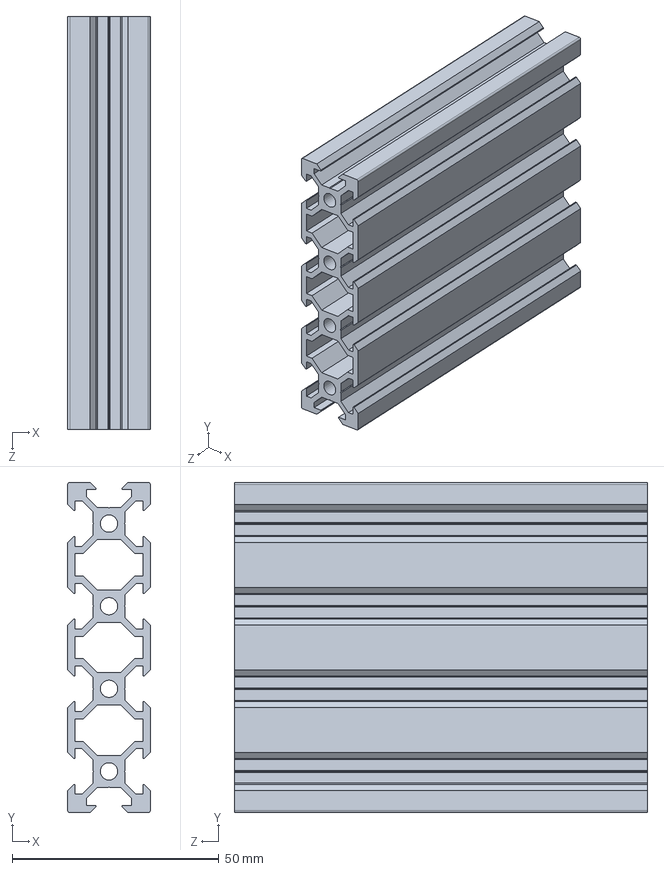
[picture p157: CAD file, 2016-04-22]
Designs/Vertical axis/V-Slot 20x80x500 Linear Rail.SLDPRT
20.0 x 80.0 x 100.0 mm
