Yndal/Dispenser-project/Designs/Gripper/Grip1.SLDPRT

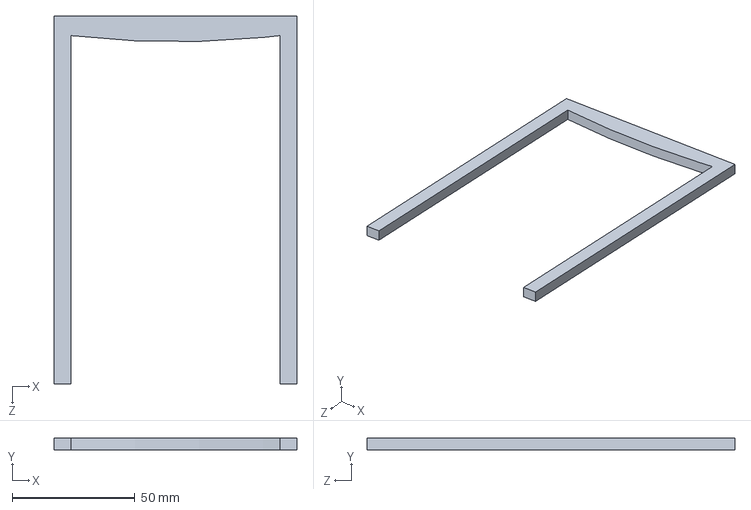
[picture p158: CAD file, 2016-04-22]
Designs/Gripper/Grip1.SLDPRT
99.0 x 5.00 x 150.0 mm
