Yndal/Dispenser-project/Designs/OpenBuilds_r3/1 - V-Slot/V-Slot 20mm x 80mm x 1000mm.SLDPRT

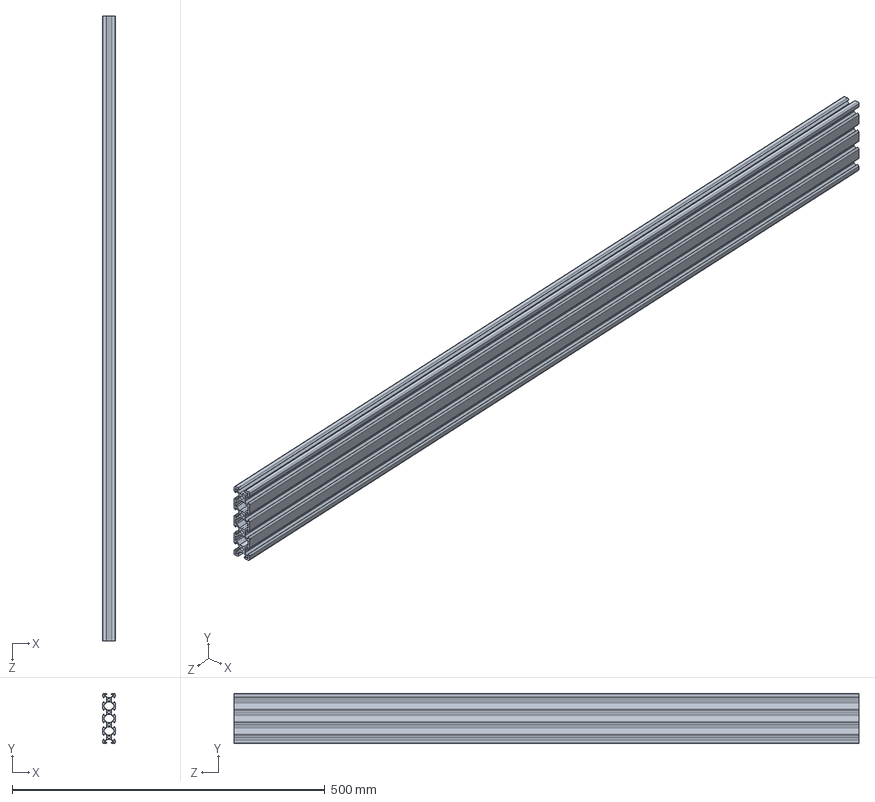
[picture p159: CAD file, 2016-04-22]
Designs/OpenBuilds_r3/1 - V-Slot/V-Slot 20mm x 80mm x 1000mm.SLDPRT
20.0 x 80.0 x 1000.0 mm
