Yndal/Dispenser-project/Designs/OpenBuilds_r3/12 - Spacers/1.5 inch Aluminum Spacer.SLDPRT

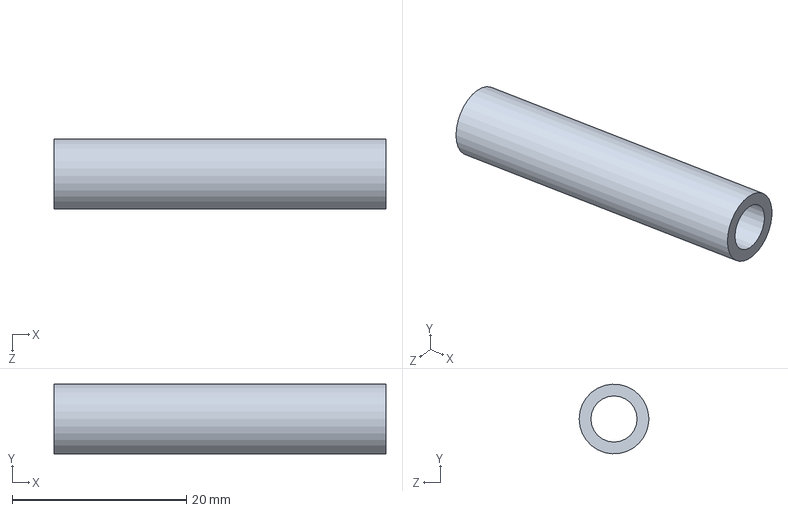
[picture p160: CAD file, 2016-04-22]
Designs/OpenBuilds_r3/12 - Spacers/1.5 inch Aluminum Spacer.SLDPRT
38.1 x 7.99 x 8.00 mm
