Yndal/Dispenser-project/Designs/OpenBuilds_r3/6 - Brackets/Universal L Bracket -Single.SLDPRT

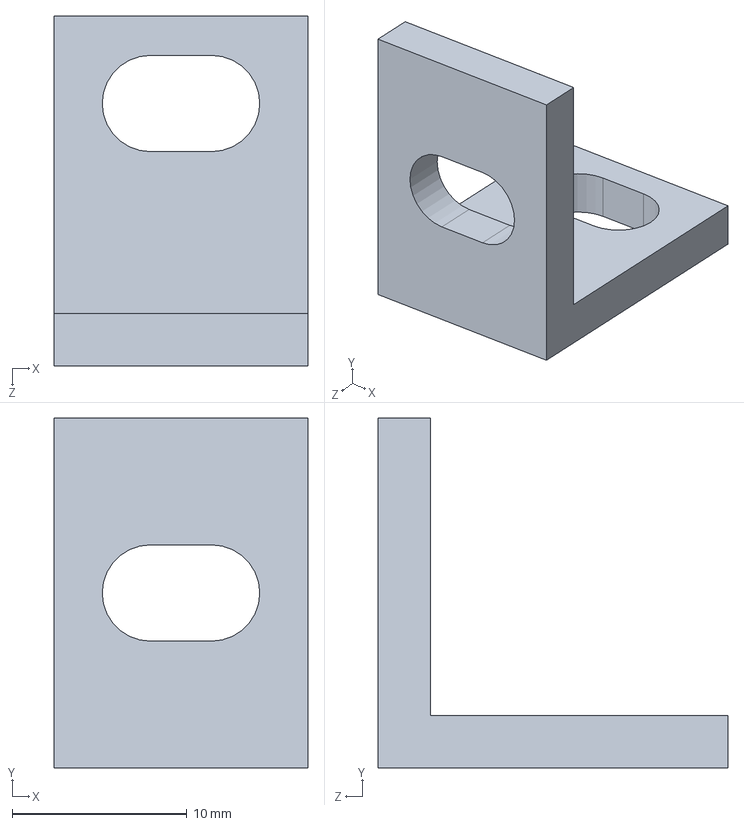
[picture p161: CAD file, 2016-04-22]
Designs/OpenBuilds_r3/6 - Brackets/Universal L Bracket -Single.SLDPRT
14.5 x 20.0 x 20.0 mm
