Yndal/Dispenser-project/Designs/OpenBuilds_r3/7 - Electronics/Limitt Switch Mounting Plate.SLDPRT

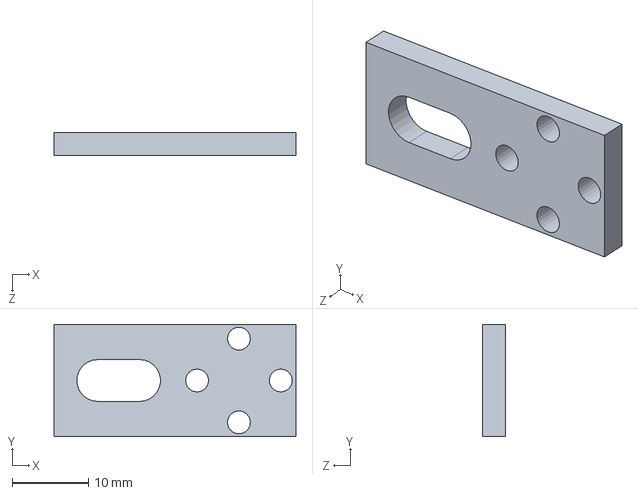
[picture p162: CAD file, 2016-04-22]
Designs/OpenBuilds_r3/7 - Electronics/Limitt Switch Mounting Plate.SLDPRT
31.8 x 14.8 x 3.00 mm
