Yndal/Dispenser-project/Designs/Stack/Sides.SLDPRT

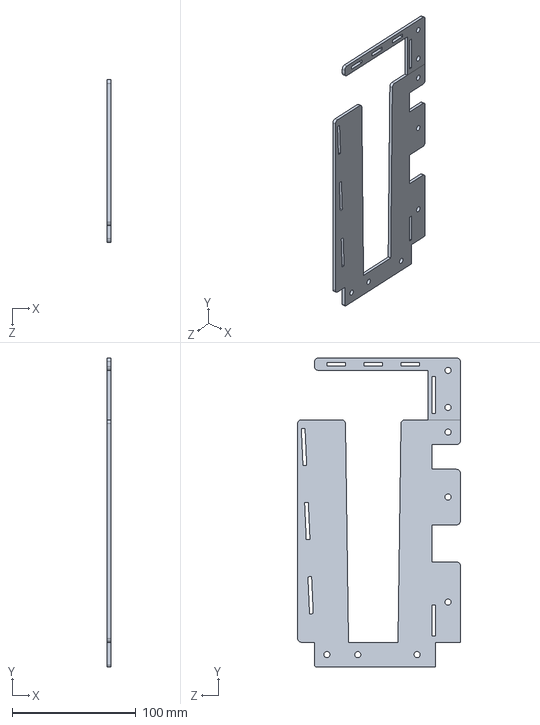
[picture p163: CAD file, 2016-06-13]
Designs/Stack/Sides.SLDPRT
3.00 x 250.0 x 131.7 mm
