Yndal/Dispenser-project/Designs/SW2014 Parts Library 1.1 - orig/1 - Linear Rail/V-Slot 20x40x1000 Linear Rail.SLDPRT

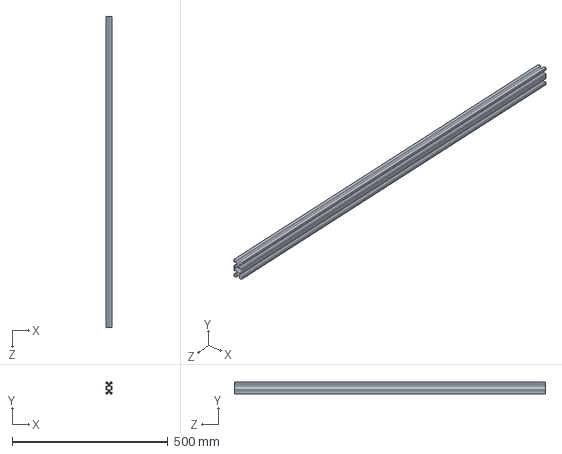
[picture p164: CAD file, 2016-04-22]
Designs/SW2014 Parts Library 1.1 - orig/1 - Linear Rail/V-Slot 20x40x1000 Linear Rail.SLDPRT
20.0 x 40.0 x 1000.0 mm
