Yndal/Dispenser-project/(list of files, cad)

Other CAD files:
Designs/SW2014 Parts Library 1.1 - orig/Assemblies/Wheels/Delrin Mini V Wheel.SLDASM
Designs/OpenBuilds_r3/Assemblies/V-Slot Delrin Dual Wheel Bracket Assembly.SLDASM
Designs/OpenBuilds_r3/8 - Hardware/5mm x 6mm Flexible Coupling.SLDASM
Designs/OpenBuilds_r3/9 - Plates/Universal Build Plate with Delrin V-Wheels - 20mm Spacing.SLDASM
Designs/SW2014 Parts Library 1.1 - orig/2 - Wheels/Delrin V Wheel.SLDPRT
Designs/SW2014 Parts Library 1.1 - orig/3 - Bearings/Ball Bearing 8 x 16 x 5.SLDPRT
Designs/SW2014 Parts Library 1.1 - orig/5 - Brackets/Cube Corner Connector.SLDPRT
Designs/Igus/Rail_NK_02_17_01_200_1.SLDPRT
Designs/OpenBuilds_r3/3 - Wheels/Delrin Dual V-Wheel.SLDPRT
Designs/SW2014 Parts Library 1.1 - orig/1 - Linear Rail/Open Rail 1000mm.SLDPRT
Designs/SW2014 Parts Library 1.1 - orig/10 - Shims and Spacers/Precision Shim 8 x 5 x 1.SLDPRT
Designs/SW2014 Parts Library 1.1 - orig/2 - Wheels/Metal V Wheel.SLDPRT
Designs/SW2014 Parts Library 1.1 - orig/8 - Plates/V-Slot Gantry Plate 20-80mm.SLDPRT
Designs/OpenBuilds_r3/4 - Bearings/Mini Ball Bearing.SLDPRT
Designs/SW2014 Parts Library 1.1 - orig/2 - Wheels/Solid V Wheel.SLDPRT
Designs/SW2014 Parts Library 1.1 - orig/5 - Brackets/L Bracket Double.SLDPRT
Designs/Frame/LeadScrewGuide.SLDPRT
Designs/Gripper/Delrin V Wheel.SLDPRT
Designs/Gripper/Grip2.SLDPRT
Designs/Gripper/HX5010 SERVO.SLDPRT
Designs/OpenBuilds_r3/1 - V-Slot/V-Slot 20mm x 20mm x 1000mm.IGS
Designs/OpenBuilds_r3/1 - V-Slot/V-Slot 20mm x 20mm x 1000mm.STL
Designs/OpenBuilds_r3/1 - V-Slot/V-Slot 20mm x 20mm x 1000mm.x_t
Designs/OpenBuilds_r3/1 - V-Slot/V-Slot 20mm x 40mm x 1000mm.STL
Designs/OpenBuilds_r3/1 - V-Slot/V-Slot 20mm x 40mm x 1000mm.x_t
Designs/OpenBuilds_r3/1 - V-Slot/V-Slot 20mm x 60mm x 1000mm.IGS
Designs/OpenBuilds_r3/1 - V-Slot/V-Slot 20mm x 60mm x 1000mm.STL
Designs/OpenBuilds_r3/1 - V-Slot/V-Slot 20mm x 60mm x 1000mm.x_t
Designs/OpenBuilds_r3/1 - V-Slot/V-Slot 20mm x 80mm x 1000mm.IGS
Designs/OpenBuilds_r3/1 - V-Slot/V-Slot 20mm x 80mm x 1000mm.STL
Designs/OpenBuilds_r3/1 - V-Slot/V-Slot 20mm x 80mm x 1000mm.x_t
Designs/OpenBuilds_r3/10 - Screws/5mm Low Profile Socket Head Screw - Multiple Lengths.SLDPRT
Designs/OpenBuilds_r3/10 - Screws/5mm x 25mm Low Profile Socket Head Screw.SLDPRT
Designs/OpenBuilds_r3/10 - Screws/5mm x 8mm Low Profile Socket Head Screw.SLDPRT
Designs/OpenBuilds_r3/10 - Screws/Low Profile Socket Head Screw.SLDPRT
Designs/OpenBuilds_r3/11 - Shims/5mm Precision Washer.SLDPRT
Designs/OpenBuilds_r3/11 - Shims/Slot Washer - 12 x 5 x 1.5mm.SLDPRT
Designs/OpenBuilds_r3/12 - Spacers/Steel Eccentric Spacer.SLDPRT
Designs/OpenBuilds_r3/2 - OpenRail/Open Rail 1000mm.IGS
Designs/OpenBuilds_r3/2 - OpenRail/Open Rail 1000mm.STL
Designs/OpenBuilds_r3/2 - OpenRail/Open Rail 1000mm.sldprt
Designs/OpenBuilds_r3/2 - OpenRail/Open Rail 1000mm.x_t
Designs/OpenBuilds_r3/2 - OpenRail/Open Rail 1500mm.IGS
Designs/OpenBuilds_r3/2 - OpenRail/Open Rail 1500mm.STL
Designs/OpenBuilds_r3/2 - OpenRail/Open Rail 1500mm.x_t
Designs/OpenBuilds_r3/2 - OpenRail/Open Rail 500mm.IGS
Designs/OpenBuilds_r3/2 - OpenRail/Open Rail 500mm.STL
Designs/OpenBuilds_r3/2 - OpenRail/Open Rail 500mm.x_t
Designs/OpenBuilds_r3/6 - Brackets/3_way_cube_connector.SLDPRT
Designs/OpenBuilds_r3/6 - Brackets/90 Degree Angle Corner Connectr - V-Slot.SLDPRT
Designs/OpenBuilds_r3/6 - Brackets/Cast - 90 Degree Corner Bracket.SLDPRT
Designs/OpenBuilds_r3/6 - Brackets/End Cap English.SLDPRT
Designs/OpenBuilds_r3/6 - Brackets/End Cap V-Slot.SLDPRT
Designs/OpenBuilds_r3/6 - Brackets/V-Slot Actuator End Mount no Bolts.SLDPRT
Designs/OpenBuilds_r3/6 - Brackets/V-Slot Actuator End Mount.SLDPRT
Designs/OpenBuilds_r3/6 - Brackets/V-Slot Door Handle.SLDPRT
Designs/OpenBuilds_r3/6 - Brackets/corner_connector_90deg.SLDPRT
Designs/OpenBuilds_r3/6 - Brackets/corner_connector_90deg.STL
Designs/OpenBuilds_r3/6 - Brackets/end_cap.SLDPRT
Designs/OpenBuilds_r3/7 - Electronics/Micro Limit Switch.SLDPRT
Designs/OpenBuilds_r3/7 - Electronics/NEMA 14 Stepper Motor.SLDPRT
Designs/OpenBuilds_r3/7 - Electronics/NEMA 17 Stepper Motor Assembly.IGS
Designs/OpenBuilds_r3/7 - Electronics/NEMA 17 Stepper Motor Assembly.SLDASM
Designs/OpenBuilds_r3/7 - Electronics/NEMA 8 Stepper Motor (Pololu 1204).SLDPRT
Designs/OpenBuilds_r3/8 - Hardware/.25 inch x 5mm Flexible Coupling.SLDPRT
Designs/OpenBuilds_r3/8 - Hardware/5mm x 6mm Flexible Coupling.SLDPRT
Designs/OpenBuilds_r3/8 - Hardware/5mm x 8mm Flexible Coupling.SLDPRT
Designs/OpenBuilds_r3/8 - Hardware/8mm Acme Nut Block.SLDPRT
Designs/OpenBuilds_r3/8 - Hardware/8mm TR8_8 Leadscrew.SLDPRT
Designs/OpenBuilds_r3/8 - Hardware/Double Tee Nut.SLDPRT
Designs/OpenBuilds_r3/8 - Hardware/Lock Collar .25 inch.SLDPRT
Designs/OpenBuilds_r3/8 - Hardware/Mounting Hub 5mm.SLDPRT
Designs/OpenBuilds_r3/8 - Hardware/Nylon Insert Hex Locknut 5mm.SLDPRT
Designs/OpenBuilds_r3/8 - Hardware/Tee nut.SLDPRT
Designs/OpenBuilds_r3/8 - Hardware/V-Slot Acme Nut Plate.SLDPRT
Designs/OpenBuilds_r3/9 - Plates/2 Hole Joining Strip Plate.SLDPRT
Designs/OpenBuilds_r3/9 - Plates/3 Hole Strip Joining Plate.SLDPRT
Designs/OpenBuilds_r3/9 - Plates/5 Hole 90 Degree Joining Plate.SLDPRT
Designs/OpenBuilds_r3/9 - Plates/5 Hole T Joining Plate.SLDPRT
Designs/OpenBuilds_r3/9 - Plates/7 Hole Cross Joining Plate.SLDPRT
Designs/OpenBuilds_r3/9 - Plates/Mini V-Plate.SLDPRT
Designs/OpenBuilds_r3/9 - Plates/OpenRail Universal Gantry Plate - 40mm.SLDPRT
Designs/OpenBuilds_r3/9 - Plates/OpenRail Universal Gantry Plate - 60mm.SLDPRT
Designs/OpenBuilds_r3/9 - Plates/OpenRail Universal Gantry Plate - 80mm.SLDPRT
Designs/OpenBuilds_r3/9 - Plates/V-Slot Motor Mount Plate.SLDPRT
Designs/OpenBuilds_r3/9 - Plates/V-Slot Spacer Block.SLDPRT
Designs/OpenBuilds_r3/9 - Plates/V-Slot Threaded Rod Plate.SLDPRT
Designs/OpenBuilds_r3/Assemblies/5 Hole 90 Degree Bracket with Bolts - Left Hand.SLDASM
Designs/OpenBuilds_r3/Assemblies/5 Hole 90 Degree Bracket with Bolts.SLDASM
Designs/OpenBuilds_r3/Assemblies/5mm x 8mm Bolt with Tee Nut.SLDASM
Designs/OpenBuilds_r3/Assemblies/Double Universal L-Bracket with Bolts and Tee Nuts.SLDASM
Designs/OpenBuilds_r3/screws_nuts_washers_and_related/3coner_connector.SLDPRT
Designs/OpenBuilds_r3/screws_nuts_washers_and_related/Solid V Wheel.SLDASM
Designs/OpenBuilds_r3/screws_nuts_washers_and_related/base_connector.SLDPRT
Designs/OpenBuilds_r3/screws_nuts_washers_and_related/button_screw.SLDPRT
Designs/OpenBuilds_r3/screws_nuts_washers_and_related/coner_connector.SLDPRT
Designs/OpenBuilds_r3/screws_nuts_washers_and_related/cross_dowel.SLDPRT
Designs/OpenBuilds_r3/screws_nuts_washers_and_related/insert_microbarb_0006M2.SLDPRT
Designs/OpenBuilds_r3/screws_nuts_washers_and_related/insert_microbarb_0006M3.SLDPRT
Designs/OpenBuilds_r3/screws_nuts_washers_and_related/insert_microbarb_0006M5.SLDPRT
Designs/OpenBuilds_r3/screws_nuts_washers_and_related/nyloc.SLDPRT
Designs/OpenBuilds_r3/screws_nuts_washers_and_related/socket_screw.SLDPRT
Designs/OpenBuilds_r3/screws_nuts_washers_and_related/spacer_6mm_height.SLDPRT
Designs/OpenBuilds_r3/screws_nuts_washers_and_related/spacer_M2x3mm.SLDPRT
Designs/OpenBuilds_r3/screws_nuts_washers_and_related/stl/3coner_connector.STL
Designs/OpenBuilds_r3/screws_nuts_washers_and_related/stl/base_connector.SLDPRT
Designs/OpenBuilds_r3/screws_nuts_washers_and_related/stl/base_connector.STL
Designs/OpenBuilds_r3/screws_nuts_washers_and_related/stl/bottom_connector.STL
Designs/OpenBuilds_r3/screws_nuts_washers_and_related/stl/coner_connector_left.STL
Designs/OpenBuilds_r3/screws_nuts_washers_and_related/stl/coner_connector_right.STL
Designs/OpenBuilds_r3/screws_nuts_washers_and_related/stl/syringe_spacer.STL
Designs/OpenBuilds_r3/screws_nuts_washers_and_related/stl/syringe_spacer_old.STL
Designs/OpenBuilds_r3/screws_nuts_washers_and_related/stl/upper_connector.STL
Designs/OpenBuilds_r3/screws_nuts_washers_and_related/syringe_spacer.SLDPRT
Designs/OpenBuilds_r3/screws_nuts_washers_and_related/washer.SLDPRT
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
