Yndal/Dispenser-project/(commit log)

2016-04-22 Version 1
    [.125 Inch Aluminum Spacer.SLDPRT, .125 Inch Nylon Spacer.SLDPRT, .25 Inch Aluminum Spacer.SLDPRT, .25 Inch Nylon Spacer.SLDPRT, .25 inch x 5mm Flexible Coupling.SLDASM, .25 inch x 5mm Flexible Coupling.SLDPRT, 1.5 inch Aluminum Spacer.SLDPRT, 12228-Gear-HubMount84T05Bore.SLDPRT]
2016-06-13 After exam. Heavy additions and changes in code. Robot is actually working
    [14 Pin SMT.SLDPRT, 3 Pin Header 90 Degree.SLDPRT, Arm.SLDPRT, Cap1 SMT.SLDPRT, ElectronicsPlatform.SLDPRT, EndPieceForElectronics.SLDPRT, FrontBack.SLDPRT, FrontBack_wells.SLDPRT]
